on6315/ADEPT_DEP_Module/README.md

# ADEPT_DEP_Module
Adaptable Dielectrophoresis Embedded Platform Tool (ADEPT) 
PCB Hardware design files and corresponding software codes for manufacturing and operating ADEPT for single cell manipulation.
