on6315/ADEPT_DEP_Module/ADEPT_Sotware_Files/ADEPT_Mathematica_File/Readme

Mathematica simulation file with six voltage amplitude manipulators to control the voltage of the six individual electrodes and visualize the electric field pattern.
