on6315/ADEPT_DEP_Module/ADEPT_Sotware_Files/Arduino/Readme

Arduino code along with C++ libary and header file to control the ADEPT.
