on6315/ADEPT_DEP_Module/(threads)

Thread 1 (2023-04-11):

Question about comsol simulation

giannis98, 2023-04-11:
Hello
I am a graduate student in the field of dielectrophoresis, and I am very interested in your thesis. Can you provide the comsol simulation file,？
Best regards

DadachaorenAB2, 2023-11-13:
ui偶i
