on6315/ADEPT_DEP_Module/ADEPT_PCB_Hardware_Files/circuit_DEP-F_Cu.pdf

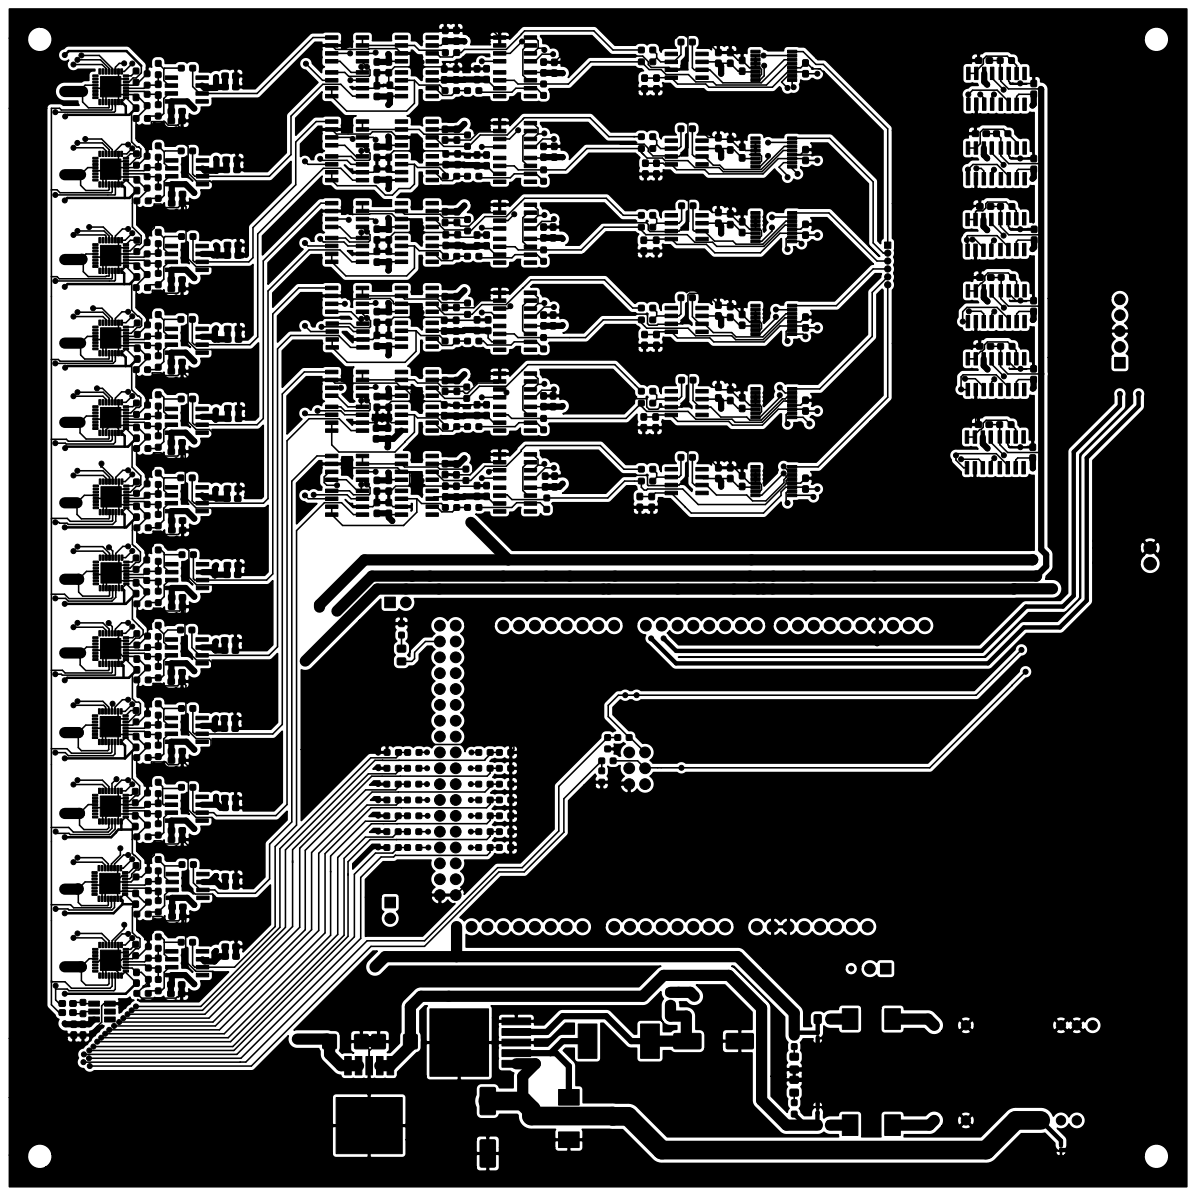
[picture p1: page 1]
