on6315/ADEPT_DEP_Module/ADEPT_PCB_Hardware_Files/circuit_DEP.kicad_pcb

## KiCad design ADEPT_PCB_Hardware_Files/circuit_DEP.kicad_pcb (2023-02-24)

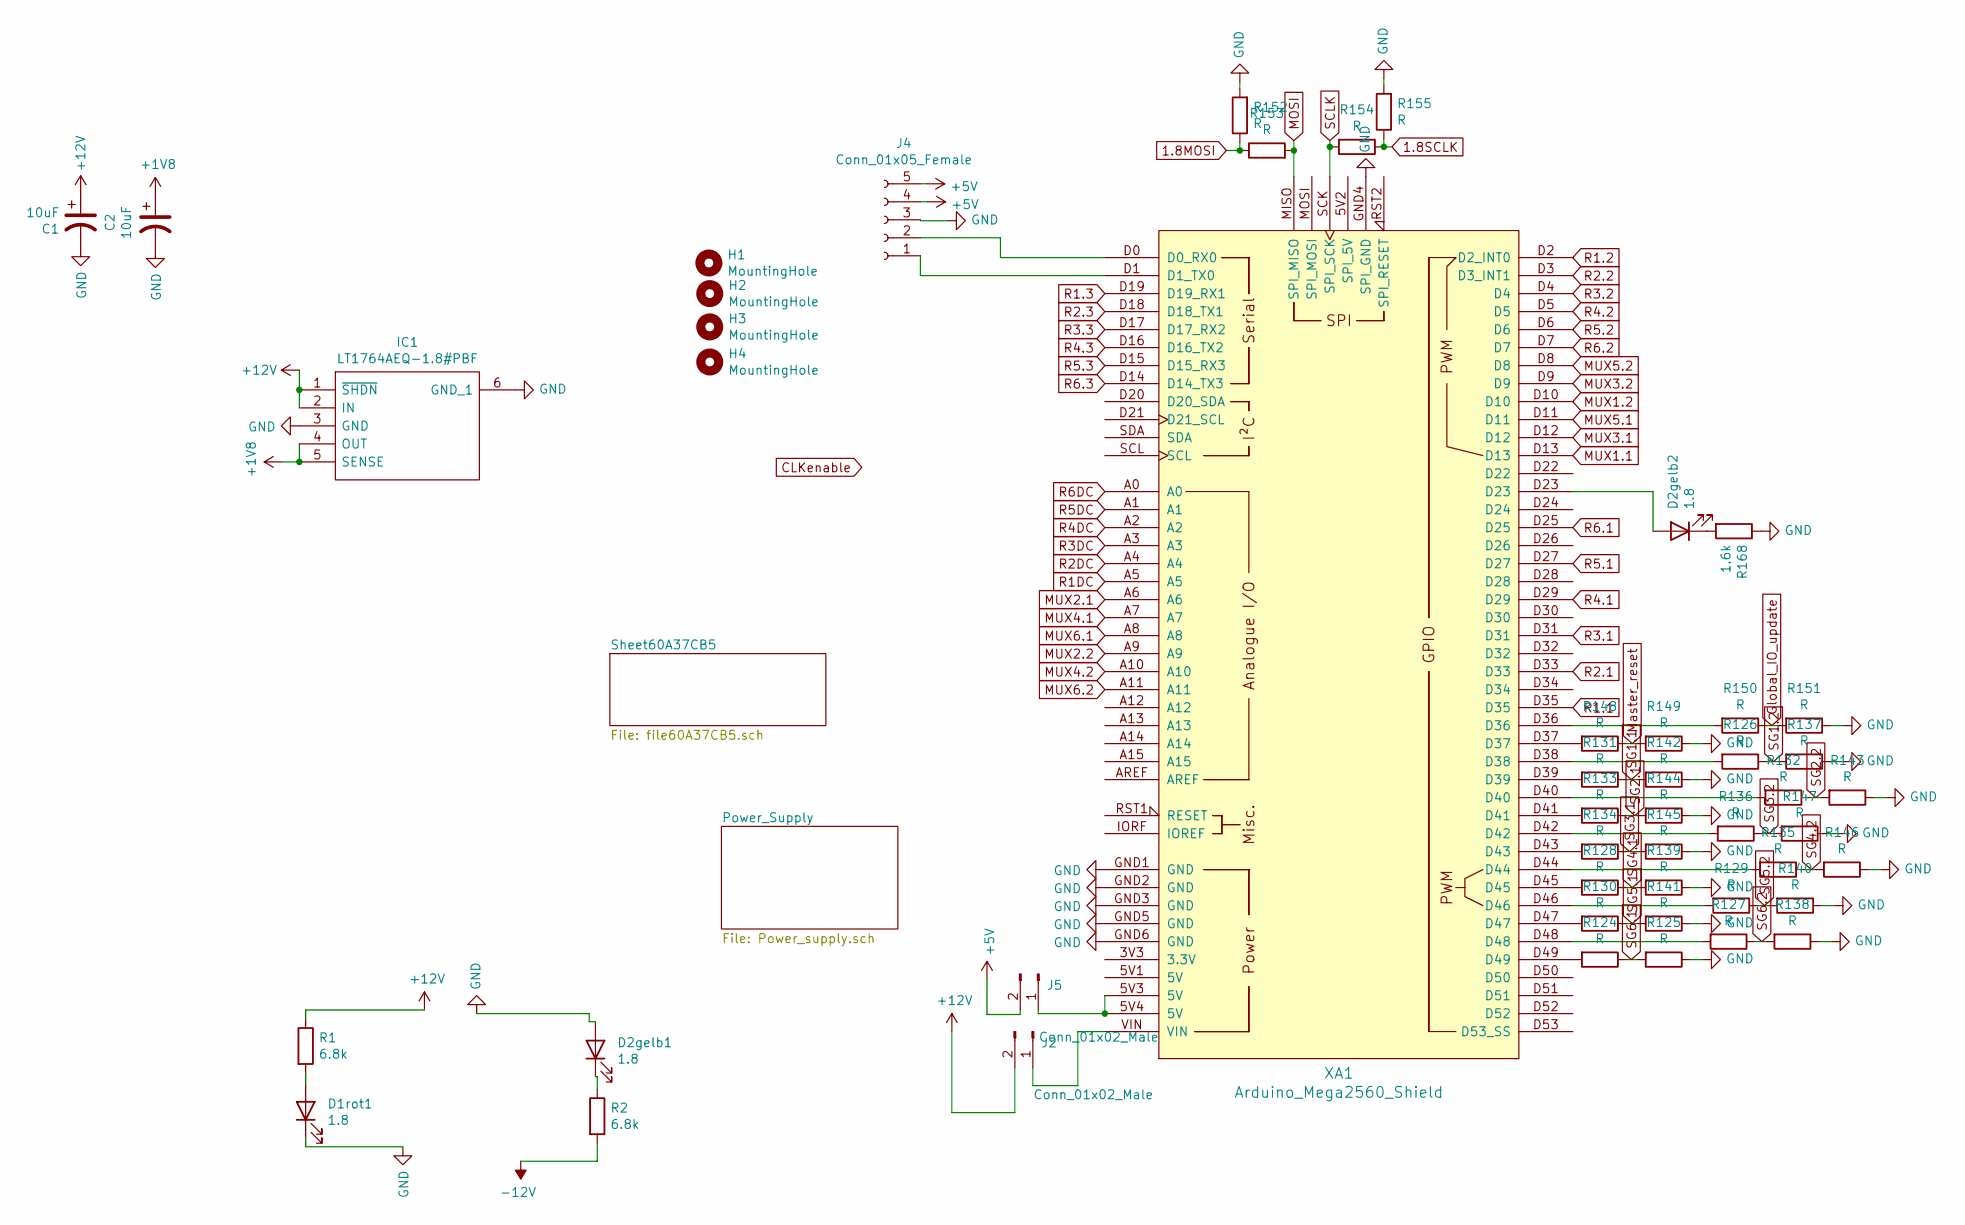
[picture p2: schematic circuit_DEP.sch]

Parts:
C1, C2: 10uF; CP_EIA-6032-28_Kemet-C_Pad2.25x2.35mm_HandSolder
D1rot1, D2gelb1, D2gelb2: 1.8; D_0805_2012Metric_Pad1.15x1.40mm_HandSolder
H1, H2, H3, H4: MountingHole; MountingHole_2.7mm
IC1: LT1764AEQ-1.8#PBF; TO170P1394X457-6N; Manufacturer_Part_Number LT1764AEQ-1.8#PBF; Mouser Part Number 584-LT1764AEQ-1.8PBF
J2, J5: Conn_01x02_Male; PinHeader_1x02_P2.54mm_Vertical
J4: Conn_01x05_Female; PinSocket_1x05_P2.54mm_Vertical
R1, R2: 6.8k; R_0603_1608Metric_Pad0.98x0.95mm_HandSolder
R124, R125, R126, R127, R128, R129, R130, R131, R132, R133, R134, R135, R136, R137, R138, R139, R140, R141, R142, R143, R144, R145, R146, R147, R148, R149, R150, R151, R152, R153, R154, R155: R; R_0603_1608Metric_Pad0.98x0.95mm_HandSolder
R168: 1.6k; R_0603_1608Metric_Pad0.98x0.95mm_HandSolder
XA1: Arduino_Mega2560_Shield

Connections:
1.8MOSI: R152.1, R153.1; also elsewhere on the board
1.8SCLK: R154.1, R155.1; also elsewhere on the board
+1V8: C2.1, IC1.4 (OUT), IC1.5 (SENSE); also elsewhere on the board
+5V: J4.4, J4.5, J5.2; also elsewhere on the board
+12V: C1.1, IC1.1 (~SHDN), IC1.2 (IN), J2.2, R1.1; also elsewhere on the board
-12V: R2.2; also elsewhere on the board
GND: C1.2, C2.2, D1rot1.1 (K), D2gelb1.2 (A), IC1.3 (GND), IC1.6 (GND_1), J4.3, R125.1, R137.1, R138.1, R139.1, R140.1, R141.1, R142.1, R143.1, R144.1, R145.1, R146.1, R147.1, R149.1, R151.1, R152.2, R155.2, R168.1, XA1.GND1 (GND), XA1.GND2 (GND), XA1.GND3 (GND), XA1.GND4 (SPI_GND), XA1.GND5 (GND), XA1.GND6 (GND); also elsewhere on the board
Global_IO_update: R150.1, R151.2; also elsewhere on the board
MOSI: R153.2, XA1.MISO (SPI_MISO); also elsewhere on the board
MUX1.1: XA1.D13; also elsewhere on the board
MUX1.2: XA1.D10; also elsewhere on the board
MUX2.1: XA1.A6; also elsewhere on the board
MUX2.2: XA1.A9; also elsewhere on the board
MUX3.1: XA1.D12; also elsewhere on the board
MUX3.2: XA1.D9; also elsewhere on the board
MUX4.1: XA1.A7; also elsewhere on the board
MUX4.2: XA1.A10; also elsewhere on the board
MUX5.1: XA1.D11; also elsewhere on the board
MUX5.2: XA1.D8; also elsewhere on the board
MUX6.1: XA1.A8; also elsewhere on the board
MUX6.2: XA1.A11; also elsewhere on the board
Master_reset: R148.1, R149.2; also elsewhere on the board
unnamed: D1rot1.2 (A), R1.2
unnamed: D2gelb1.1 (K), R2.1
unnamed: D2gelb2.1 (K), R168.2
unnamed: D2gelb2.2 (A), XA1.D23
unnamed: J2.1, XA1.VIN
unnamed: J4.1, XA1.D1 (D1_TX0)
unnamed: J4.2, XA1.D0 (D0_RX0)
unnamed: J5.1, XA1.5V3 (5V), XA1.5V4 (5V)
unnamed: R124.2, XA1.D49
unnamed: R126.2, XA1.D38
unnamed: R127.2, XA1.D48
unnamed: R128.2, XA1.D45
unnamed: R129.2, XA1.D46
unnamed: R130.2, XA1.D47
unnamed: R131.2, XA1.D39
unnamed: R132.2, XA1.D40
unnamed: R133.2, XA1.D41
unnamed: R134.2, XA1.D43
unnamed: R135.2, XA1.D44
unnamed: R136.2, XA1.D42
unnamed: R148.2, XA1.D37
unnamed: R150.2, XA1.D36
R1.1: XA1.D35; also elsewhere on the board
R1.2: XA1.D2 (D2_INT0); also elsewhere on the board
R1.3: XA1.D19 (D19_RX1); also elsewhere on the board
R1DC: XA1.A5; also elsewhere on the board
R2.1: XA1.D33; also elsewhere on the board
R2.2: XA1.D3 (D3_INT1); also elsewhere on the board
R2.3: XA1.D18 (D18_TX1); also elsewhere on the board
R2DC: XA1.A4; also elsewhere on the board
R3.1: XA1.D31; also elsewhere on the board
R3.2: XA1.D4; also elsewhere on the board
R3.3: XA1.D17 (D17_RX2); also elsewhere on the board
R3DC: XA1.A3; also elsewhere on the board
R4.1: XA1.D29; also elsewhere on the board
R4.2: XA1.D5; also elsewhere on the board
R4.3: XA1.D16 (D16_TX2); also elsewhere on the board
R4DC: XA1.A2; also elsewhere on the board
R5.1: XA1.D27; also elsewhere on the board
R5.2: XA1.D6; also elsewhere on the board
R5.3: XA1.D15 (D15_RX3); also elsewhere on the board
R5DC: XA1.A1; also elsewhere on the board
R6.1: XA1.D25; also elsewhere on the board
R6.2: XA1.D7; also elsewhere on the board
R6.3: XA1.D14 (D14_TX3); also elsewhere on the board
R6DC: XA1.A0; also elsewhere on the board
SCLK: R154.2, XA1.SCK (SPI_SCK); also elsewhere on the board
SG1.1: R131.1, R142.2; also elsewhere on the board
SG1.2: R126.1, R137.2; also elsewhere on the board
SG2.1: R133.1, R144.2; also elsewhere on the board
SG2.2: R132.1, R143.2; also elsewhere on the board
SG3.1: R134.1, R145.2; also elsewhere on the board
SG3.2: R136.1, R147.2; also elsewhere on the board
SG4.1: R128.1, R139.2; also elsewhere on the board
SG4.2: R135.1, R146.2; also elsewhere on the board
SG5.1: R130.1, R141.2; also elsewhere on the board
SG5.2: R129.1, R140.2; also elsewhere on the board
SG6.1: R124.1, R125.2; also elsewhere on the board
SG6.2: R127.1, R138.2; also elsewhere on the board

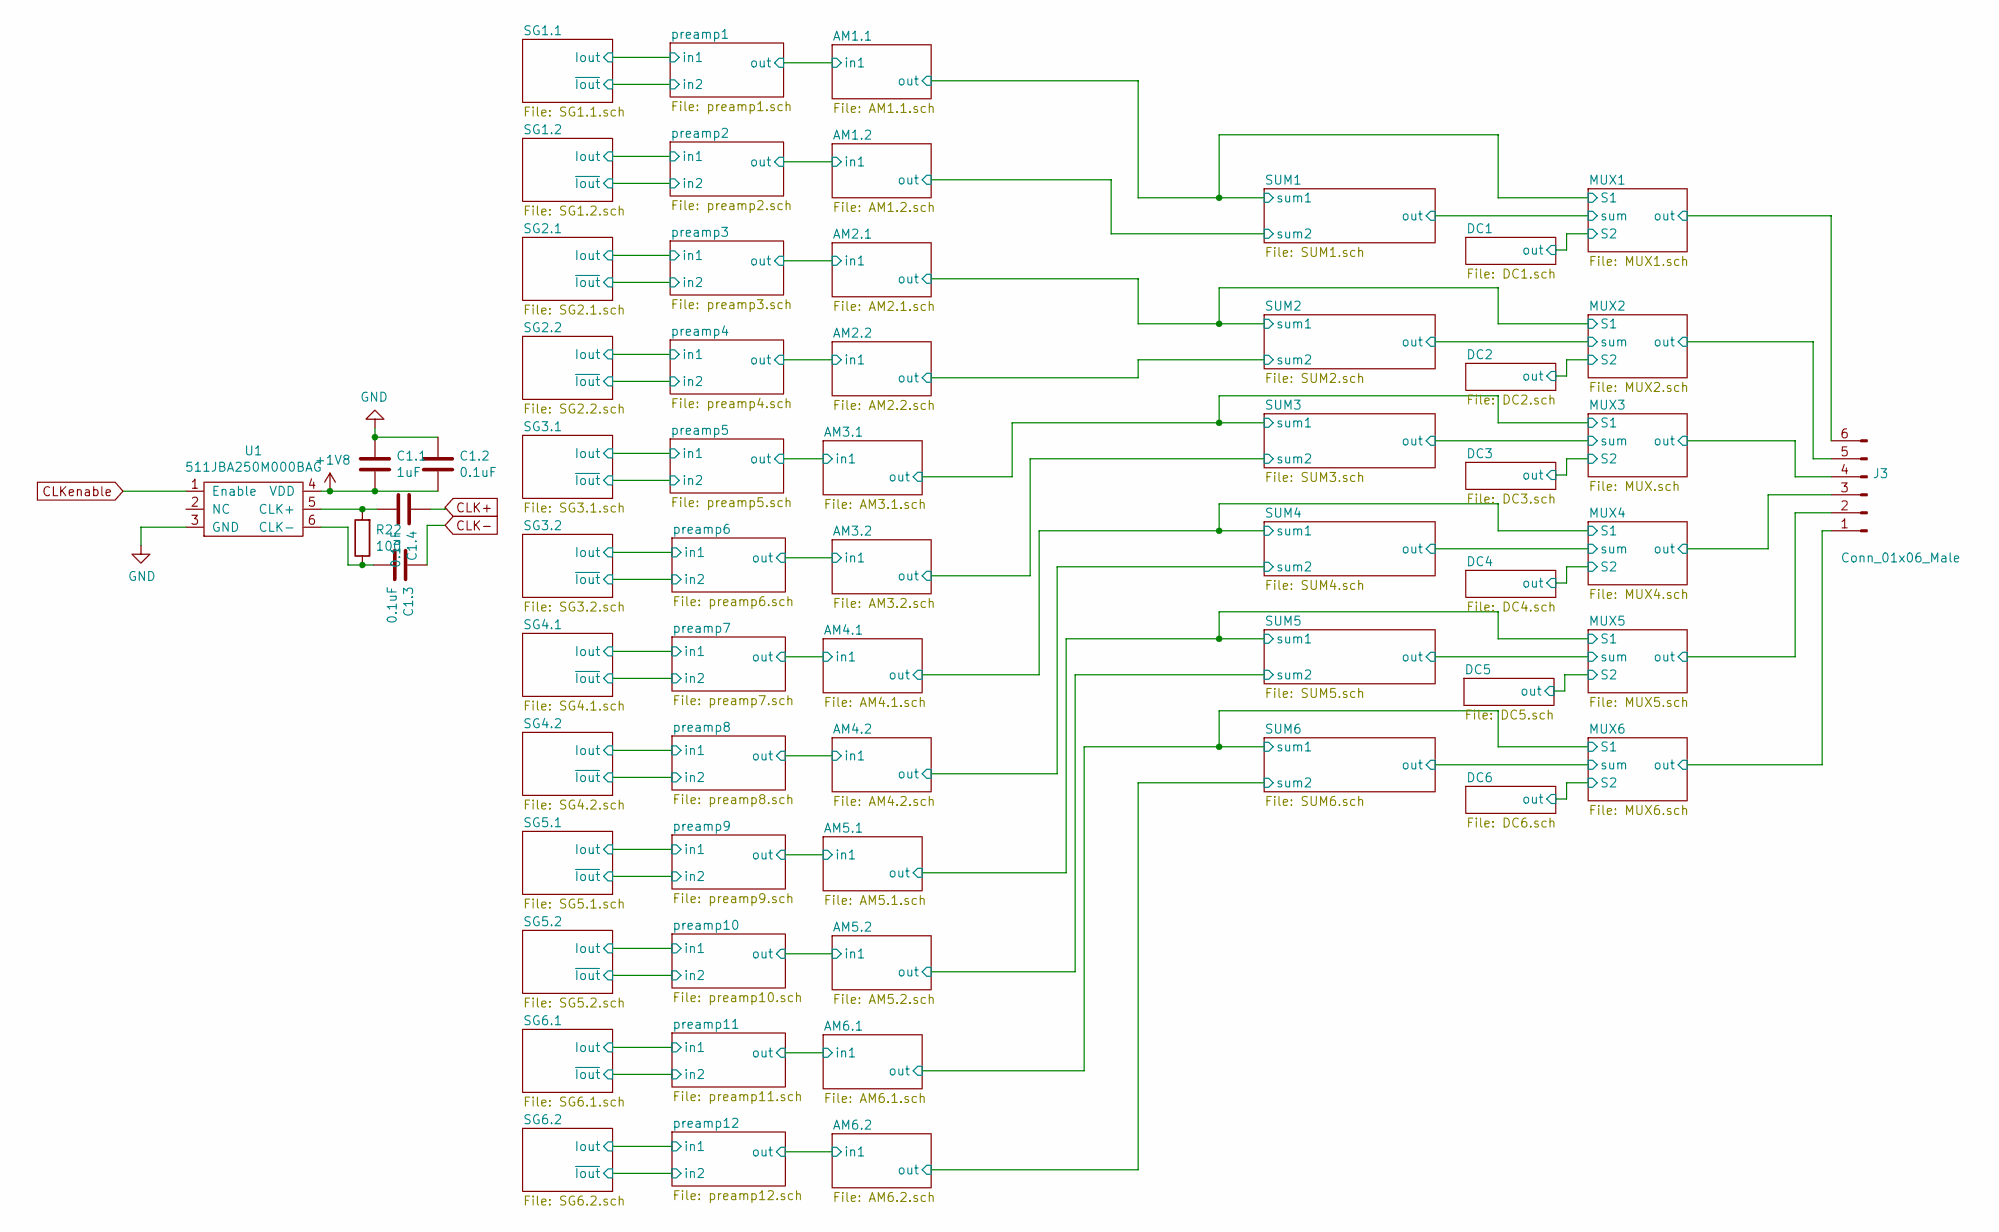
[picture p3: schematic file60A37CB5.sch]

Parts:
C1.1: 1uF; C_0603_1608Metric_Pad1.08x0.95mm_HandSolder
C1.2, C1.3, C1.4: 0.1uF; C_0603_1608Metric_Pad1.08x0.95mm_HandSolder
J3: Conn_01x06_Male; PinHeader_1x06_P1.27mm_Vertical
R22: 100; R_0603_1608Metric_Pad0.98x0.95mm_HandSolder
U1: 511JBA250M000BAG

Connections:
+1V8: C1.1.2, C1.2.2, U1.4 (VDD); also elsewhere on the board
/Sheet60A37CB5/MUX1/out: J3.6; also elsewhere on the board
/Sheet60A37CB5/MUX2/out: J3.5; also elsewhere on the board
/Sheet60A37CB5/MUX3/out: J3.4; also elsewhere on the board
/Sheet60A37CB5/MUX4/out: J3.3; also elsewhere on the board
/Sheet60A37CB5/MUX5/out: J3.2; also elsewhere on the board
/Sheet60A37CB5/MUX6/out: J3.1; also elsewhere on the board
CLK+: C1.4.1; also elsewhere on the board
CLK-: C1.3.1; also elsewhere on the board
CLKenable: U1.1 (Enable)
GND: C1.1.1, C1.2.1, U1.3 (GND); also elsewhere on the board
unnamed: C1.3.2, R22.1, U1.6 (CLK-)
unnamed: C1.4.2, R22.2, U1.5 (CLK+)

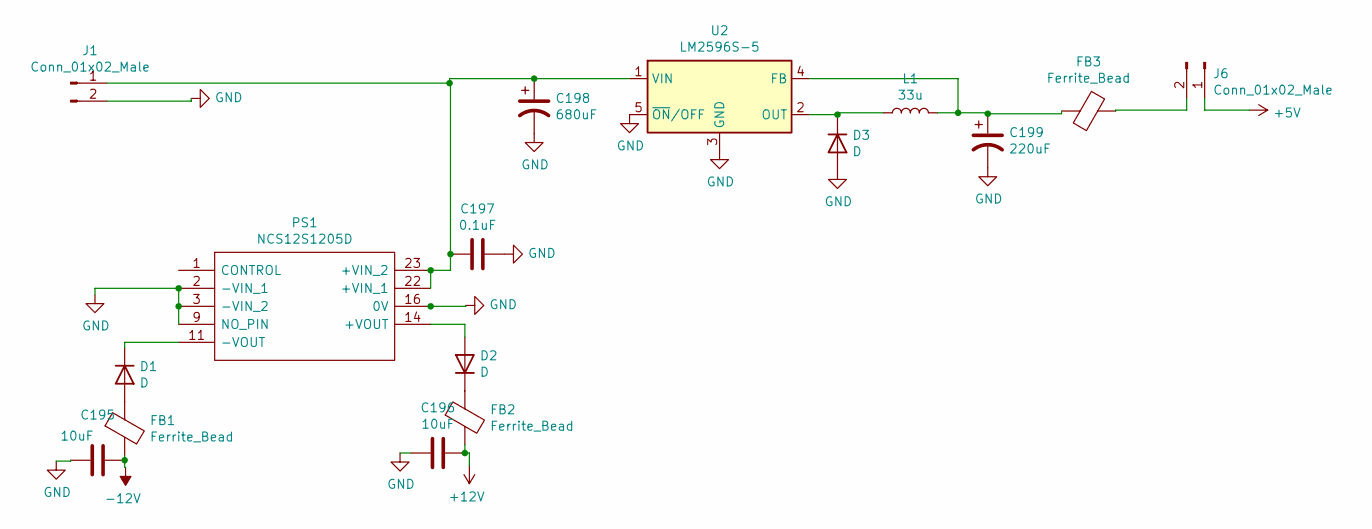
[picture p4: schematic Power_supply.sch]

Parts:
C195, C196: 10uF; C_0201_0603Metric_Pad0.64x0.40mm_HandSolder
C197: 0.1uF; C_0201_0603Metric_Pad0.64x0.40mm_HandSolder
C198: 680uF; CP_Elec_10x10.5
C199: 220uF; CP_Elec_10x10.5
D1, D2, D3: D; D_SMC
FB1, FB2, FB3: Ferrite_Bead; C_0805_2012Metric_Pad1.18x1.45mm_HandSolder
J1: Conn_01x02_Male; con_supply
J6: Conn_01x02_Male; PinSocket_1x02_P2.54mm_Vertical
L1: 33u; inductor_gen
PS1: NCS12S1205D; NCS12D1212C; Manufacturer_Part_Number NCS12S1205C; Mouser Part Number 580-NCS12S1205C
U2: LM2596S-5; TO-263-5_TabPin3

Connections:
+5V: J6.1; also elsewhere on the board
+12V: C196.1, FB2.2; also elsewhere on the board
-12V: C195.1, FB1.2; also elsewhere on the board
GND: C195.2, C196.2, C197.1, C198.2, C199.2, D3.2 (A), J1.2, PS1.2 (-VIN_1), PS1.3 (-VIN_2), PS1.9 (NO_PIN), PS1.16 (0V), U2.3 (GND), U2.5 (~ON~/OFF); also elsewhere on the board
unnamed: C197.2, C198.1, J1.1, PS1.22 (+VIN_1), PS1.23 (+VIN_2), U2.1 (VIN)
unnamed: C199.1, FB3.2, L1.2, U2.4 (FB)
unnamed: D1.1 (K), PS1.11 (-VOUT)
unnamed: D1.2 (A), FB1.1
unnamed: D2.1 (K), FB2.1
unnamed: D2.2 (A), PS1.14 (+VOUT)
unnamed: D3.1 (K), L1.1, U2.2 (OUT)
unnamed: FB3.1, J6.2

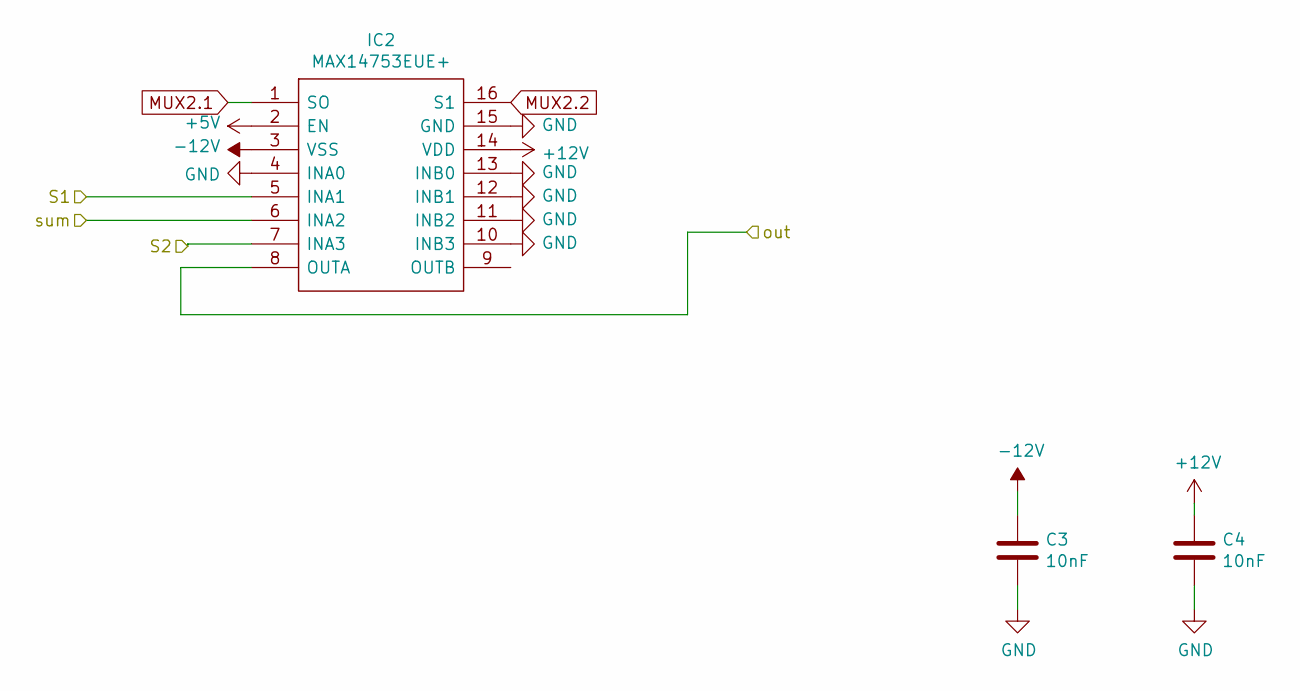
[picture p5: schematic MUX2.sch]

Parts:
C3, C4: 10nF; C_0603_1608Metric_Pad1.08x0.95mm_HandSolder
IC2: MAX14753EUE+; SOP65P640X110-16N; Manufacturer_Part_Number MAX14753EUE+; Mouser Part Number 700-MAX14753EUE

Connections:
+5V: IC2.2 (EN); also elsewhere on the board
+12V: C4.1, IC2.14 (VDD); also elsewhere on the board
-12V: C3.1, IC2.3 (VSS); also elsewhere on the board
/Sheet60A37CB5/MUX2/S1: IC2.5 (INA1); also elsewhere on the board
/Sheet60A37CB5/MUX2/S2: IC2.7 (INA3); also elsewhere on the board
/Sheet60A37CB5/MUX2/out: IC2.8 (OUTA); also elsewhere on the board
/Sheet60A37CB5/SUM2/out: IC2.6 (INA2); also elsewhere on the board
GND: C3.2, C4.2, IC2.4 (INA0), IC2.10 (INB3), IC2.11 (INB2), IC2.12 (INB1), IC2.13 (INB0), IC2.15 (GND); also elsewhere on the board
MUX2.1: IC2.1 (SO); also elsewhere on the board
MUX2.2: IC2.16 (S1); also elsewhere on the board

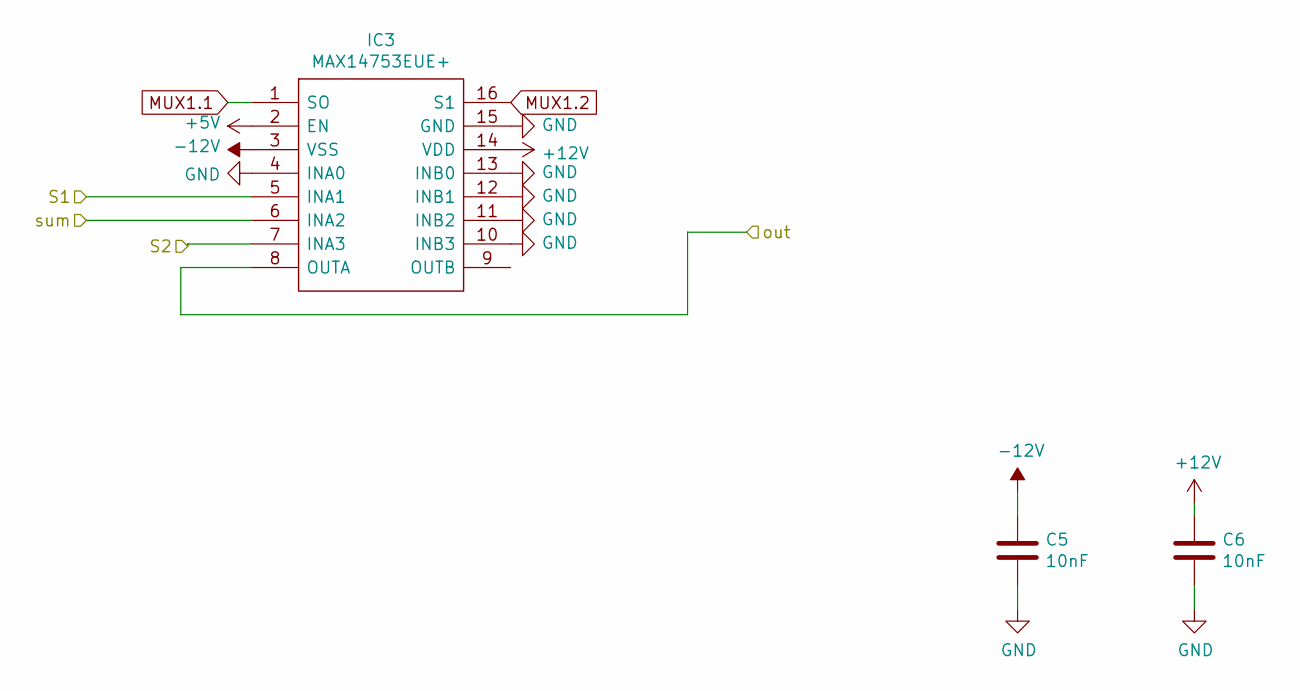
[picture p6: schematic MUX1.sch]

Parts:
C5, C6: 10nF; C_0603_1608Metric_Pad1.08x0.95mm_HandSolder
IC3: MAX14753EUE+; SOP65P640X110-16N; Manufacturer_Part_Number MAX14753EUE+; Mouser Part Number 700-MAX14753EUE

Connections:
+5V: IC3.2 (EN); also elsewhere on the board
+12V: C6.1, IC3.14 (VDD); also elsewhere on the board
-12V: C5.1, IC3.3 (VSS); also elsewhere on the board
/Sheet60A37CB5/MUX1/S1: IC3.5 (INA1); also elsewhere on the board
/Sheet60A37CB5/MUX1/S2: IC3.7 (INA3); also elsewhere on the board
/Sheet60A37CB5/MUX1/out: IC3.8 (OUTA); also elsewhere on the board
/Sheet60A37CB5/SUM1/out: IC3.6 (INA2); also elsewhere on the board
GND: C5.2, C6.2, IC3.4 (INA0), IC3.10 (INB3), IC3.11 (INB2), IC3.12 (INB1), IC3.13 (INB0), IC3.15 (GND); also elsewhere on the board
MUX1.1: IC3.1 (SO); also elsewhere on the board
MUX1.2: IC3.16 (S1); also elsewhere on the board

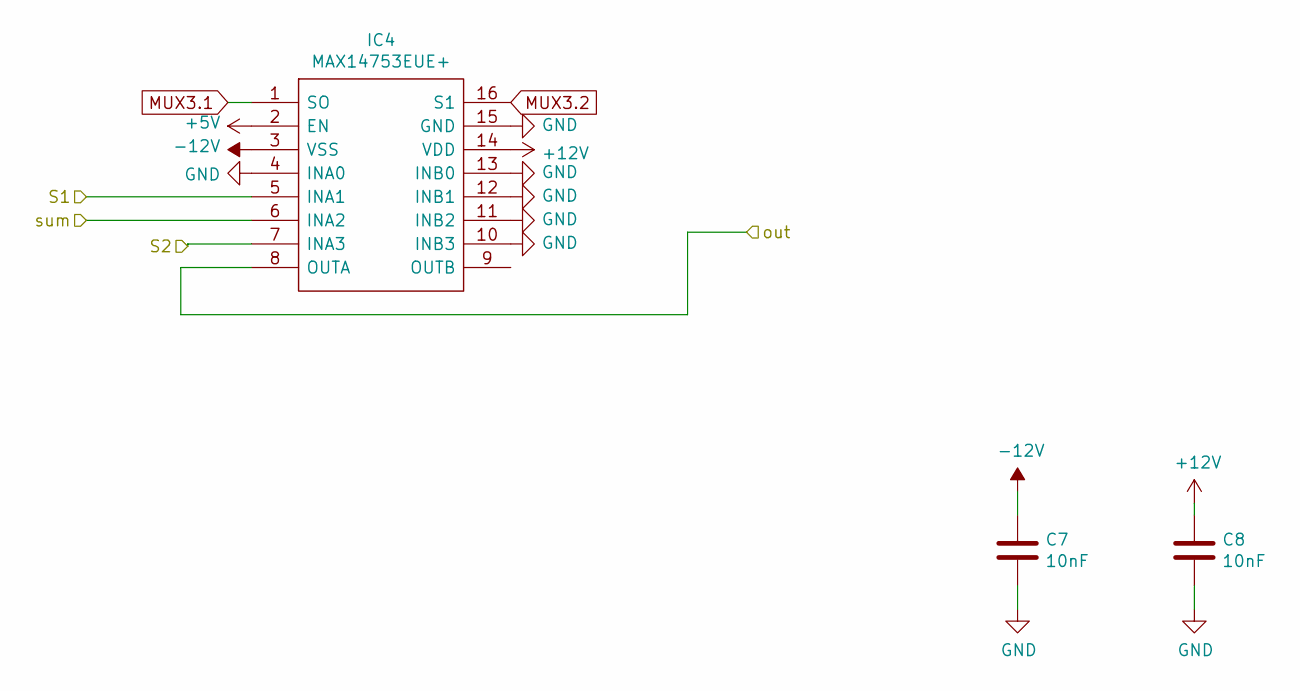
[picture p7: schematic MUX.sch]

Parts:
C7, C8: 10nF; C_0603_1608Metric_Pad1.08x0.95mm_HandSolder
IC4: MAX14753EUE+; SOP65P640X110-16N; Manufacturer_Part_Number MAX14753EUE+; Mouser Part Number 700-MAX14753EUE

Connections:
+5V: IC4.2 (EN); also elsewhere on the board
+12V: C8.1, IC4.14 (VDD); also elsewhere on the board
-12V: C7.1, IC4.3 (VSS); also elsewhere on the board
/Sheet60A37CB5/MUX3/S1: IC4.5 (INA1); also elsewhere on the board
/Sheet60A37CB5/MUX3/S2: IC4.7 (INA3); also elsewhere on the board
/Sheet60A37CB5/MUX3/out: IC4.8 (OUTA); also elsewhere on the board
/Sheet60A37CB5/SUM3/out: IC4.6 (INA2); also elsewhere on the board
GND: C7.2, C8.2, IC4.4 (INA0), IC4.10 (INB3), IC4.11 (INB2), IC4.12 (INB1), IC4.13 (INB0), IC4.15 (GND); also elsewhere on the board
MUX3.1: IC4.1 (SO); also elsewhere on the board
MUX3.2: IC4.16 (S1); also elsewhere on the board

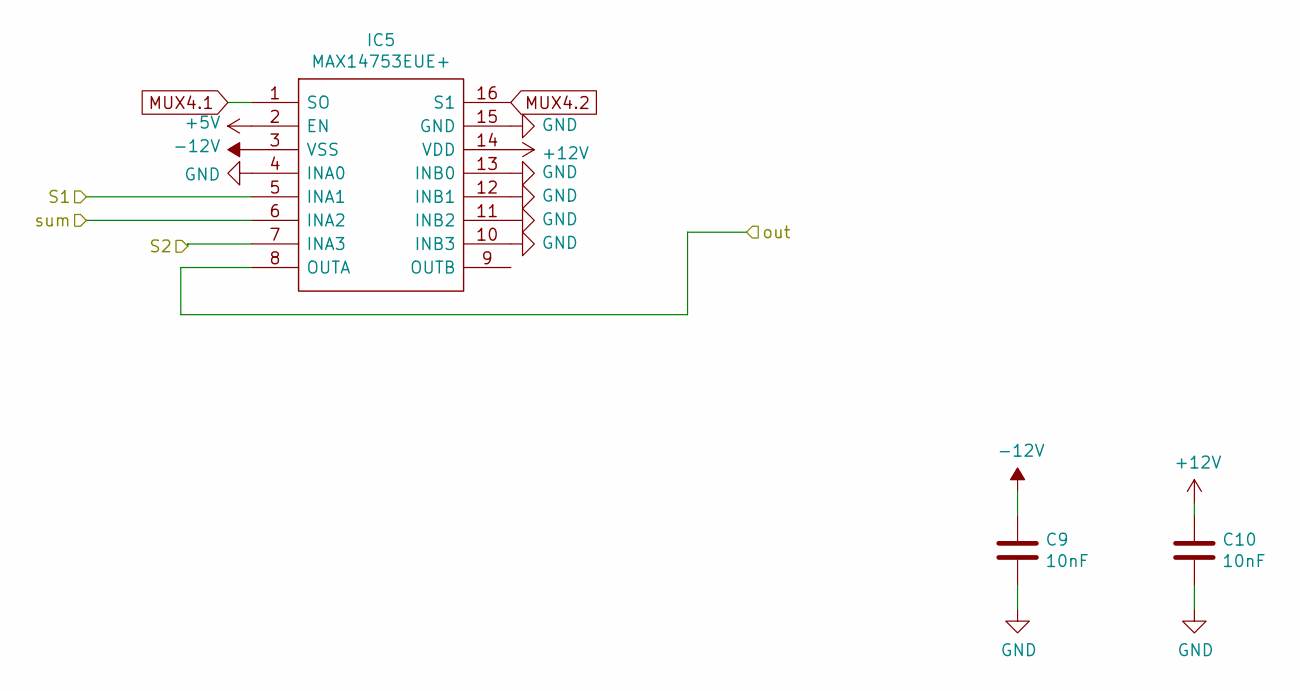
[picture p8: schematic MUX4.sch]

Parts:
C9, C10: 10nF; C_0603_1608Metric_Pad1.08x0.95mm_HandSolder
IC5: MAX14753EUE+; SOP65P640X110-16N; Manufacturer_Part_Number MAX14753EUE+; Mouser Part Number 700-MAX14753EUE

Connections:
+5V: IC5.2 (EN); also elsewhere on the board
+12V: C10.1, IC5.14 (VDD); also elsewhere on the board
-12V: C9.1, IC5.3 (VSS); also elsewhere on the board
/Sheet60A37CB5/MUX4/S1: IC5.5 (INA1); also elsewhere on the board
/Sheet60A37CB5/MUX4/S2: IC5.7 (INA3); also elsewhere on the board
/Sheet60A37CB5/MUX4/out: IC5.8 (OUTA); also elsewhere on the board
/Sheet60A37CB5/SUM4/out: IC5.6 (INA2); also elsewhere on the board
GND: C9.2, C10.2, IC5.4 (INA0), IC5.10 (INB3), IC5.11 (INB2), IC5.12 (INB1), IC5.13 (INB0), IC5.15 (GND); also elsewhere on the board
MUX4.1: IC5.1 (SO); also elsewhere on the board
MUX4.2: IC5.16 (S1); also elsewhere on the board

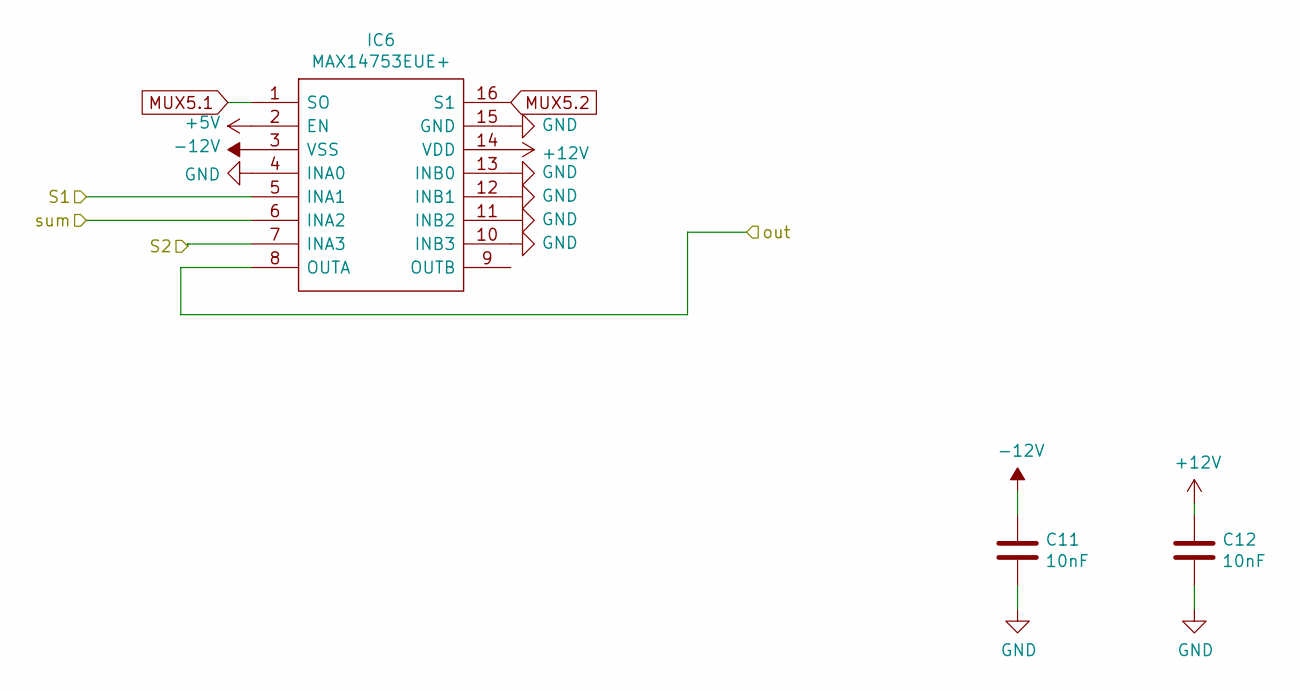
[picture p9: schematic MUX5.sch]

Parts:
C11, C12: 10nF; C_0603_1608Metric_Pad1.08x0.95mm_HandSolder
IC6: MAX14753EUE+; SOP65P640X110-16N; Manufacturer_Part_Number MAX14753EUE+; Mouser Part Number 700-MAX14753EUE

Connections:
+5V: IC6.2 (EN); also elsewhere on the board
+12V: C12.1, IC6.14 (VDD); also elsewhere on the board
-12V: C11.1, IC6.3 (VSS); also elsewhere on the board
/Sheet60A37CB5/MUX5/S1: IC6.5 (INA1); also elsewhere on the board
/Sheet60A37CB5/MUX5/S2: IC6.7 (INA3); also elsewhere on the board
/Sheet60A37CB5/MUX5/out: IC6.8 (OUTA); also elsewhere on the board
/Sheet60A37CB5/SUM5/out: IC6.6 (INA2); also elsewhere on the board
GND: C11.2, C12.2, IC6.4 (INA0), IC6.10 (INB3), IC6.11 (INB2), IC6.12 (INB1), IC6.13 (INB0), IC6.15 (GND); also elsewhere on the board
MUX5.1: IC6.1 (SO); also elsewhere on the board
MUX5.2: IC6.16 (S1); also elsewhere on the board

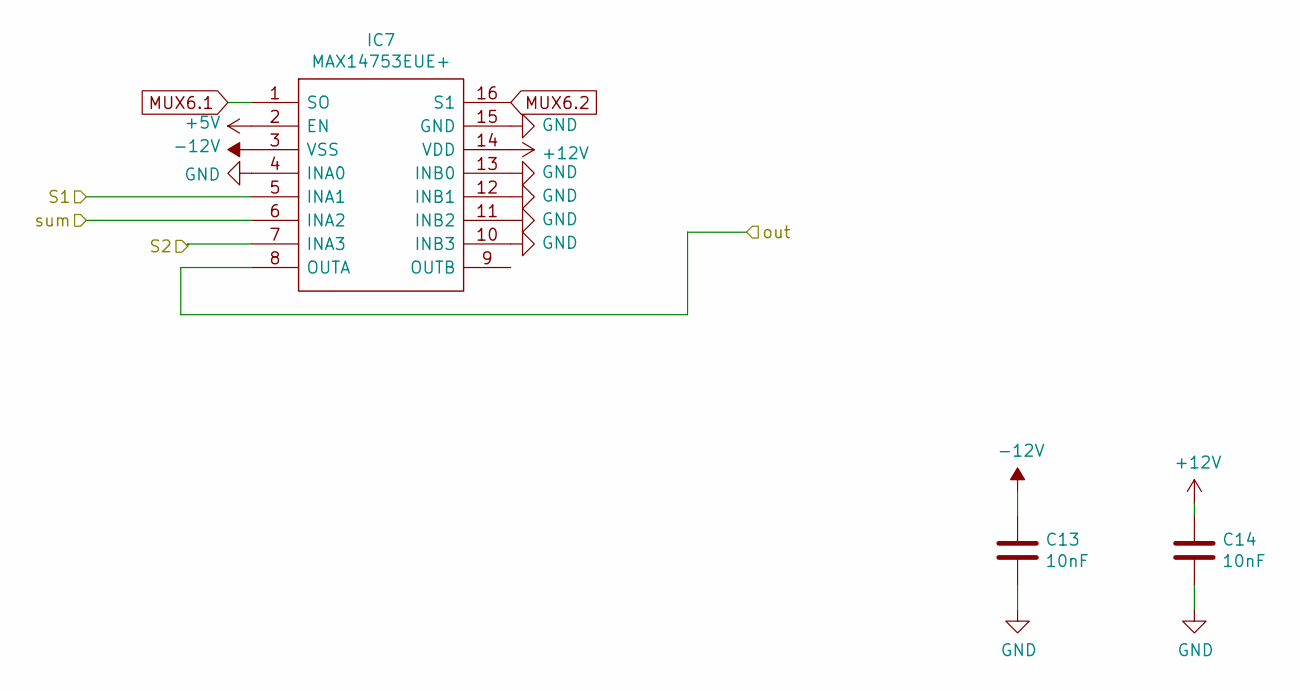
[picture p10: schematic MUX6.sch]

Parts:
C13, C14: 10nF; C_0603_1608Metric_Pad1.08x0.95mm_HandSolder
IC7: MAX14753EUE+; SOP65P640X110-16N; Manufacturer_Part_Number MAX14753EUE+; Mouser Part Number 700-MAX14753EUE

Connections:
+5V: IC7.2 (EN); also elsewhere on the board
+12V: C14.1, IC7.14 (VDD); also elsewhere on the board
-12V: C13.1, IC7.3 (VSS); also elsewhere on the board
/Sheet60A37CB5/MUX6/S1: IC7.5 (INA1); also elsewhere on the board
/Sheet60A37CB5/MUX6/S2: IC7.7 (INA3); also elsewhere on the board
/Sheet60A37CB5/MUX6/out: IC7.8 (OUTA); also elsewhere on the board
/Sheet60A37CB5/SUM6/out: IC7.6 (INA2); also elsewhere on the board
GND: C13.2, C14.2, IC7.4 (INA0), IC7.10 (INB3), IC7.11 (INB2), IC7.12 (INB1), IC7.13 (INB0), IC7.15 (GND); also elsewhere on the board
MUX6.1: IC7.1 (SO); also elsewhere on the board
MUX6.2: IC7.16 (S1); also elsewhere on the board

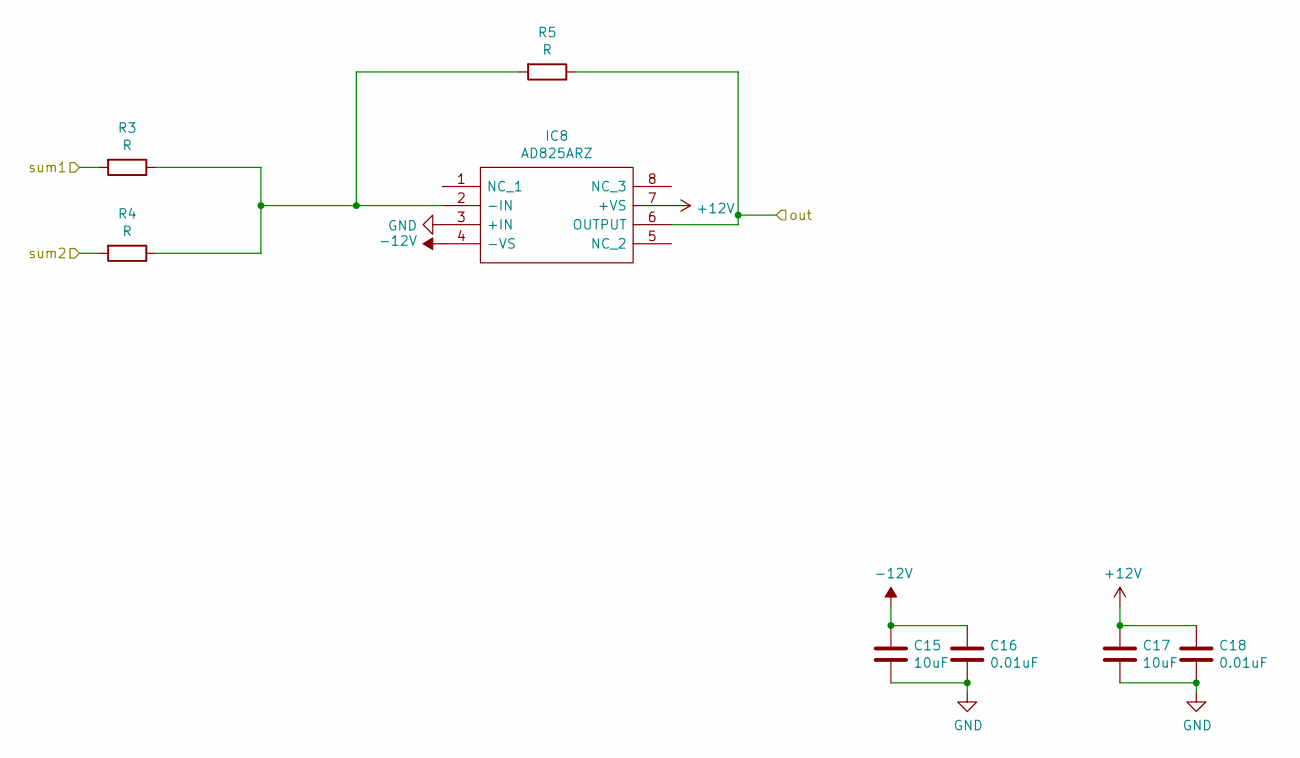
[picture p11: schematic SUM1.sch]

Parts:
C15, C17: 10uF; C_0603_1608Metric_Pad1.08x0.95mm_HandSolder
C16, C18: 0.01uF; C_0603_1608Metric_Pad1.08x0.95mm_HandSolder
IC8: AD825ARZ; SOIC127P600X175-8N; Manufacturer_Part_Number AD825ARZ; Mouser Part Number 584-AD825ARZ
R3, R4, R5: R; R_0603_1608Metric_Pad0.98x0.95mm_HandSolder

Connections:
+12V: C17.1, C18.1, IC8.7 (+VS); also elsewhere on the board
-12V: C15.1, C16.1, IC8.4 (-VS); also elsewhere on the board
/Sheet60A37CB5/AM1.2/out: R4.2; also elsewhere on the board
/Sheet60A37CB5/MUX1/S1: R3.2; also elsewhere on the board
/Sheet60A37CB5/SUM1/out: IC8.6 (OUTPUT), R5.1; also elsewhere on the board
GND: C15.2, C16.2, C17.2, C18.2, IC8.3 (+IN); also elsewhere on the board
unnamed: IC8.2 (-IN), R3.1, R4.1, R5.2

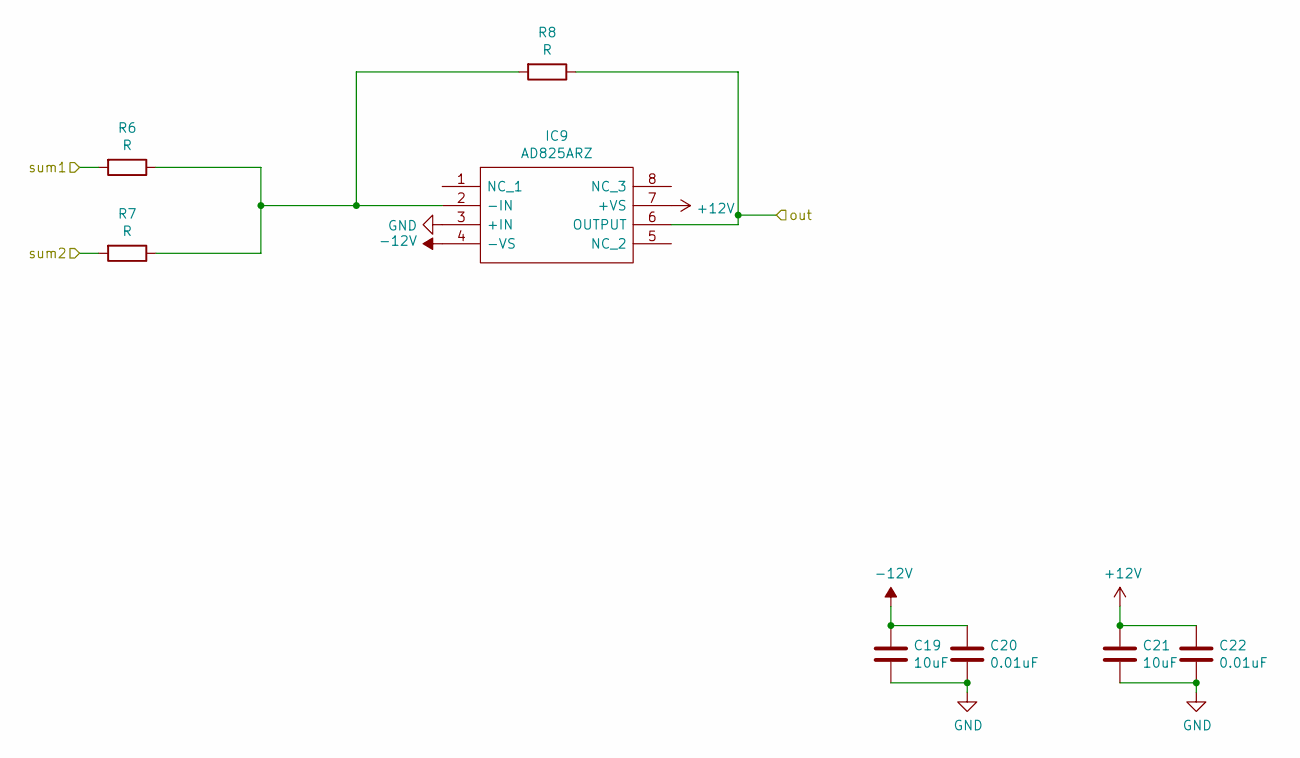
[picture p12: schematic SUM2.sch]

Parts:
C19, C21: 10uF; C_0603_1608Metric_Pad1.08x0.95mm_HandSolder
C20, C22: 0.01uF; C_0603_1608Metric_Pad1.08x0.95mm_HandSolder
IC9: AD825ARZ; SOIC127P600X175-8N; Manufacturer_Part_Number AD825ARZ; Mouser Part Number 584-AD825ARZ
R6, R7, R8: R; R_0603_1608Metric_Pad0.98x0.95mm_HandSolder

Connections:
+12V: C21.1, C22.1, IC9.7 (+VS); also elsewhere on the board
-12V: C19.1, C20.1, IC9.4 (-VS); also elsewhere on the board
/Sheet60A37CB5/AM2.2/out: R7.2; also elsewhere on the board
/Sheet60A37CB5/MUX2/S1: R6.2; also elsewhere on the board
/Sheet60A37CB5/SUM2/out: IC9.6 (OUTPUT), R8.1; also elsewhere on the board
GND: C19.2, C20.2, C21.2, C22.2, IC9.3 (+IN); also elsewhere on the board
unnamed: IC9.2 (-IN), R6.1, R7.1, R8.2

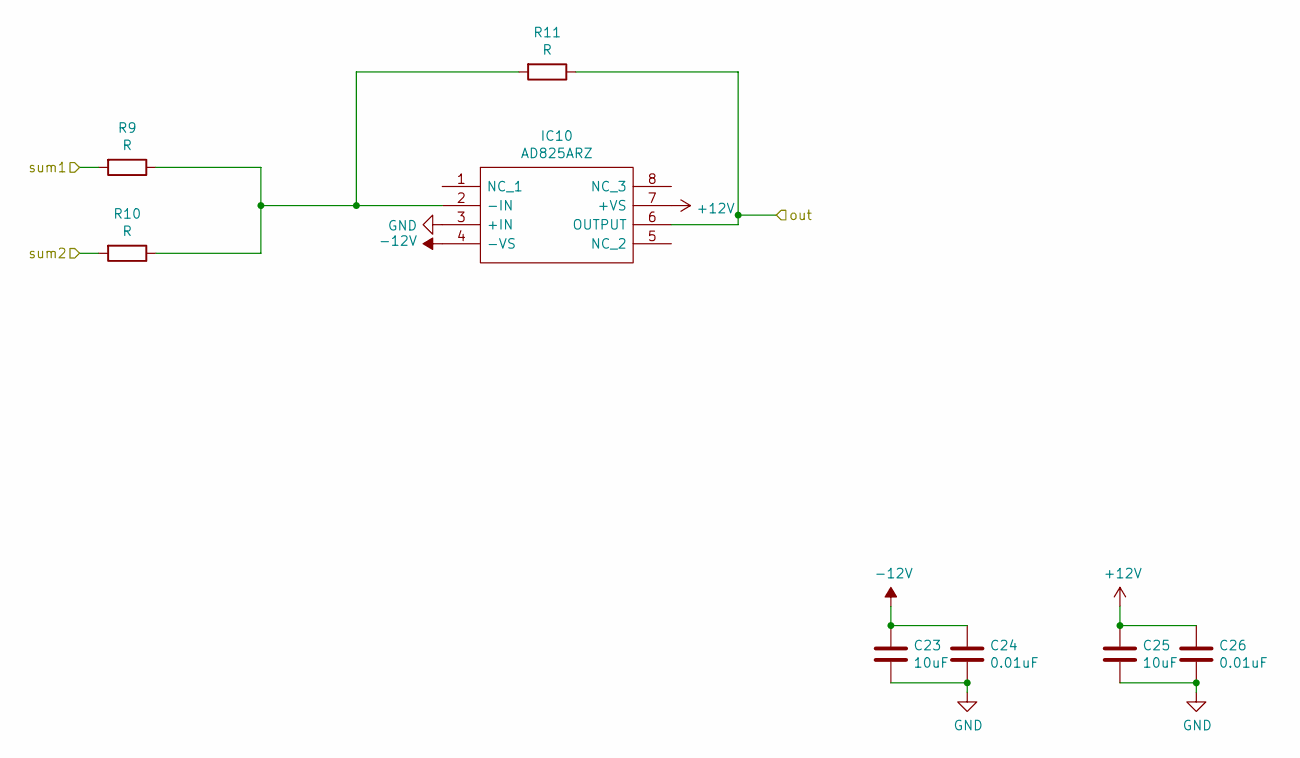
[picture p13: schematic SUM3.sch]

Parts:
C23, C25: 10uF; C_0603_1608Metric_Pad1.08x0.95mm_HandSolder
C24, C26: 0.01uF; C_0603_1608Metric_Pad1.08x0.95mm_HandSolder
IC10: AD825ARZ; SOIC127P600X175-8N; Manufacturer_Part_Number AD825ARZ; Mouser Part Number 584-AD825ARZ
R9, R10, R11: R; R_0603_1608Metric_Pad0.98x0.95mm_HandSolder

Connections:
+12V: C25.1, C26.1, IC10.7 (+VS); also elsewhere on the board
-12V: C23.1, C24.1, IC10.4 (-VS); also elsewhere on the board
/Sheet60A37CB5/AM3.2/out: R10.2; also elsewhere on the board
/Sheet60A37CB5/MUX3/S1: R9.2; also elsewhere on the board
/Sheet60A37CB5/SUM3/out: IC10.6 (OUTPUT), R11.1; also elsewhere on the board
GND: C23.2, C24.2, C25.2, C26.2, IC10.3 (+IN); also elsewhere on the board
unnamed: IC10.2 (-IN), R9.1, R10.1, R11.2
