on6315/ADEPT_DEP_Module/ADEPT_PCB_Hardware_Files/circuit_DEP.kicad_pcb

## KiCad design ADEPT_PCB_Hardware_Files/circuit_DEP.kicad_pcb (continued)

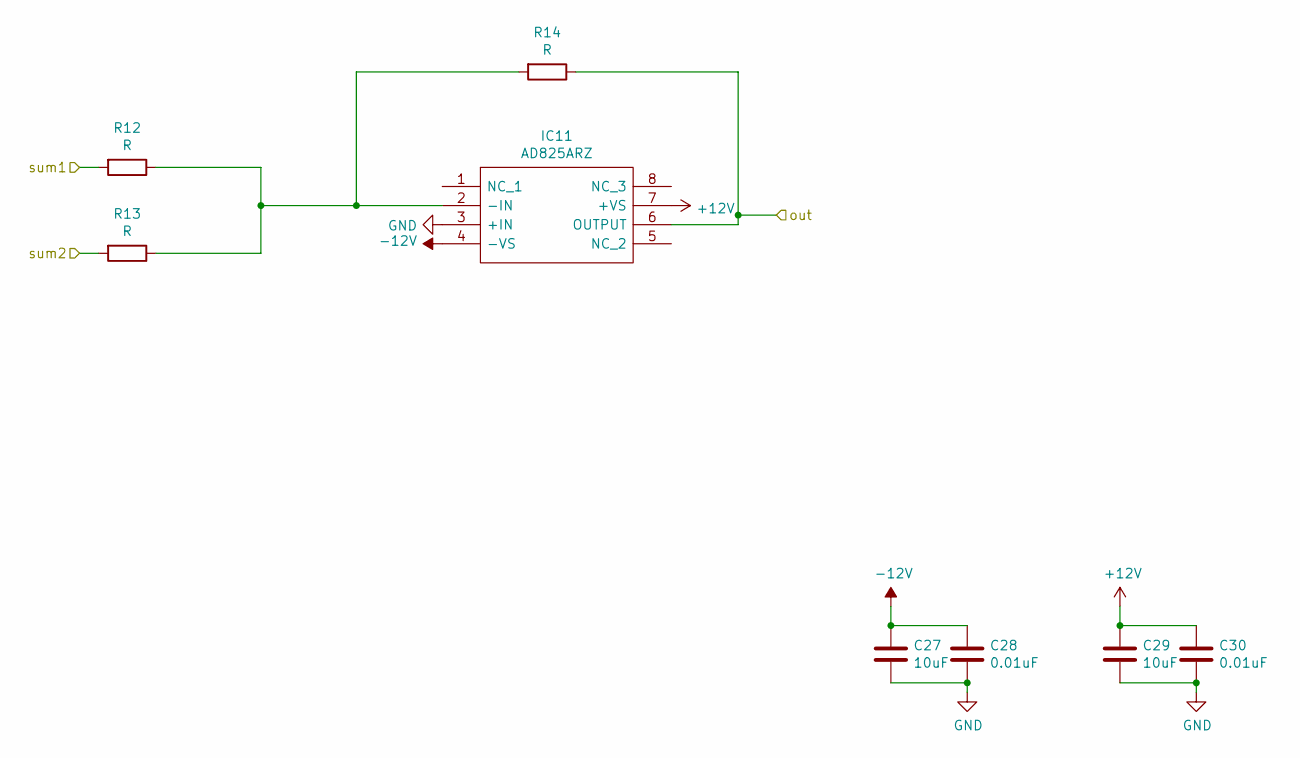
[picture p14: schematic SUM4.sch]

Parts:
C27, C29: 10uF; C_0603_1608Metric_Pad1.08x0.95mm_HandSolder
C28, C30: 0.01uF; C_0603_1608Metric_Pad1.08x0.95mm_HandSolder
IC11: AD825ARZ; SOIC127P600X175-8N; Manufacturer_Part_Number AD825ARZ; Mouser Part Number 584-AD825ARZ
R12, R13, R14: R; R_0603_1608Metric_Pad0.98x0.95mm_HandSolder

Connections:
+12V: C29.1, C30.1, IC11.7 (+VS); also elsewhere on the board
-12V: C27.1, C28.1, IC11.4 (-VS); also elsewhere on the board
/Sheet60A37CB5/AM4.2/out: R13.2; also elsewhere on the board
/Sheet60A37CB5/MUX4/S1: R12.2; also elsewhere on the board
/Sheet60A37CB5/SUM4/out: IC11.6 (OUTPUT), R14.1; also elsewhere on the board
GND: C27.2, C28.2, C29.2, C30.2, IC11.3 (+IN); also elsewhere on the board
unnamed: IC11.2 (-IN), R12.1, R13.1, R14.2

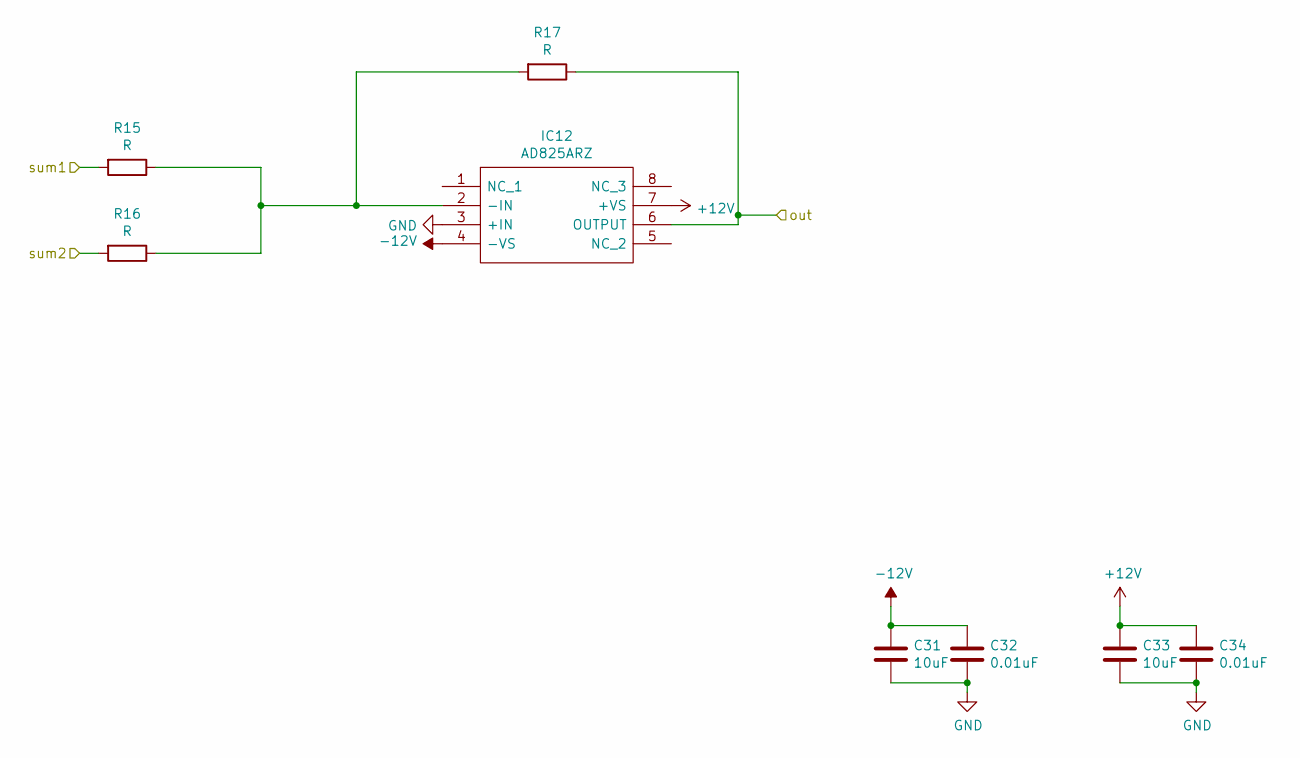
[picture p15: schematic SUM5.sch]

Parts:
C31, C33: 10uF; C_0603_1608Metric_Pad1.08x0.95mm_HandSolder
C32, C34: 0.01uF; C_0603_1608Metric_Pad1.08x0.95mm_HandSolder
IC12: AD825ARZ; SOIC127P600X175-8N; Manufacturer_Part_Number AD825ARZ; Mouser Part Number 584-AD825ARZ
R15, R16, R17: R; R_0603_1608Metric_Pad0.98x0.95mm_HandSolder

Connections:
+12V: C33.1, C34.1, IC12.7 (+VS); also elsewhere on the board
-12V: C31.1, C32.1, IC12.4 (-VS); also elsewhere on the board
/Sheet60A37CB5/AM5.2/out: R16.2; also elsewhere on the board
/Sheet60A37CB5/MUX5/S1: R15.2; also elsewhere on the board
/Sheet60A37CB5/SUM5/out: IC12.6 (OUTPUT), R17.1; also elsewhere on the board
GND: C31.2, C32.2, C33.2, C34.2, IC12.3 (+IN); also elsewhere on the board
unnamed: IC12.2 (-IN), R15.1, R16.1, R17.2

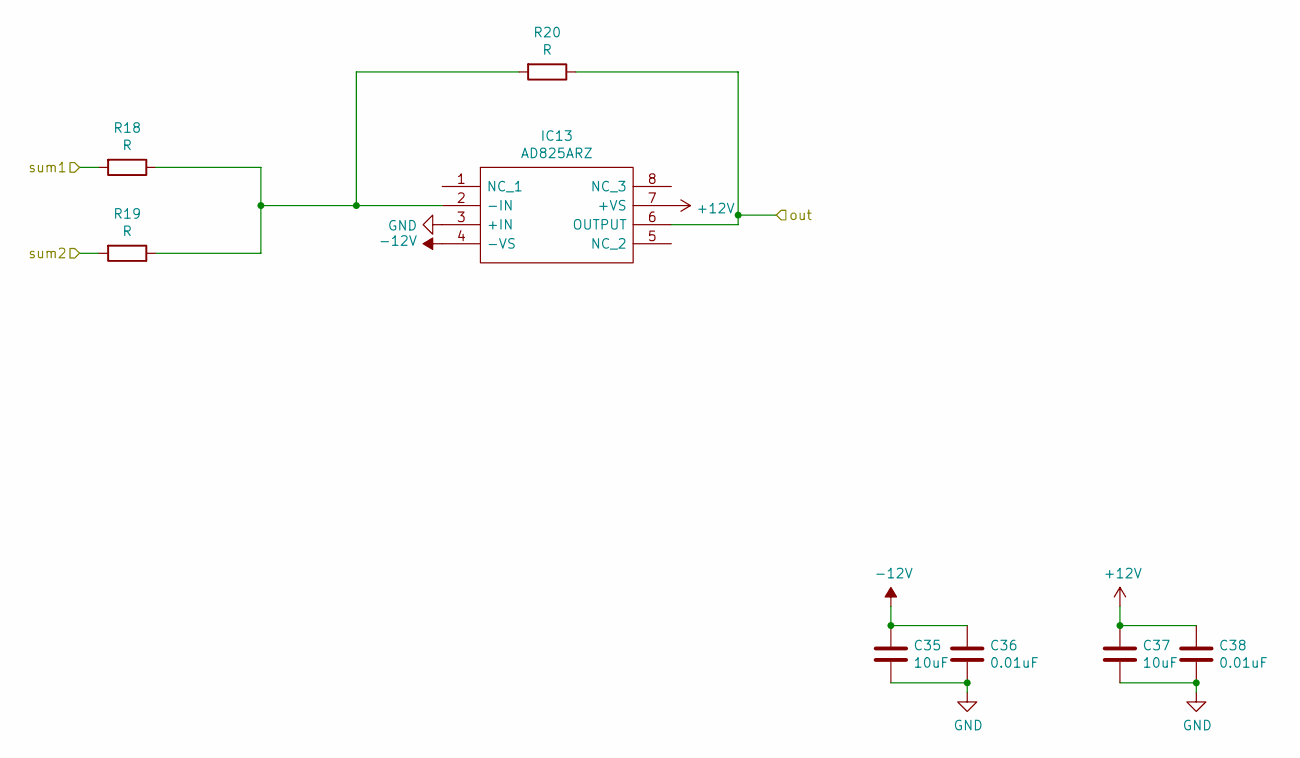
[picture p16: schematic SUM6.sch]

Parts:
C35, C37: 10uF; C_0603_1608Metric_Pad1.08x0.95mm_HandSolder
C36, C38: 0.01uF; C_0603_1608Metric_Pad1.08x0.95mm_HandSolder
IC13: AD825ARZ; SOIC127P600X175-8N; Manufacturer_Part_Number AD825ARZ; Mouser Part Number 584-AD825ARZ
R18, R19, R20: R; R_0603_1608Metric_Pad0.98x0.95mm_HandSolder

Connections:
+12V: C37.1, C38.1, IC13.7 (+VS); also elsewhere on the board
-12V: C35.1, C36.1, IC13.4 (-VS); also elsewhere on the board
/Sheet60A37CB5/AM6.2/out: R19.2; also elsewhere on the board
/Sheet60A37CB5/MUX6/S1: R18.2; also elsewhere on the board
/Sheet60A37CB5/SUM6/out: IC13.6 (OUTPUT), R20.1; also elsewhere on the board
GND: C35.2, C36.2, C37.2, C38.2, IC13.3 (+IN); also elsewhere on the board
unnamed: IC13.2 (-IN), R18.1, R19.1, R20.2

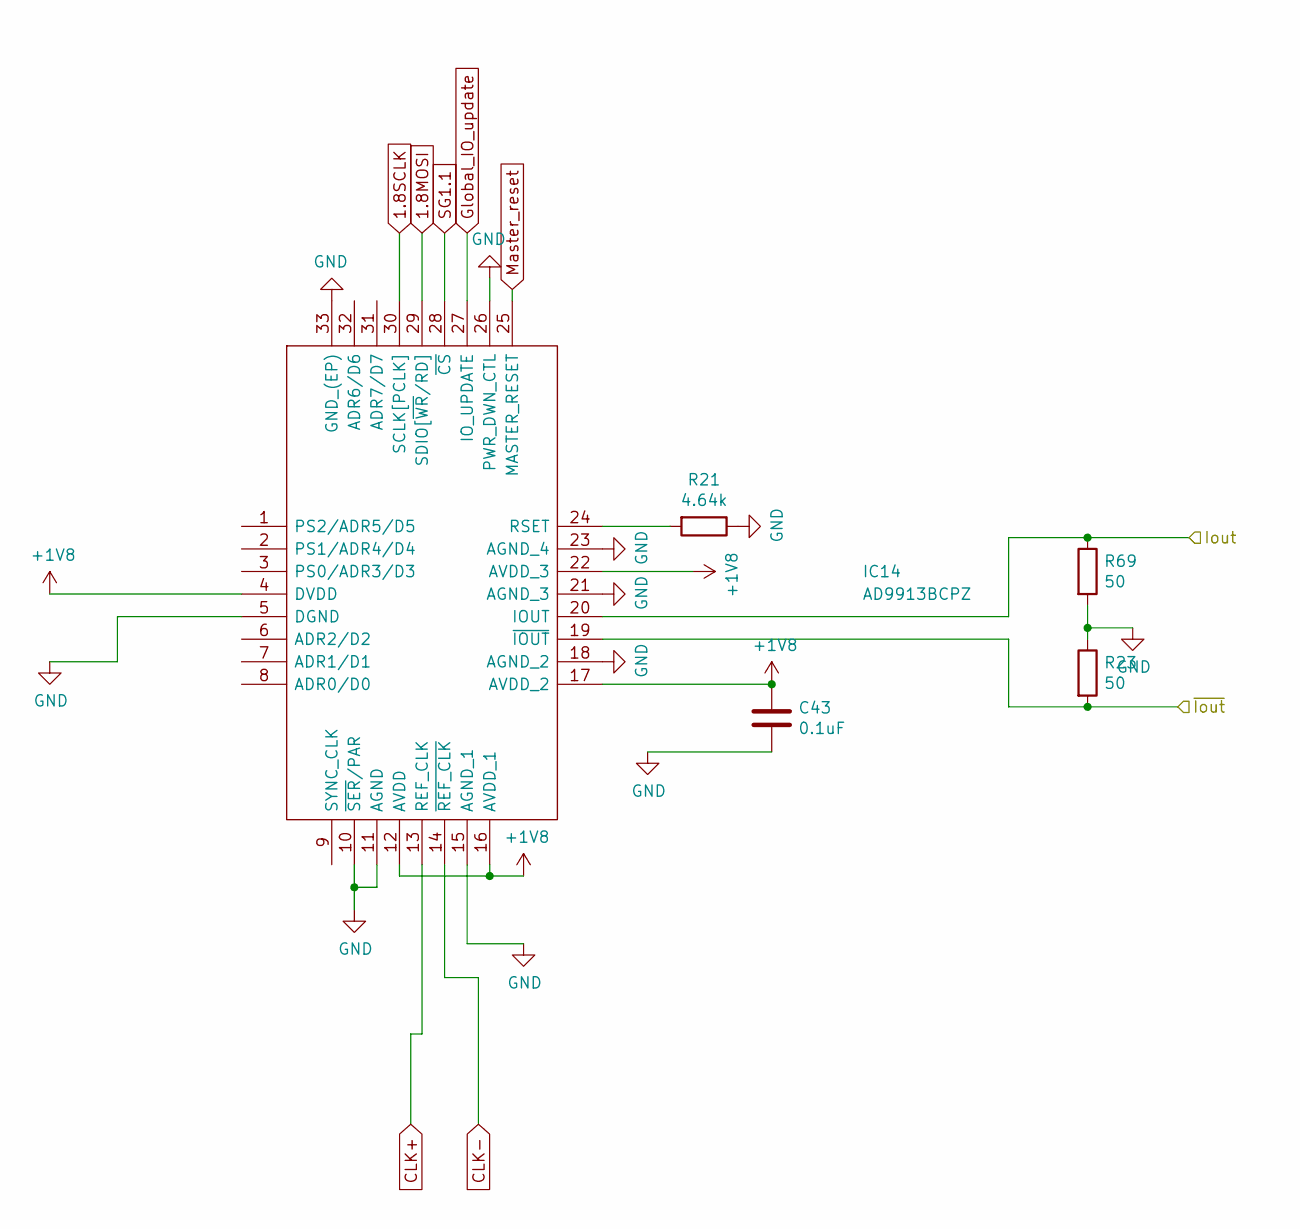
[picture p17: schematic SG1.1.sch]

Parts:
C43: 0.1uF; C_0603_1608Metric_Pad1.08x0.95mm_HandSolder
IC14: AD9913BCPZ; QFN50P500X500X100-33N; Manufacturer_Part_Number AD9913BCPZ; Mouser Part Number 584-AD9913BCPZ
R21: 4.64k; R_0603_1608Metric_Pad0.98x0.95mm_HandSolder
R23, R69: 50; R_0603_1608Metric_Pad0.98x0.95mm_HandSolder

Connections:
1.8MOSI: IC14.29 (SDIO[~WR~/RD]); also elsewhere on the board
1.8SCLK: IC14.30 (SCLK[PCLK]); also elsewhere on the board
+1V8: C43.1, IC14.4 (DVDD), IC14.12 (AVDD), IC14.16 (AVDD_1), IC14.17 (AVDD_2), IC14.22 (AVDD_3); also elsewhere on the board
/Sheet60A37CB5/SG1.1/Iout: IC14.20 (IOUT), R69.1; also elsewhere on the board
/Sheet60A37CB5/preamp1/in2: IC14.19 (~IOUT), R23.2; also elsewhere on the board
CLK+: IC14.13 (REF_CLK); also elsewhere on the board
CLK-: IC14.14 (~REF_CLK); also elsewhere on the board
GND: C43.2, IC14.5 (DGND), IC14.10 (~SER~/PAR), IC14.11 (AGND), IC14.15 (AGND_1), IC14.18 (AGND_2), IC14.21 (AGND_3), IC14.23 (AGND_4), IC14.26 (PWR_DWN_CTL), IC14.33 (GND_(EP)), R21.1, R23.1, R69.2; also elsewhere on the board
Global_IO_update: IC14.27 (IO_UPDATE); also elsewhere on the board
Master_reset: IC14.25 (MASTER_RESET); also elsewhere on the board
unnamed: IC14.24 (RSET), R21.2
SG1.1: IC14.28 (~CS); also elsewhere on the board

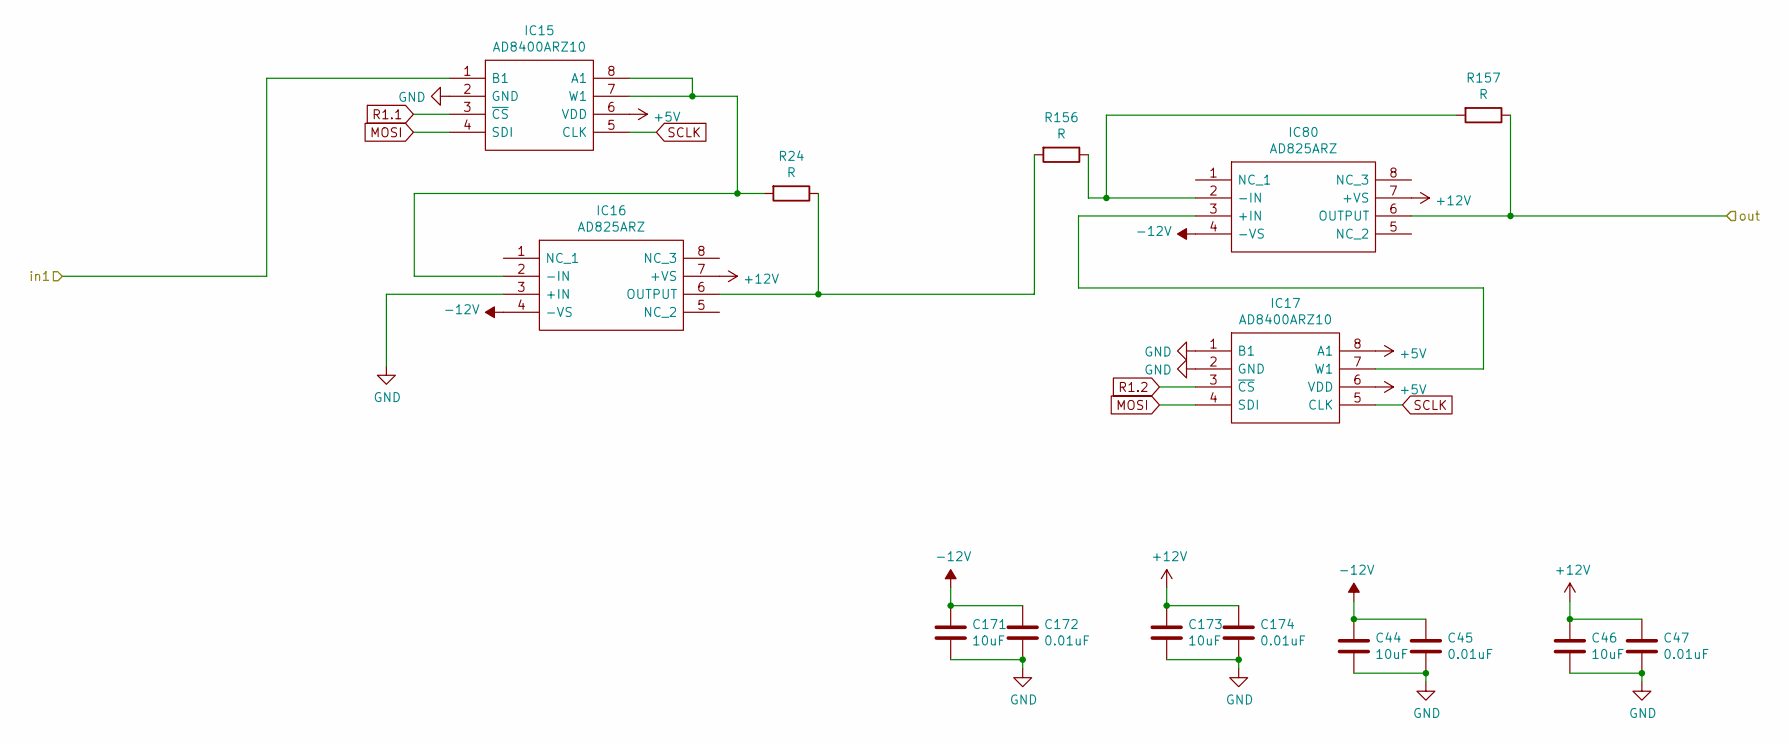
[picture p18: schematic AM1.1.sch]

Parts:
C44, C46, C171, C173: 10uF; C_0603_1608Metric_Pad1.08x0.95mm_HandSolder
C45, C47, C172, C174: 0.01uF; C_0603_1608Metric_Pad1.08x0.95mm_HandSolder
IC15, IC17: AD8400ARZ10; SOIC127P600X175-8N; Manufacturer_Part_Number AD8400ARZ10; Mouser Part Number 584-AD8400ARZ10
IC16, IC80: AD825ARZ; SOIC127P600X175-8N; Manufacturer_Part_Number AD825ARZ; Mouser Part Number 584-AD825ARZ
R24, R156, R157: R; R_0603_1608Metric_Pad0.98x0.95mm_HandSolder

Connections:
+5V: IC15.6 (VDD), IC17.6 (VDD), IC17.8 (A1); also elsewhere on the board
+12V: C46.1, C47.1, C173.1, C174.1, IC16.7 (+VS), IC80.7 (+VS); also elsewhere on the board
-12V: C44.1, C45.1, C171.1, C172.1, IC16.4 (-VS), IC80.4 (-VS); also elsewhere on the board
/Sheet60A37CB5/AM1.1/in1: IC15.1 (B1); also elsewhere on the board
/Sheet60A37CB5/MUX1/S1: IC80.6 (OUTPUT), R157.1; also elsewhere on the board
GND: C44.2, C45.2, C46.2, C47.2, C171.2, C172.2, C173.2, C174.2, IC15.2 (GND), IC16.3 (+IN), IC17.1 (B1), IC17.2 (GND); also elsewhere on the board
MOSI: IC15.4 (SDI), IC17.4 (SDI); also elsewhere on the board
unnamed: IC15.7 (W1), IC15.8 (A1), IC16.2 (-IN), R24.2
unnamed: IC16.6 (OUTPUT), R24.1, R156.2
unnamed: IC17.7 (W1), IC80.3 (+IN)
unnamed: IC80.2 (-IN), R156.1, R157.2
R1.1: IC15.3 (~CS); also elsewhere on the board
R1.2: IC17.3 (~CS); also elsewhere on the board
SCLK: IC15.5 (CLK), IC17.5 (CLK); also elsewhere on the board

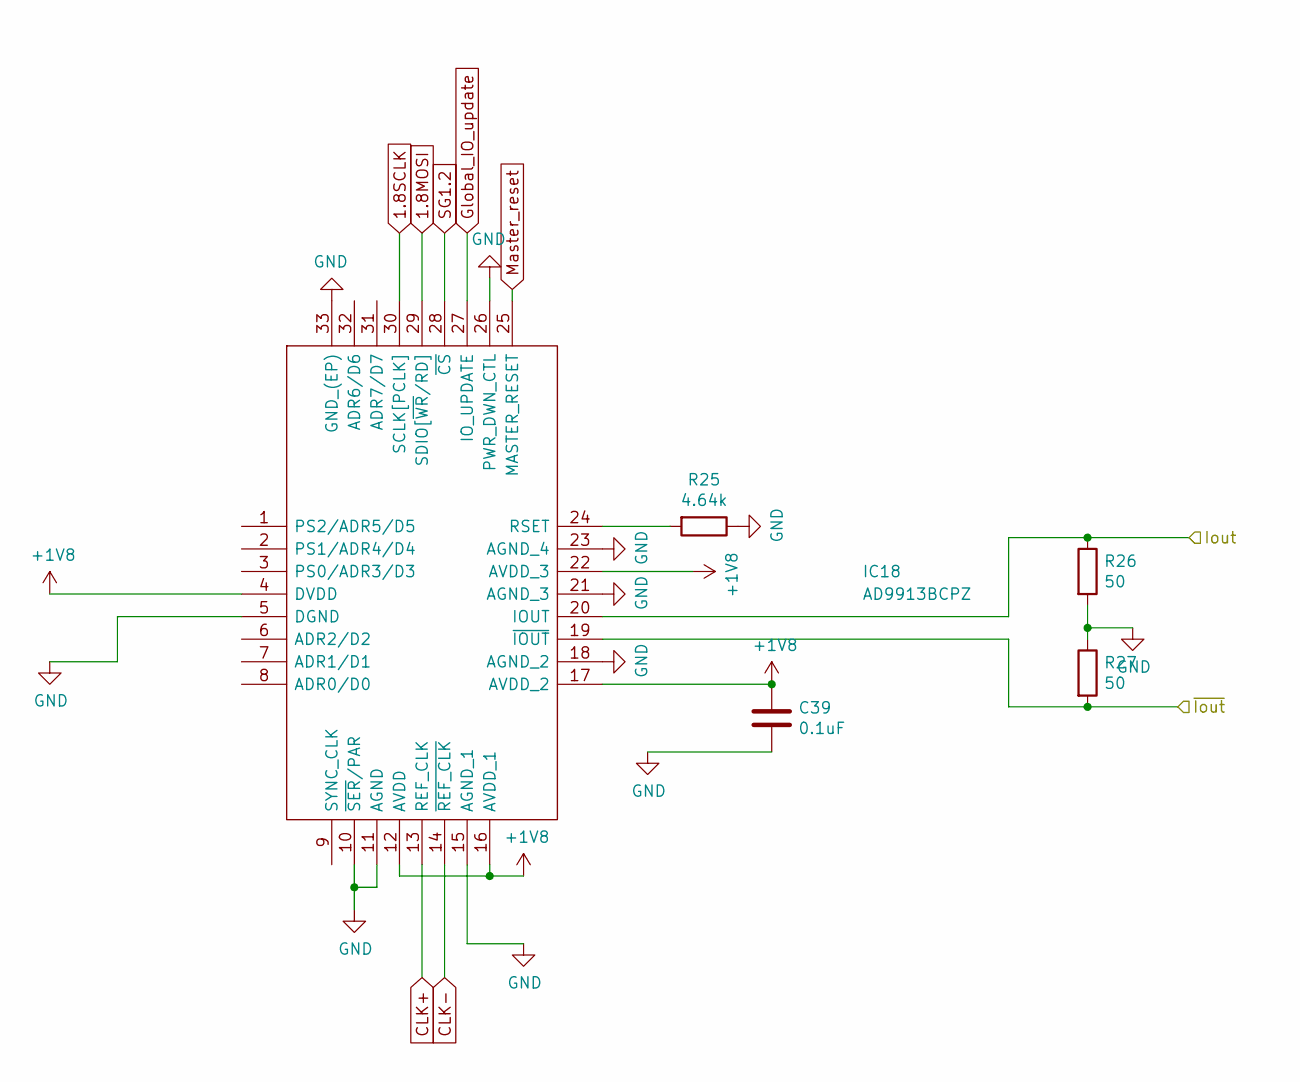
[picture p19: schematic SG1.2.sch]

Parts:
C39: 0.1uF; C_0603_1608Metric_Pad1.08x0.95mm_HandSolder
IC18: AD9913BCPZ; QFN50P500X500X100-33N; Manufacturer_Part_Number AD9913BCPZ; Mouser Part Number 584-AD9913BCPZ
R25: 4.64k; R_0603_1608Metric_Pad0.98x0.95mm_HandSolder
R26, R27: 50; R_0603_1608Metric_Pad0.98x0.95mm_HandSolder

Connections:
1.8MOSI: IC18.29 (SDIO[~WR~/RD]); also elsewhere on the board
1.8SCLK: IC18.30 (SCLK[PCLK]); also elsewhere on the board
+1V8: C39.1, IC18.4 (DVDD), IC18.12 (AVDD), IC18.16 (AVDD_1), IC18.17 (AVDD_2), IC18.22 (AVDD_3); also elsewhere on the board
/Sheet60A37CB5/SG1.2/Iout: IC18.20 (IOUT), R26.1; also elsewhere on the board
/Sheet60A37CB5/preamp2/in2: IC18.19 (~IOUT), R27.2; also elsewhere on the board
CLK+: IC18.13 (REF_CLK); also elsewhere on the board
CLK-: IC18.14 (~REF_CLK); also elsewhere on the board
GND: C39.2, IC18.5 (DGND), IC18.10 (~SER~/PAR), IC18.11 (AGND), IC18.15 (AGND_1), IC18.18 (AGND_2), IC18.21 (AGND_3), IC18.23 (AGND_4), IC18.26 (PWR_DWN_CTL), IC18.33 (GND_(EP)), R25.1, R26.2, R27.1; also elsewhere on the board
Global_IO_update: IC18.27 (IO_UPDATE); also elsewhere on the board
Master_reset: IC18.25 (MASTER_RESET); also elsewhere on the board
unnamed: IC18.24 (RSET), R25.2
SG1.2: IC18.28 (~CS); also elsewhere on the board

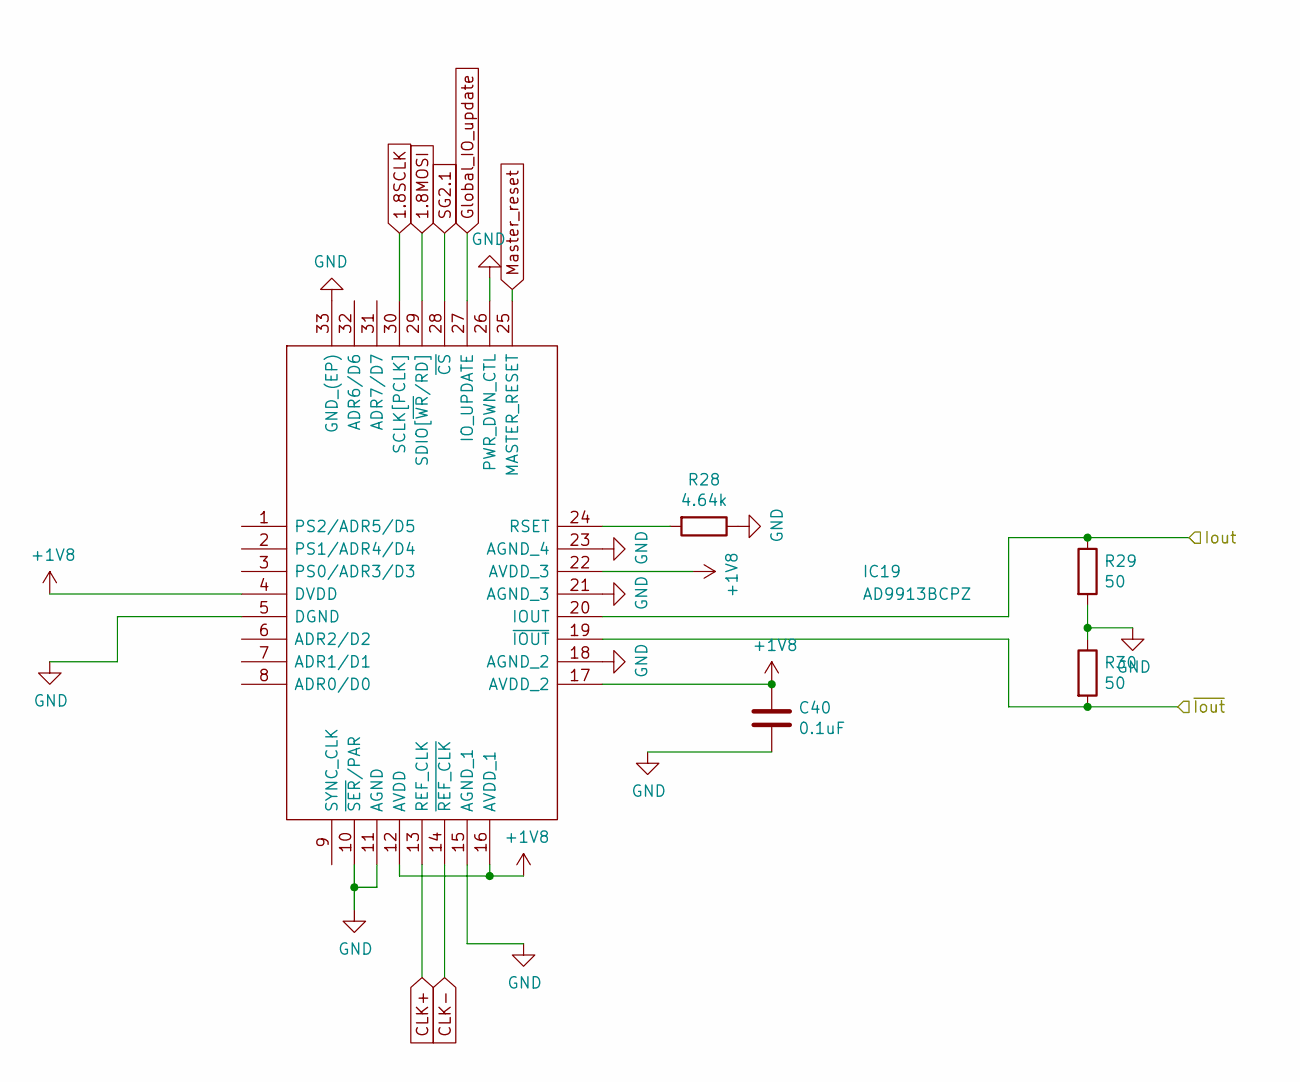
[picture p20: schematic SG2.1.sch]

Parts:
C40: 0.1uF; C_0603_1608Metric_Pad1.08x0.95mm_HandSolder
IC19: AD9913BCPZ; QFN50P500X500X100-33N; Manufacturer_Part_Number AD9913BCPZ; Mouser Part Number 584-AD9913BCPZ
R28: 4.64k; R_0603_1608Metric_Pad0.98x0.95mm_HandSolder
R29, R30: 50; R_0603_1608Metric_Pad0.98x0.95mm_HandSolder

Connections:
1.8MOSI: IC19.29 (SDIO[~WR~/RD]); also elsewhere on the board
1.8SCLK: IC19.30 (SCLK[PCLK]); also elsewhere on the board
+1V8: C40.1, IC19.4 (DVDD), IC19.12 (AVDD), IC19.16 (AVDD_1), IC19.17 (AVDD_2), IC19.22 (AVDD_3); also elsewhere on the board
/Sheet60A37CB5/SG2.1/Iout: IC19.20 (IOUT), R29.1; also elsewhere on the board
/Sheet60A37CB5/preamp3/in2: IC19.19 (~IOUT), R30.2; also elsewhere on the board
CLK+: IC19.13 (REF_CLK); also elsewhere on the board
CLK-: IC19.14 (~REF_CLK); also elsewhere on the board
GND: C40.2, IC19.5 (DGND), IC19.10 (~SER~/PAR), IC19.11 (AGND), IC19.15 (AGND_1), IC19.18 (AGND_2), IC19.21 (AGND_3), IC19.23 (AGND_4), IC19.26 (PWR_DWN_CTL), IC19.33 (GND_(EP)), R28.1, R29.2, R30.1; also elsewhere on the board
Global_IO_update: IC19.27 (IO_UPDATE); also elsewhere on the board
Master_reset: IC19.25 (MASTER_RESET); also elsewhere on the board
unnamed: IC19.24 (RSET), R28.2
SG2.1: IC19.28 (~CS); also elsewhere on the board

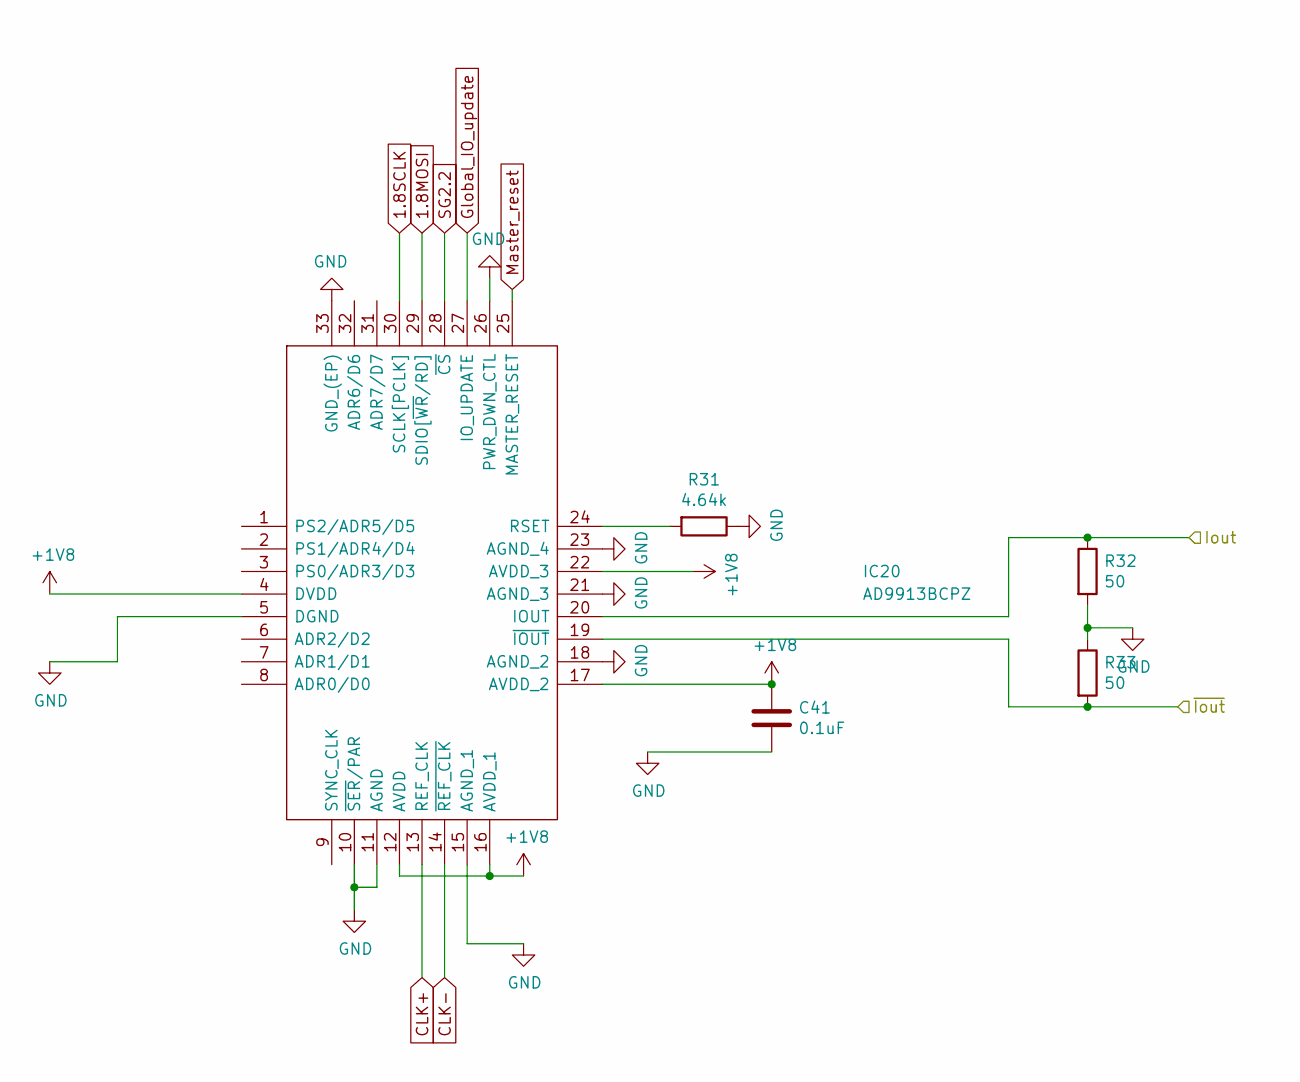
[picture p21: schematic SG2.2.sch]

Parts:
C41: 0.1uF; C_0603_1608Metric_Pad1.08x0.95mm_HandSolder
IC20: AD9913BCPZ; QFN50P500X500X100-33N; Manufacturer_Part_Number AD9913BCPZ; Mouser Part Number 584-AD9913BCPZ
R31: 4.64k; R_0603_1608Metric_Pad0.98x0.95mm_HandSolder
R32, R33: 50; R_0603_1608Metric_Pad0.98x0.95mm_HandSolder

Connections:
1.8MOSI: IC20.29 (SDIO[~WR~/RD]); also elsewhere on the board
1.8SCLK: IC20.30 (SCLK[PCLK]); also elsewhere on the board
+1V8: C41.1, IC20.4 (DVDD), IC20.12 (AVDD), IC20.16 (AVDD_1), IC20.17 (AVDD_2), IC20.22 (AVDD_3); also elsewhere on the board
/Sheet60A37CB5/SG2.2/Iout: IC20.20 (IOUT), R32.1; also elsewhere on the board
/Sheet60A37CB5/preamp4/in2: IC20.19 (~IOUT), R33.2; also elsewhere on the board
CLK+: IC20.13 (REF_CLK); also elsewhere on the board
CLK-: IC20.14 (~REF_CLK); also elsewhere on the board
GND: C41.2, IC20.5 (DGND), IC20.10 (~SER~/PAR), IC20.11 (AGND), IC20.15 (AGND_1), IC20.18 (AGND_2), IC20.21 (AGND_3), IC20.23 (AGND_4), IC20.26 (PWR_DWN_CTL), IC20.33 (GND_(EP)), R31.1, R32.2, R33.1; also elsewhere on the board
Global_IO_update: IC20.27 (IO_UPDATE); also elsewhere on the board
Master_reset: IC20.25 (MASTER_RESET); also elsewhere on the board
unnamed: IC20.24 (RSET), R31.2
SG2.2: IC20.28 (~CS); also elsewhere on the board

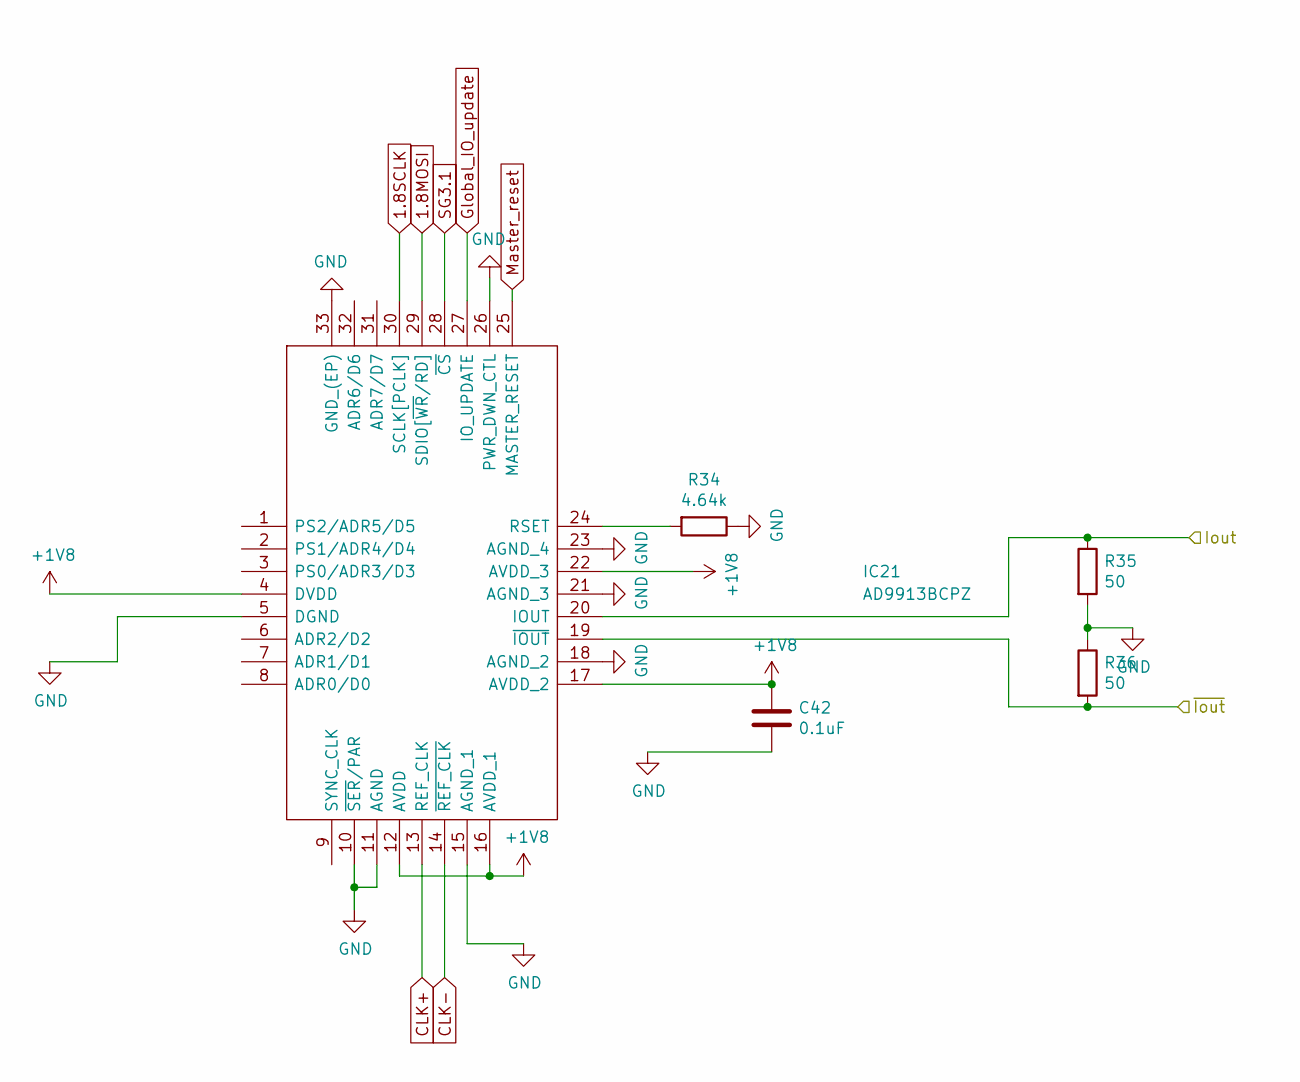
[picture p22: schematic SG3.1.sch]

Parts:
C42: 0.1uF; C_0603_1608Metric_Pad1.08x0.95mm_HandSolder
IC21: AD9913BCPZ; QFN50P500X500X100-33N; Manufacturer_Part_Number AD9913BCPZ; Mouser Part Number 584-AD9913BCPZ
R34: 4.64k; R_0603_1608Metric_Pad0.98x0.95mm_HandSolder
R35, R36: 50; R_0603_1608Metric_Pad0.98x0.95mm_HandSolder

Connections:
1.8MOSI: IC21.29 (SDIO[~WR~/RD]); also elsewhere on the board
1.8SCLK: IC21.30 (SCLK[PCLK]); also elsewhere on the board
+1V8: C42.1, IC21.4 (DVDD), IC21.12 (AVDD), IC21.16 (AVDD_1), IC21.17 (AVDD_2), IC21.22 (AVDD_3); also elsewhere on the board
/Sheet60A37CB5/SG3.1/Iout: IC21.20 (IOUT), R35.1; also elsewhere on the board
/Sheet60A37CB5/preamp5/in2: IC21.19 (~IOUT), R36.2; also elsewhere on the board
CLK+: IC21.13 (REF_CLK); also elsewhere on the board
CLK-: IC21.14 (~REF_CLK); also elsewhere on the board
GND: C42.2, IC21.5 (DGND), IC21.10 (~SER~/PAR), IC21.11 (AGND), IC21.15 (AGND_1), IC21.18 (AGND_2), IC21.21 (AGND_3), IC21.23 (AGND_4), IC21.26 (PWR_DWN_CTL), IC21.33 (GND_(EP)), R34.1, R35.2, R36.1; also elsewhere on the board
Global_IO_update: IC21.27 (IO_UPDATE); also elsewhere on the board
Master_reset: IC21.25 (MASTER_RESET); also elsewhere on the board
unnamed: IC21.24 (RSET), R34.2
SG3.1: IC21.28 (~CS); also elsewhere on the board

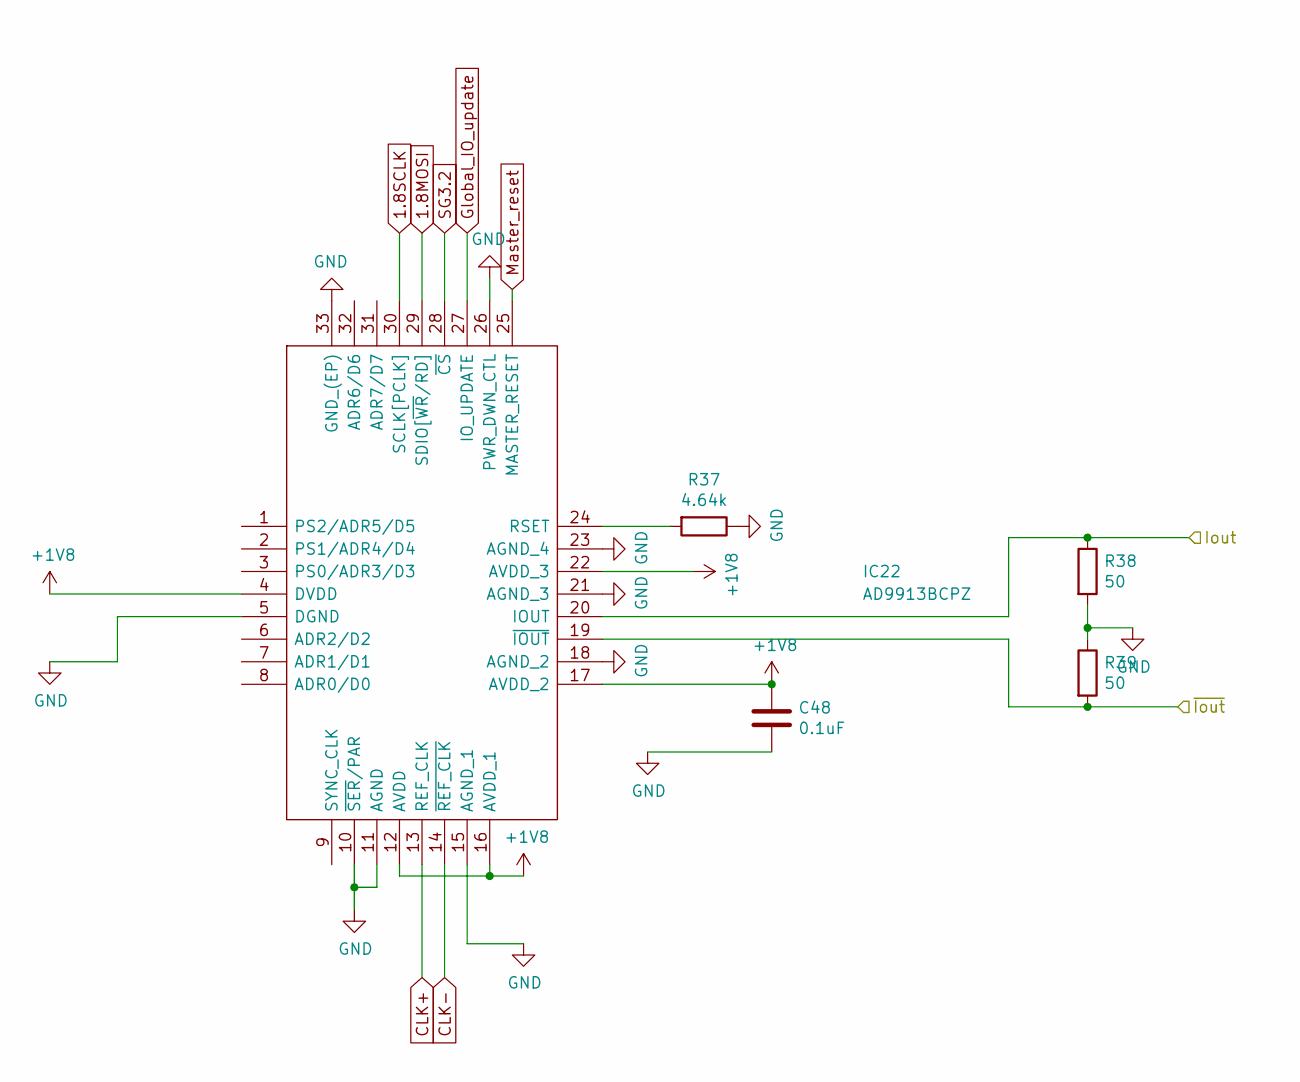
[picture p23: schematic SG3.2.sch]

Parts:
C48: 0.1uF; C_0603_1608Metric_Pad1.08x0.95mm_HandSolder
IC22: AD9913BCPZ; QFN50P500X500X100-33N; Manufacturer_Part_Number AD9913BCPZ; Mouser Part Number 584-AD9913BCPZ
R37: 4.64k; R_0603_1608Metric_Pad0.98x0.95mm_HandSolder
R38, R39: 50; R_0603_1608Metric_Pad0.98x0.95mm_HandSolder

Connections:
1.8MOSI: IC22.29 (SDIO[~WR~/RD]); also elsewhere on the board
1.8SCLK: IC22.30 (SCLK[PCLK]); also elsewhere on the board
+1V8: C48.1, IC22.4 (DVDD), IC22.12 (AVDD), IC22.16 (AVDD_1), IC22.17 (AVDD_2), IC22.22 (AVDD_3); also elsewhere on the board
/Sheet60A37CB5/SG3.2/Iout: IC22.20 (IOUT), R38.1; also elsewhere on the board
/Sheet60A37CB5/preamp6/in2: IC22.19 (~IOUT), R39.2; also elsewhere on the board
CLK+: IC22.13 (REF_CLK); also elsewhere on the board
CLK-: IC22.14 (~REF_CLK); also elsewhere on the board
GND: C48.2, IC22.5 (DGND), IC22.10 (~SER~/PAR), IC22.11 (AGND), IC22.15 (AGND_1), IC22.18 (AGND_2), IC22.21 (AGND_3), IC22.23 (AGND_4), IC22.26 (PWR_DWN_CTL), IC22.33 (GND_(EP)), R37.1, R38.2, R39.1; also elsewhere on the board
Global_IO_update: IC22.27 (IO_UPDATE); also elsewhere on the board
Master_reset: IC22.25 (MASTER_RESET); also elsewhere on the board
unnamed: IC22.24 (RSET), R37.2
SG3.2: IC22.28 (~CS); also elsewhere on the board

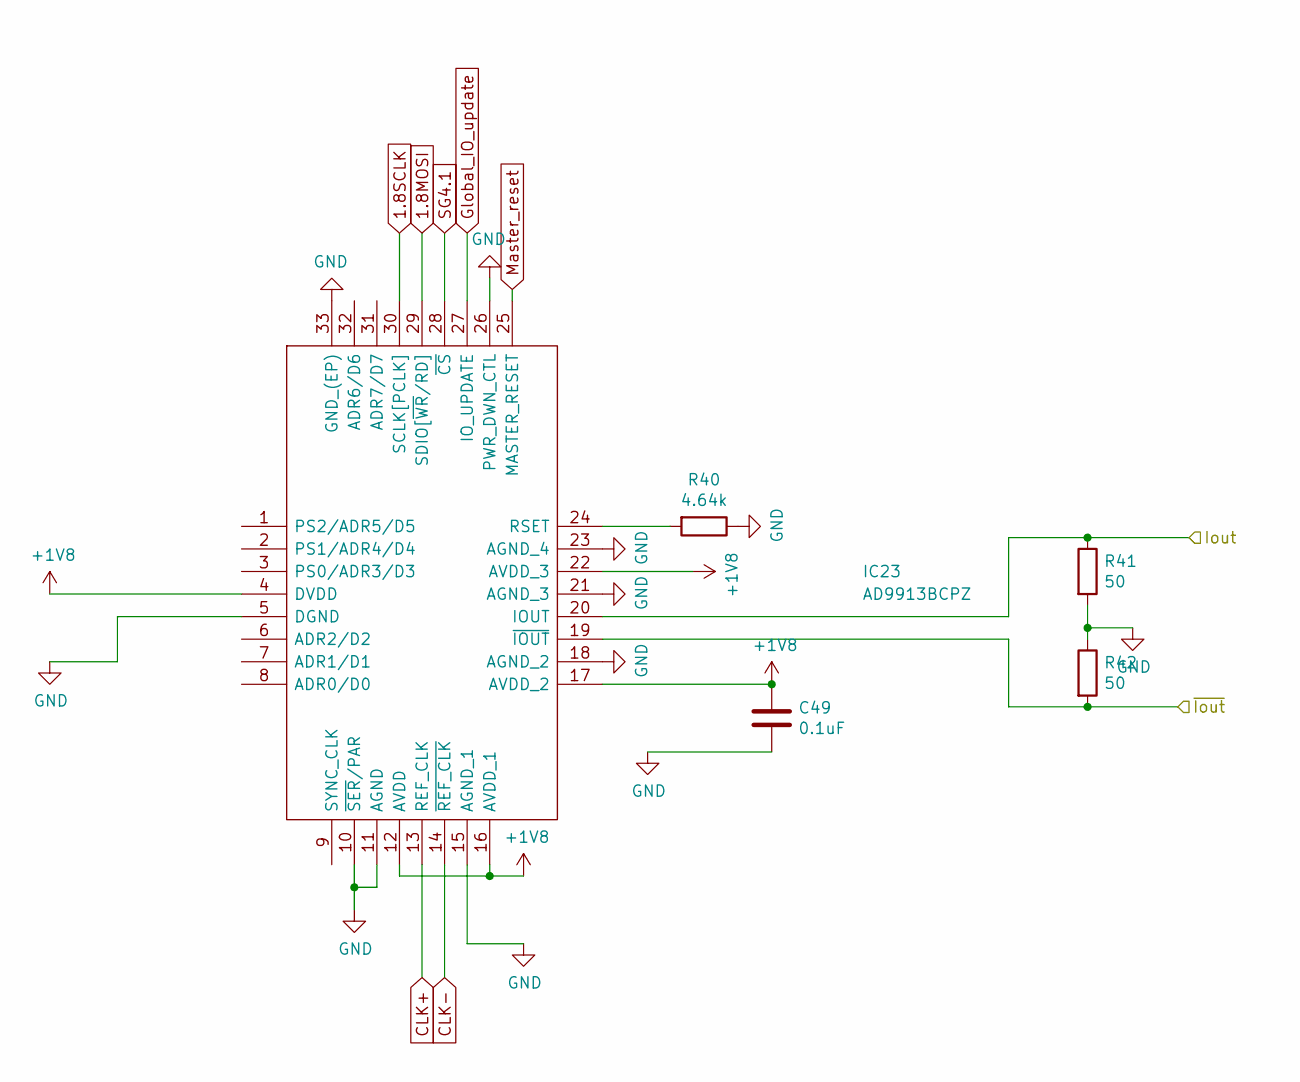
[picture p24: schematic SG4.1.sch]

Parts:
C49: 0.1uF; C_0603_1608Metric_Pad1.08x0.95mm_HandSolder
IC23: AD9913BCPZ; QFN50P500X500X100-33N; Manufacturer_Part_Number AD9913BCPZ; Mouser Part Number 584-AD9913BCPZ
R40: 4.64k; R_0603_1608Metric_Pad0.98x0.95mm_HandSolder
R41, R42: 50; R_0603_1608Metric_Pad0.98x0.95mm_HandSolder

Connections:
1.8MOSI: IC23.29 (SDIO[~WR~/RD]); also elsewhere on the board
1.8SCLK: IC23.30 (SCLK[PCLK]); also elsewhere on the board
+1V8: C49.1, IC23.4 (DVDD), IC23.12 (AVDD), IC23.16 (AVDD_1), IC23.17 (AVDD_2), IC23.22 (AVDD_3); also elsewhere on the board
/Sheet60A37CB5/SG4.1/Iout: IC23.20 (IOUT), R41.1; also elsewhere on the board
/Sheet60A37CB5/preamp7/in2: IC23.19 (~IOUT), R42.2; also elsewhere on the board
CLK+: IC23.13 (REF_CLK); also elsewhere on the board
CLK-: IC23.14 (~REF_CLK); also elsewhere on the board
GND: C49.2, IC23.5 (DGND), IC23.10 (~SER~/PAR), IC23.11 (AGND), IC23.15 (AGND_1), IC23.18 (AGND_2), IC23.21 (AGND_3), IC23.23 (AGND_4), IC23.26 (PWR_DWN_CTL), IC23.33 (GND_(EP)), R40.1, R41.2, R42.1; also elsewhere on the board
Global_IO_update: IC23.27 (IO_UPDATE); also elsewhere on the board
Master_reset: IC23.25 (MASTER_RESET); also elsewhere on the board
unnamed: IC23.24 (RSET), R40.2
SG4.1: IC23.28 (~CS); also elsewhere on the board
