on6315/ADEPT_DEP_Module/ADEPT_PCB_Hardware_Files/circuit_DEP.kicad_pcb

## KiCad design ADEPT_PCB_Hardware_Files/circuit_DEP.kicad_pcb (continued)

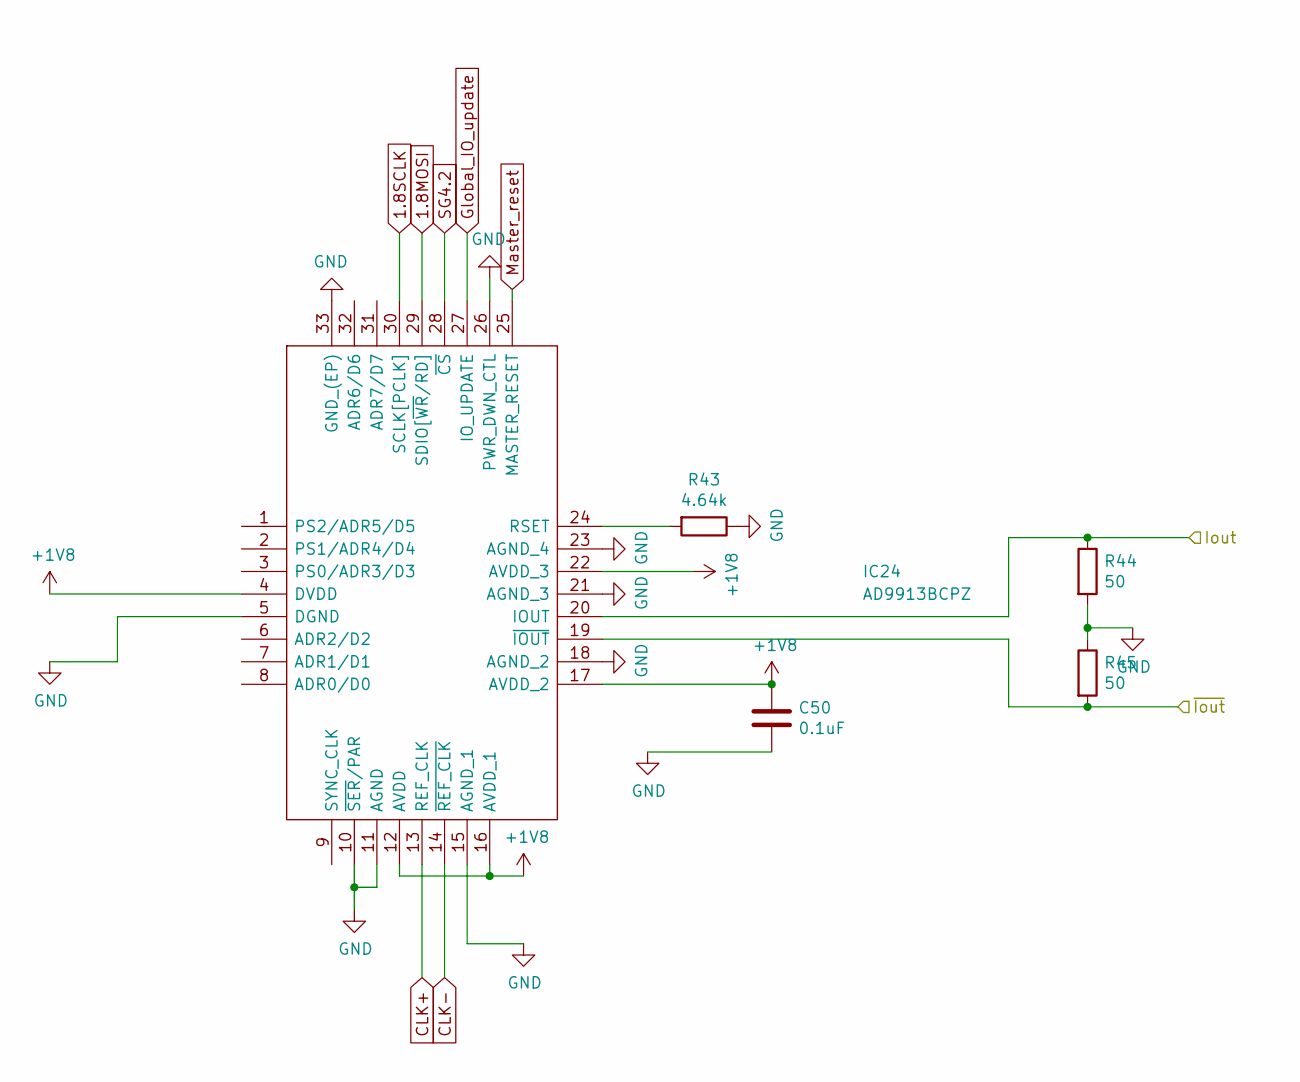
[picture p25: schematic SG4.2.sch]

Parts:
C50: 0.1uF; C_0603_1608Metric_Pad1.08x0.95mm_HandSolder
IC24: AD9913BCPZ; QFN50P500X500X100-33N; Manufacturer_Part_Number AD9913BCPZ; Mouser Part Number 584-AD9913BCPZ
R43: 4.64k; R_0603_1608Metric_Pad0.98x0.95mm_HandSolder
R44, R45: 50; R_0603_1608Metric_Pad0.98x0.95mm_HandSolder

Connections:
1.8MOSI: IC24.29 (SDIO[~WR~/RD]); also elsewhere on the board
1.8SCLK: IC24.30 (SCLK[PCLK]); also elsewhere on the board
+1V8: C50.1, IC24.4 (DVDD), IC24.12 (AVDD), IC24.16 (AVDD_1), IC24.17 (AVDD_2), IC24.22 (AVDD_3); also elsewhere on the board
/Sheet60A37CB5/SG4.2/Iout: IC24.20 (IOUT), R44.1; also elsewhere on the board
/Sheet60A37CB5/preamp8/in2: IC24.19 (~IOUT), R45.2; also elsewhere on the board
CLK+: IC24.13 (REF_CLK); also elsewhere on the board
CLK-: IC24.14 (~REF_CLK); also elsewhere on the board
GND: C50.2, IC24.5 (DGND), IC24.10 (~SER~/PAR), IC24.11 (AGND), IC24.15 (AGND_1), IC24.18 (AGND_2), IC24.21 (AGND_3), IC24.23 (AGND_4), IC24.26 (PWR_DWN_CTL), IC24.33 (GND_(EP)), R43.1, R44.2, R45.1; also elsewhere on the board
Global_IO_update: IC24.27 (IO_UPDATE); also elsewhere on the board
Master_reset: IC24.25 (MASTER_RESET); also elsewhere on the board
unnamed: IC24.24 (RSET), R43.2
SG4.2: IC24.28 (~CS); also elsewhere on the board

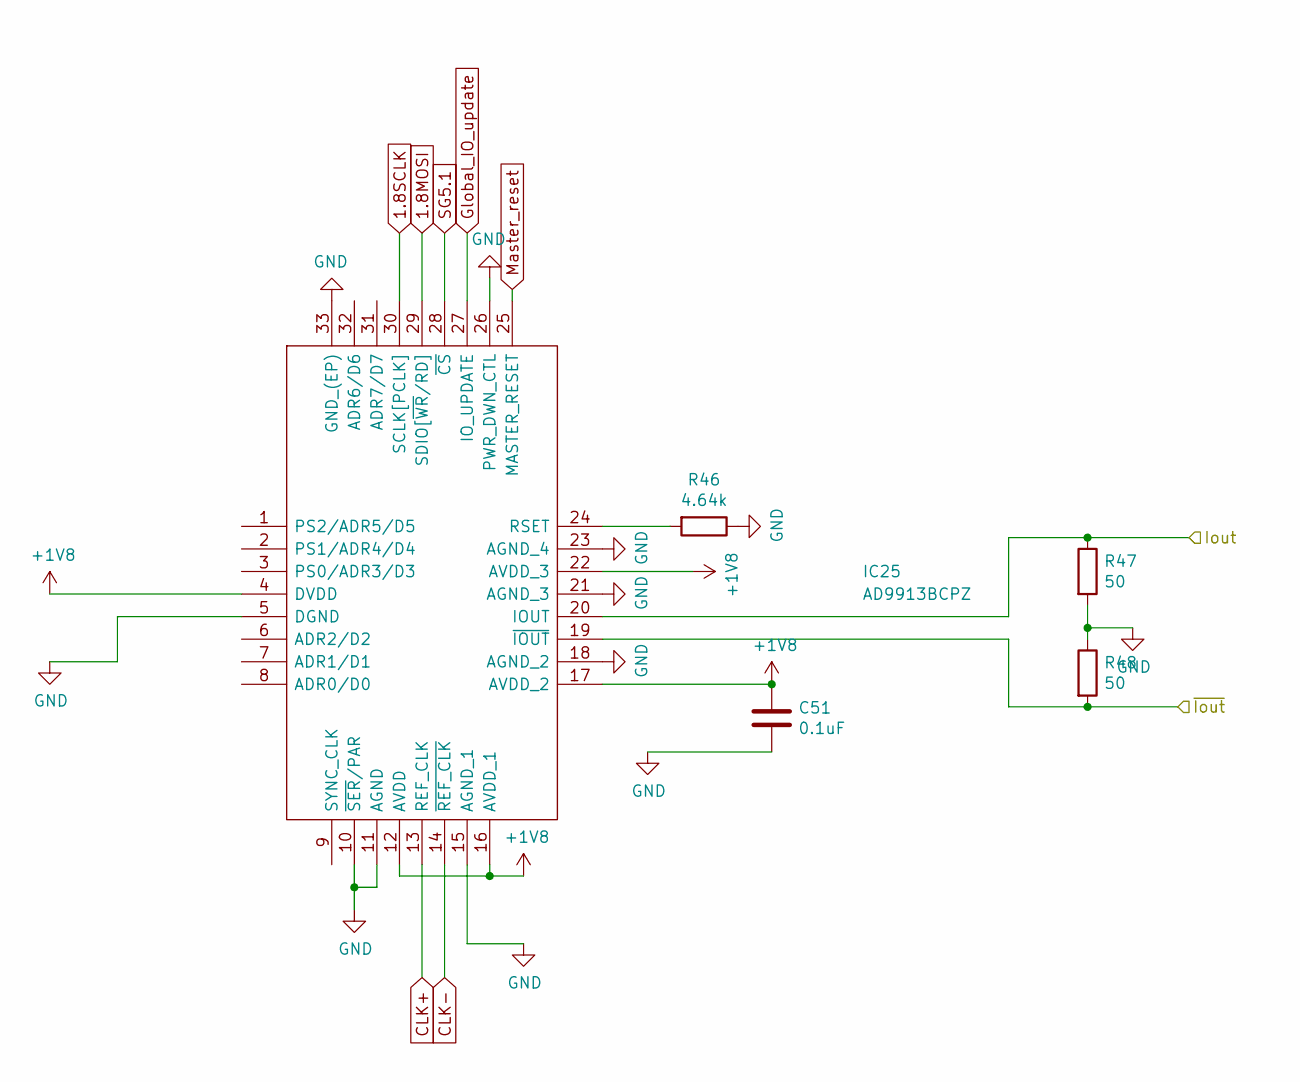
[picture p26: schematic SG5.1.sch]

Parts:
C51: 0.1uF; C_0603_1608Metric_Pad1.08x0.95mm_HandSolder
IC25: AD9913BCPZ; QFN50P500X500X100-33N; Manufacturer_Part_Number AD9913BCPZ; Mouser Part Number 584-AD9913BCPZ
R46: 4.64k; R_0603_1608Metric_Pad0.98x0.95mm_HandSolder
R47, R48: 50; R_0603_1608Metric_Pad0.98x0.95mm_HandSolder

Connections:
1.8MOSI: IC25.29 (SDIO[~WR~/RD]); also elsewhere on the board
1.8SCLK: IC25.30 (SCLK[PCLK]); also elsewhere on the board
+1V8: C51.1, IC25.4 (DVDD), IC25.12 (AVDD), IC25.16 (AVDD_1), IC25.17 (AVDD_2), IC25.22 (AVDD_3); also elsewhere on the board
/Sheet60A37CB5/SG5.1/Iout: IC25.20 (IOUT), R47.1; also elsewhere on the board
/Sheet60A37CB5/preamp9/in2: IC25.19 (~IOUT), R48.2; also elsewhere on the board
CLK+: IC25.13 (REF_CLK); also elsewhere on the board
CLK-: IC25.14 (~REF_CLK); also elsewhere on the board
GND: C51.2, IC25.5 (DGND), IC25.10 (~SER~/PAR), IC25.11 (AGND), IC25.15 (AGND_1), IC25.18 (AGND_2), IC25.21 (AGND_3), IC25.23 (AGND_4), IC25.26 (PWR_DWN_CTL), IC25.33 (GND_(EP)), R46.1, R47.2, R48.1; also elsewhere on the board
Global_IO_update: IC25.27 (IO_UPDATE); also elsewhere on the board
Master_reset: IC25.25 (MASTER_RESET); also elsewhere on the board
unnamed: IC25.24 (RSET), R46.2
SG5.1: IC25.28 (~CS); also elsewhere on the board

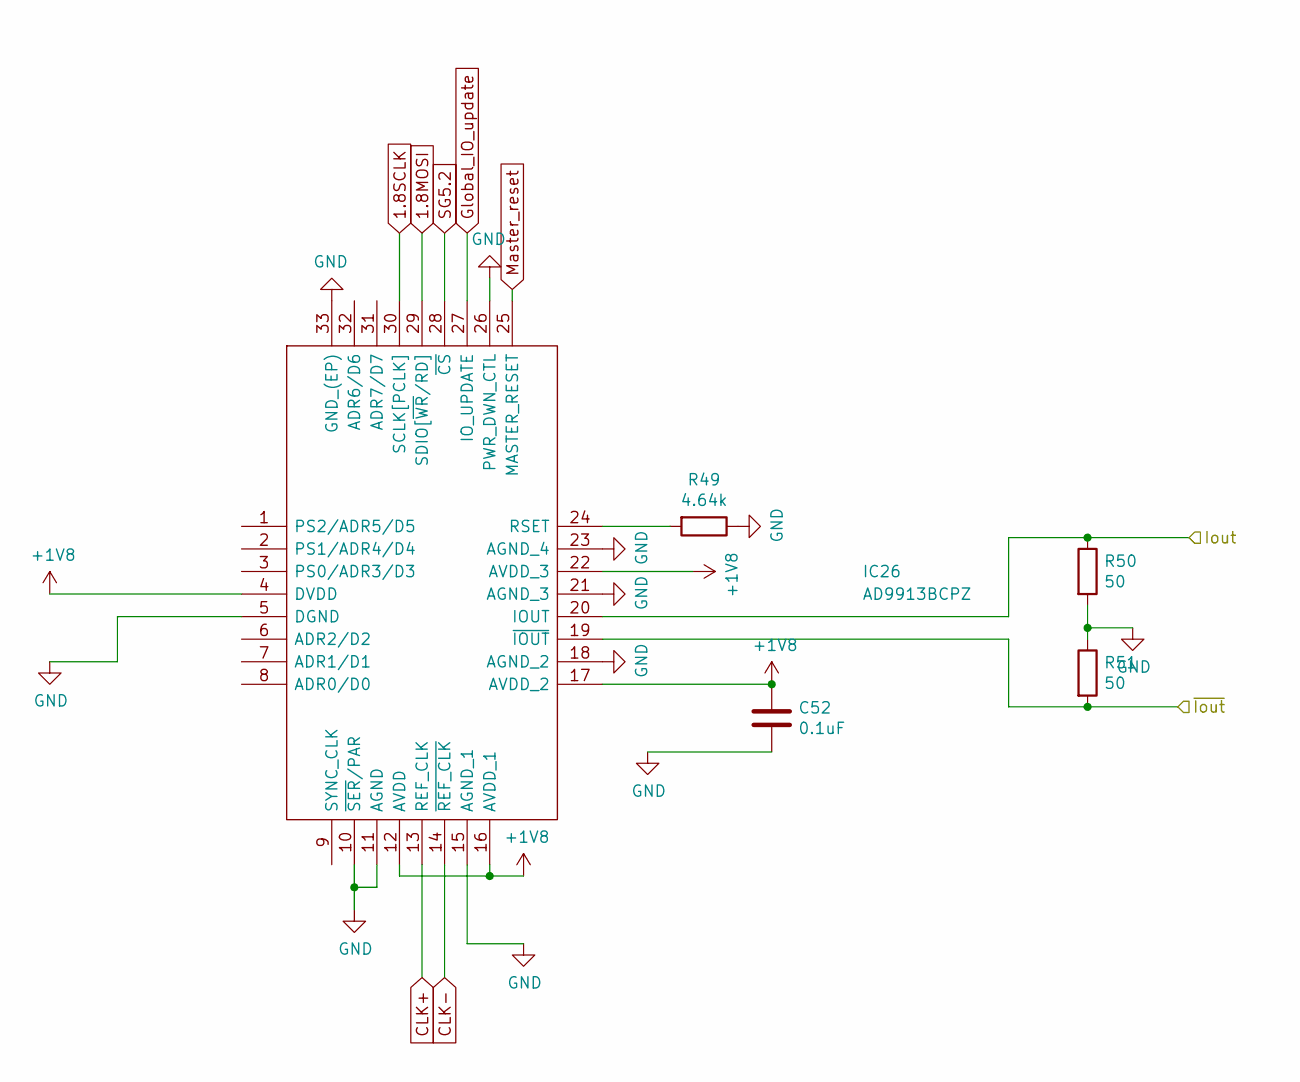
[picture p27: schematic SG5.2.sch]

Parts:
C52: 0.1uF; C_0603_1608Metric_Pad1.08x0.95mm_HandSolder
IC26: AD9913BCPZ; QFN50P500X500X100-33N; Manufacturer_Part_Number AD9913BCPZ; Mouser Part Number 584-AD9913BCPZ
R49: 4.64k; R_0603_1608Metric_Pad0.98x0.95mm_HandSolder
R50, R51: 50; R_0603_1608Metric_Pad0.98x0.95mm_HandSolder

Connections:
1.8MOSI: IC26.29 (SDIO[~WR~/RD]); also elsewhere on the board
1.8SCLK: IC26.30 (SCLK[PCLK]); also elsewhere on the board
+1V8: C52.1, IC26.4 (DVDD), IC26.12 (AVDD), IC26.16 (AVDD_1), IC26.17 (AVDD_2), IC26.22 (AVDD_3); also elsewhere on the board
/Sheet60A37CB5/SG5.2/Iout: IC26.20 (IOUT), R50.1; also elsewhere on the board
/Sheet60A37CB5/preamp10/in2: IC26.19 (~IOUT), R51.2; also elsewhere on the board
CLK+: IC26.13 (REF_CLK); also elsewhere on the board
CLK-: IC26.14 (~REF_CLK); also elsewhere on the board
GND: C52.2, IC26.5 (DGND), IC26.10 (~SER~/PAR), IC26.11 (AGND), IC26.15 (AGND_1), IC26.18 (AGND_2), IC26.21 (AGND_3), IC26.23 (AGND_4), IC26.26 (PWR_DWN_CTL), IC26.33 (GND_(EP)), R49.1, R50.2, R51.1; also elsewhere on the board
Global_IO_update: IC26.27 (IO_UPDATE); also elsewhere on the board
Master_reset: IC26.25 (MASTER_RESET); also elsewhere on the board
unnamed: IC26.24 (RSET), R49.2
SG5.2: IC26.28 (~CS); also elsewhere on the board

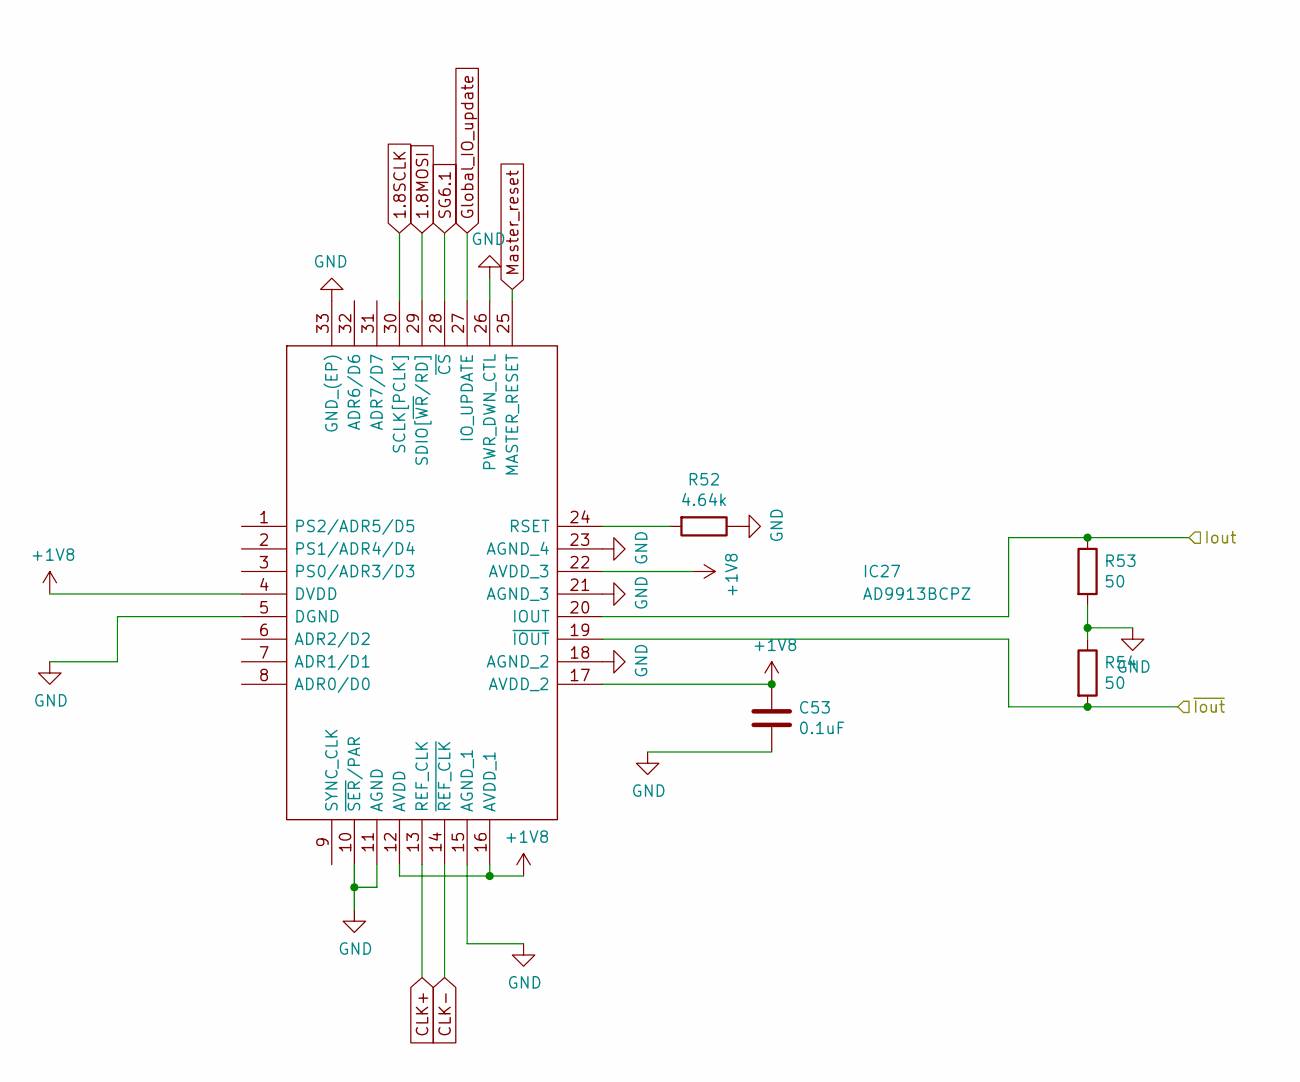
[picture p28: schematic SG6.1.sch]

Parts:
C53: 0.1uF; C_0603_1608Metric_Pad1.08x0.95mm_HandSolder
IC27: AD9913BCPZ; QFN50P500X500X100-33N; Manufacturer_Part_Number AD9913BCPZ; Mouser Part Number 584-AD9913BCPZ
R52: 4.64k; R_0603_1608Metric_Pad0.98x0.95mm_HandSolder
R53, R54: 50; R_0603_1608Metric_Pad0.98x0.95mm_HandSolder

Connections:
1.8MOSI: IC27.29 (SDIO[~WR~/RD]); also elsewhere on the board
1.8SCLK: IC27.30 (SCLK[PCLK]); also elsewhere on the board
+1V8: C53.1, IC27.4 (DVDD), IC27.12 (AVDD), IC27.16 (AVDD_1), IC27.17 (AVDD_2), IC27.22 (AVDD_3); also elsewhere on the board
/Sheet60A37CB5/SG6.1/Iout: IC27.20 (IOUT), R53.1; also elsewhere on the board
/Sheet60A37CB5/preamp11/in2: IC27.19 (~IOUT), R54.2; also elsewhere on the board
CLK+: IC27.13 (REF_CLK); also elsewhere on the board
CLK-: IC27.14 (~REF_CLK); also elsewhere on the board
GND: C53.2, IC27.5 (DGND), IC27.10 (~SER~/PAR), IC27.11 (AGND), IC27.15 (AGND_1), IC27.18 (AGND_2), IC27.21 (AGND_3), IC27.23 (AGND_4), IC27.26 (PWR_DWN_CTL), IC27.33 (GND_(EP)), R52.1, R53.2, R54.1; also elsewhere on the board
Global_IO_update: IC27.27 (IO_UPDATE); also elsewhere on the board
Master_reset: IC27.25 (MASTER_RESET); also elsewhere on the board
unnamed: IC27.24 (RSET), R52.2
SG6.1: IC27.28 (~CS); also elsewhere on the board

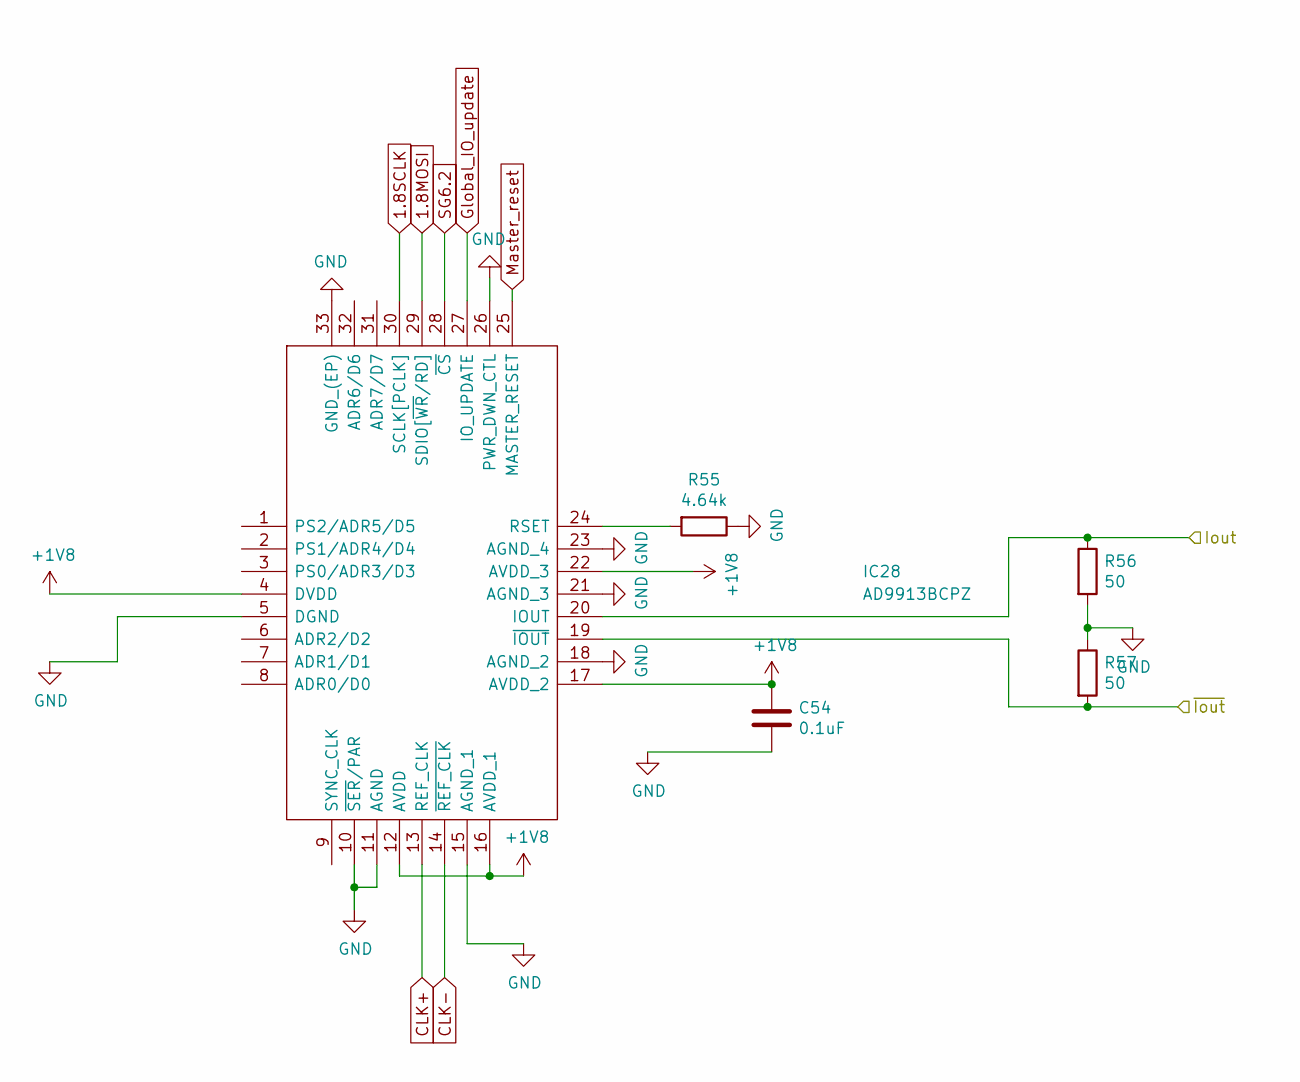
[picture p29: schematic SG6.2.sch]

Parts:
C54: 0.1uF; C_0603_1608Metric_Pad1.08x0.95mm_HandSolder
IC28: AD9913BCPZ; QFN50P500X500X100-33N; Manufacturer_Part_Number AD9913BCPZ; Mouser Part Number 584-AD9913BCPZ
R55: 4.64k; R_0603_1608Metric_Pad0.98x0.95mm_HandSolder
R56, R57: 50; R_0603_1608Metric_Pad0.98x0.95mm_HandSolder

Connections:
1.8MOSI: IC28.29 (SDIO[~WR~/RD]); also elsewhere on the board
1.8SCLK: IC28.30 (SCLK[PCLK]); also elsewhere on the board
+1V8: C54.1, IC28.4 (DVDD), IC28.12 (AVDD), IC28.16 (AVDD_1), IC28.17 (AVDD_2), IC28.22 (AVDD_3); also elsewhere on the board
/Sheet60A37CB5/SG6.2/Iout: IC28.20 (IOUT), R56.1; also elsewhere on the board
/Sheet60A37CB5/preamp12/in2: IC28.19 (~IOUT), R57.2; also elsewhere on the board
CLK+: IC28.13 (REF_CLK); also elsewhere on the board
CLK-: IC28.14 (~REF_CLK); also elsewhere on the board
GND: C54.2, IC28.5 (DGND), IC28.10 (~SER~/PAR), IC28.11 (AGND), IC28.15 (AGND_1), IC28.18 (AGND_2), IC28.21 (AGND_3), IC28.23 (AGND_4), IC28.26 (PWR_DWN_CTL), IC28.33 (GND_(EP)), R55.1, R56.2, R57.1; also elsewhere on the board
Global_IO_update: IC28.27 (IO_UPDATE); also elsewhere on the board
Master_reset: IC28.25 (MASTER_RESET); also elsewhere on the board
unnamed: IC28.24 (RSET), R55.2
SG6.2: IC28.28 (~CS); also elsewhere on the board

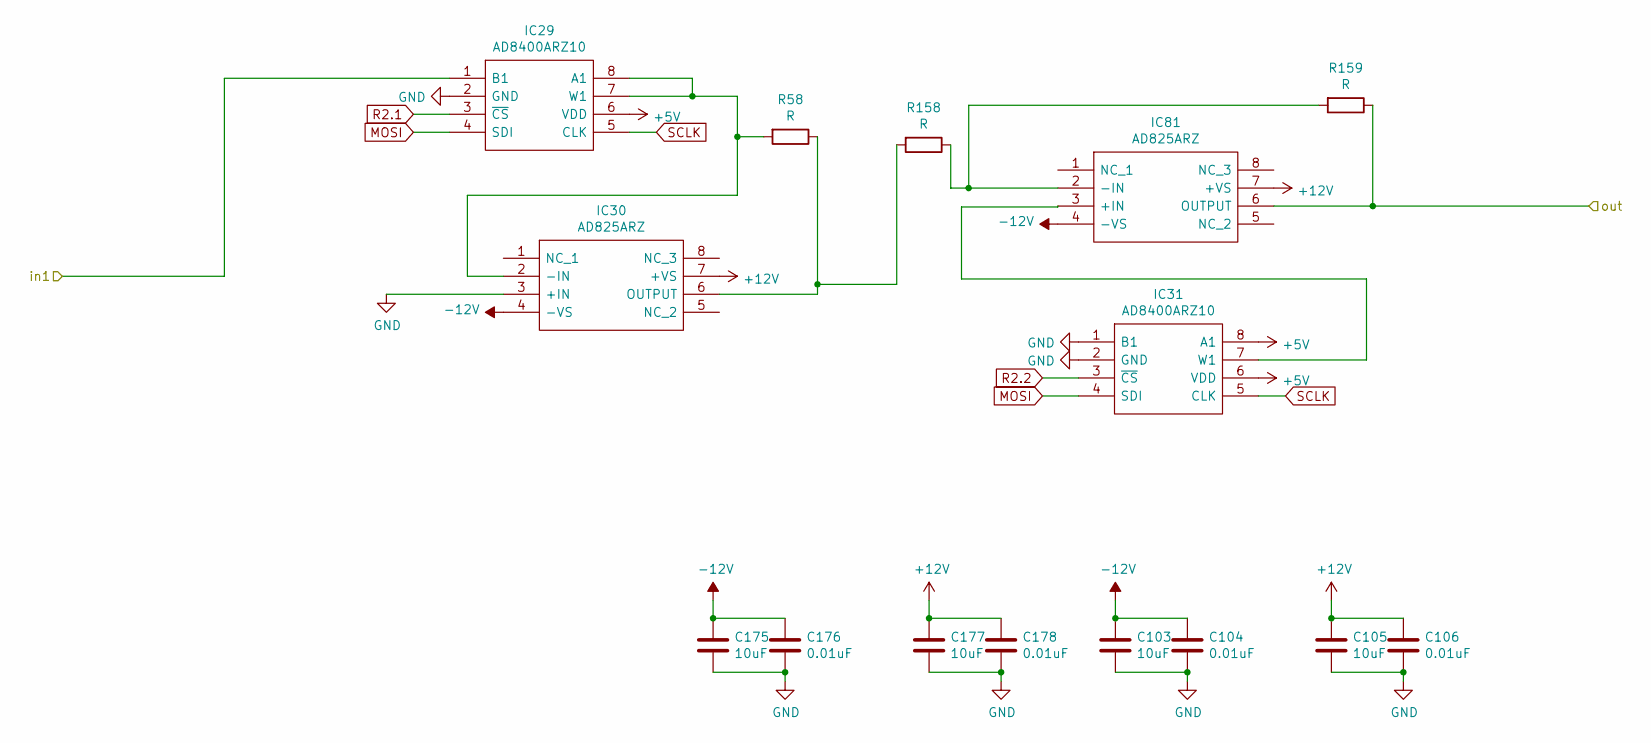
[picture p30: schematic AM2.1.sch]

Parts:
C103, C105, C175, C177: 10uF; C_0603_1608Metric_Pad1.08x0.95mm_HandSolder
C104, C106, C176, C178: 0.01uF; C_0603_1608Metric_Pad1.08x0.95mm_HandSolder
IC29, IC31: AD8400ARZ10; SOIC127P600X175-8N; Manufacturer_Part_Number AD8400ARZ10; Mouser Part Number 584-AD8400ARZ10
IC30, IC81: AD825ARZ; SOIC127P600X175-8N; Manufacturer_Part_Number AD825ARZ; Mouser Part Number 584-AD825ARZ
R58, R158, R159: R; R_0603_1608Metric_Pad0.98x0.95mm_HandSolder

Connections:
+5V: IC29.6 (VDD), IC31.6 (VDD), IC31.8 (A1); also elsewhere on the board
+12V: C105.1, C106.1, C177.1, C178.1, IC30.7 (+VS), IC81.7 (+VS); also elsewhere on the board
-12V: C103.1, C104.1, C175.1, C176.1, IC30.4 (-VS), IC81.4 (-VS); also elsewhere on the board
/Sheet60A37CB5/AM2.1/in1: IC29.1 (B1); also elsewhere on the board
/Sheet60A37CB5/MUX2/S1: IC81.6 (OUTPUT), R159.1; also elsewhere on the board
GND: C103.2, C104.2, C105.2, C106.2, C175.2, C176.2, C177.2, C178.2, IC29.2 (GND), IC30.3 (+IN), IC31.1 (B1), IC31.2 (GND); also elsewhere on the board
MOSI: IC29.4 (SDI), IC31.4 (SDI); also elsewhere on the board
unnamed: IC29.7 (W1), IC29.8 (A1), IC30.2 (-IN), R58.2
unnamed: IC30.6 (OUTPUT), R58.1, R158.2
unnamed: IC31.7 (W1), IC81.3 (+IN)
unnamed: IC81.2 (-IN), R158.1, R159.2
R2.1: IC29.3 (~CS); also elsewhere on the board
R2.2: IC31.3 (~CS); also elsewhere on the board
SCLK: IC29.5 (CLK), IC31.5 (CLK); also elsewhere on the board

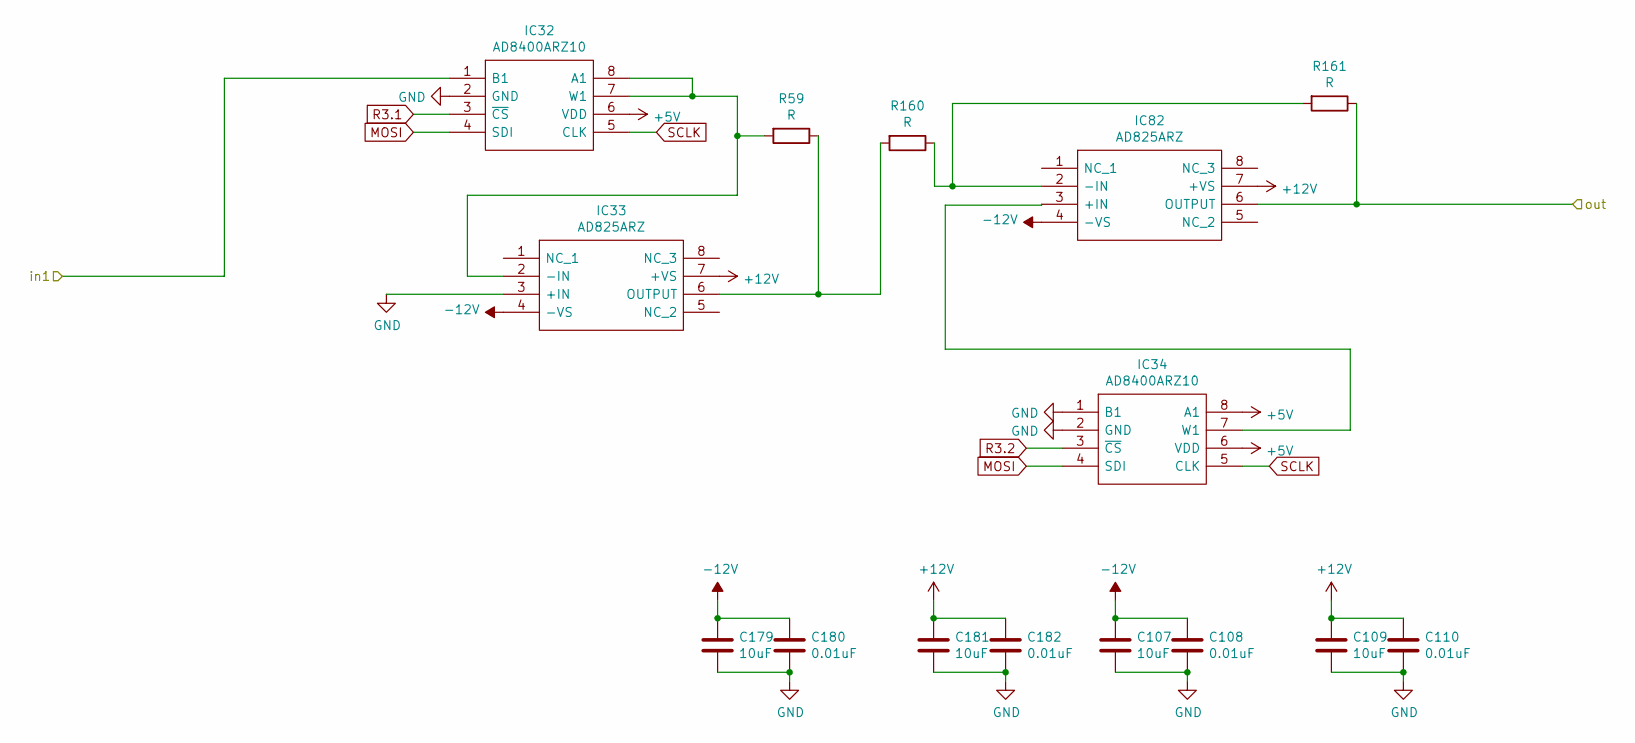
[picture p31: schematic AM3.1.sch]

Parts:
C107, C109, C179, C181: 10uF; C_0603_1608Metric_Pad1.08x0.95mm_HandSolder
C108, C110, C180, C182: 0.01uF; C_0603_1608Metric_Pad1.08x0.95mm_HandSolder
IC32, IC34: AD8400ARZ10; SOIC127P600X175-8N; Manufacturer_Part_Number AD8400ARZ10; Mouser Part Number 584-AD8400ARZ10
IC33, IC82: AD825ARZ; SOIC127P600X175-8N; Manufacturer_Part_Number AD825ARZ; Mouser Part Number 584-AD825ARZ
R59, R160, R161: R; R_0603_1608Metric_Pad0.98x0.95mm_HandSolder

Connections:
+5V: IC32.6 (VDD), IC34.6 (VDD), IC34.8 (A1); also elsewhere on the board
+12V: C109.1, C110.1, C181.1, C182.1, IC33.7 (+VS), IC82.7 (+VS); also elsewhere on the board
-12V: C107.1, C108.1, C179.1, C180.1, IC33.4 (-VS), IC82.4 (-VS); also elsewhere on the board
/Sheet60A37CB5/AM3.1/in1: IC32.1 (B1); also elsewhere on the board
/Sheet60A37CB5/MUX3/S1: IC82.6 (OUTPUT), R161.1; also elsewhere on the board
GND: C107.2, C108.2, C109.2, C110.2, C179.2, C180.2, C181.2, C182.2, IC32.2 (GND), IC33.3 (+IN), IC34.1 (B1), IC34.2 (GND); also elsewhere on the board
MOSI: IC32.4 (SDI), IC34.4 (SDI); also elsewhere on the board
unnamed: IC32.7 (W1), IC32.8 (A1), IC33.2 (-IN), R59.2
unnamed: IC33.6 (OUTPUT), R59.1, R160.2
unnamed: IC34.7 (W1), IC82.3 (+IN)
unnamed: IC82.2 (-IN), R160.1, R161.2
R3.1: IC32.3 (~CS); also elsewhere on the board
R3.2: IC34.3 (~CS); also elsewhere on the board
SCLK: IC32.5 (CLK), IC34.5 (CLK); also elsewhere on the board

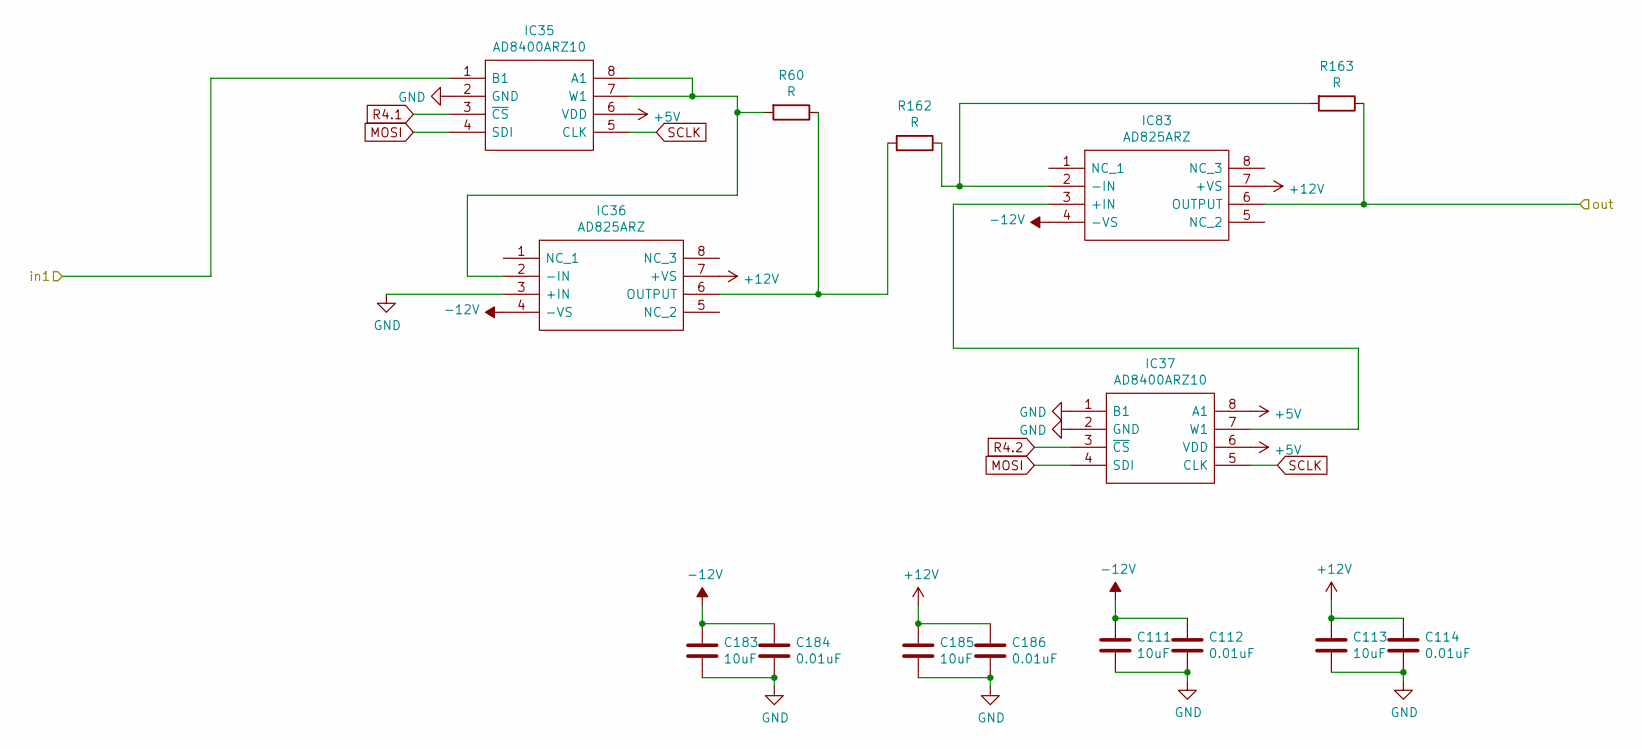
[picture p32: schematic AM4.1.sch]

Parts:
C111, C113, C183, C185: 10uF; C_0603_1608Metric_Pad1.08x0.95mm_HandSolder
C112, C114, C184, C186: 0.01uF; C_0603_1608Metric_Pad1.08x0.95mm_HandSolder
IC35, IC37: AD8400ARZ10; SOIC127P600X175-8N; Manufacturer_Part_Number AD8400ARZ10; Mouser Part Number 584-AD8400ARZ10
IC36, IC83: AD825ARZ; SOIC127P600X175-8N; Manufacturer_Part_Number AD825ARZ; Mouser Part Number 584-AD825ARZ
R60, R162, R163: R; R_0603_1608Metric_Pad0.98x0.95mm_HandSolder

Connections:
+5V: IC35.6 (VDD), IC37.6 (VDD), IC37.8 (A1); also elsewhere on the board
+12V: C113.1, C114.1, C185.1, C186.1, IC36.7 (+VS), IC83.7 (+VS); also elsewhere on the board
-12V: C111.1, C112.1, C183.1, C184.1, IC36.4 (-VS), IC83.4 (-VS); also elsewhere on the board
/Sheet60A37CB5/AM4.1/in1: IC35.1 (B1); also elsewhere on the board
/Sheet60A37CB5/MUX4/S1: IC83.6 (OUTPUT), R163.1; also elsewhere on the board
GND: C111.2, C112.2, C113.2, C114.2, C183.2, C184.2, C185.2, C186.2, IC35.2 (GND), IC36.3 (+IN), IC37.1 (B1), IC37.2 (GND); also elsewhere on the board
MOSI: IC35.4 (SDI), IC37.4 (SDI); also elsewhere on the board
unnamed: IC35.7 (W1), IC35.8 (A1), IC36.2 (-IN), R60.2
unnamed: IC36.6 (OUTPUT), R60.1, R162.2
unnamed: IC37.7 (W1), IC83.3 (+IN)
unnamed: IC83.2 (-IN), R162.1, R163.2
R4.1: IC35.3 (~CS); also elsewhere on the board
R4.2: IC37.3 (~CS); also elsewhere on the board
SCLK: IC35.5 (CLK), IC37.5 (CLK); also elsewhere on the board

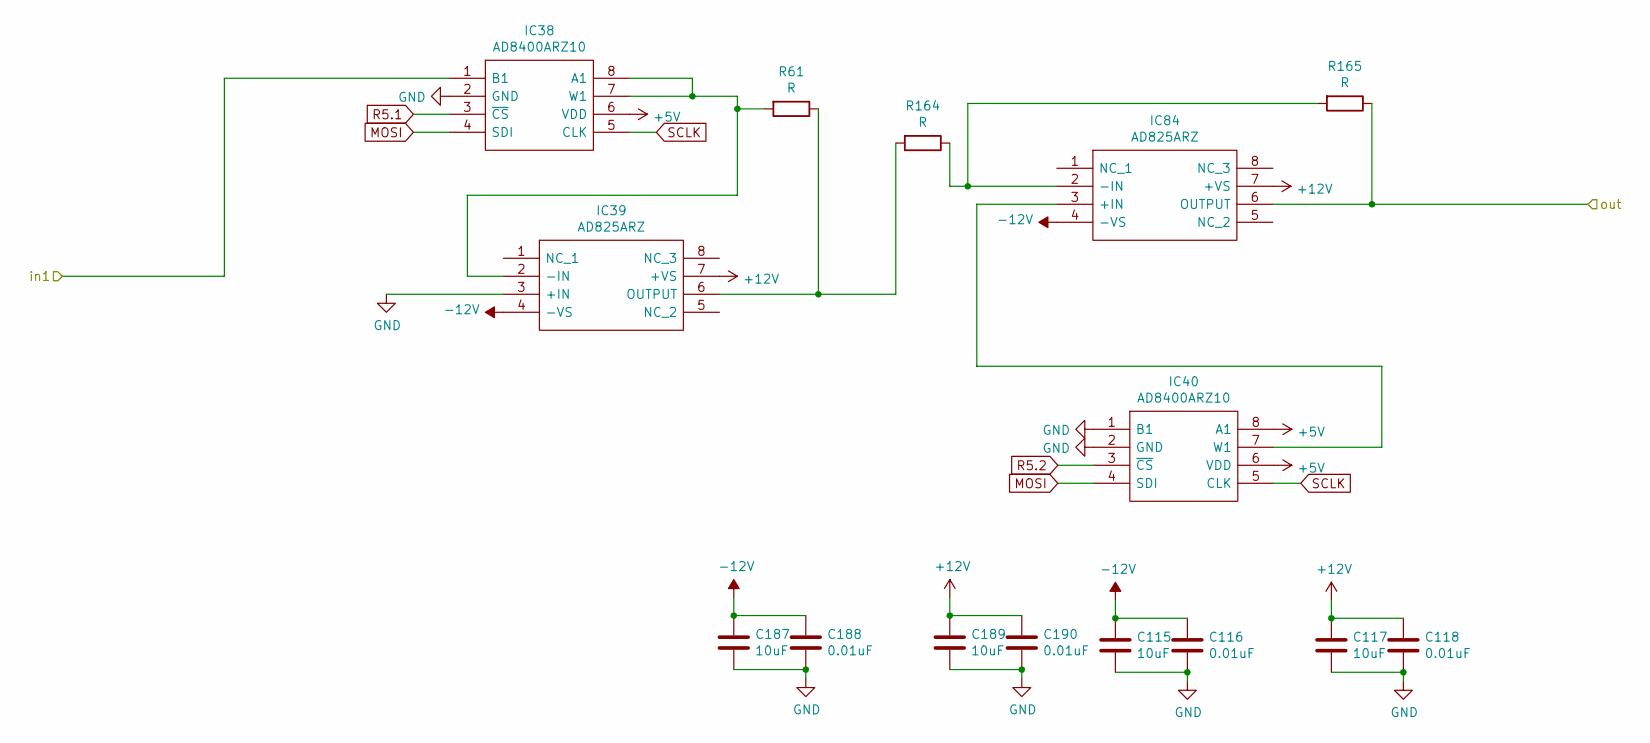
[picture p33: schematic AM5.1.sch]

Parts:
C115, C117, C187, C189: 10uF; C_0603_1608Metric_Pad1.08x0.95mm_HandSolder
C116, C118, C188, C190: 0.01uF; C_0603_1608Metric_Pad1.08x0.95mm_HandSolder
IC38, IC40: AD8400ARZ10; SOIC127P600X175-8N; Manufacturer_Part_Number AD8400ARZ10; Mouser Part Number 584-AD8400ARZ10
IC39, IC84: AD825ARZ; SOIC127P600X175-8N; Manufacturer_Part_Number AD825ARZ; Mouser Part Number 584-AD825ARZ
R61, R164, R165: R; R_0603_1608Metric_Pad0.98x0.95mm_HandSolder

Connections:
+5V: IC38.6 (VDD), IC40.6 (VDD), IC40.8 (A1); also elsewhere on the board
+12V: C117.1, C118.1, C189.1, C190.1, IC39.7 (+VS), IC84.7 (+VS); also elsewhere on the board
-12V: C115.1, C116.1, C187.1, C188.1, IC39.4 (-VS), IC84.4 (-VS); also elsewhere on the board
/Sheet60A37CB5/AM5.1/in1: IC38.1 (B1); also elsewhere on the board
/Sheet60A37CB5/MUX5/S1: IC84.6 (OUTPUT), R165.1; also elsewhere on the board
GND: C115.2, C116.2, C117.2, C118.2, C187.2, C188.2, C189.2, C190.2, IC38.2 (GND), IC39.3 (+IN), IC40.1 (B1), IC40.2 (GND); also elsewhere on the board
MOSI: IC38.4 (SDI), IC40.4 (SDI); also elsewhere on the board
unnamed: IC38.7 (W1), IC38.8 (A1), IC39.2 (-IN), R61.2
unnamed: IC39.6 (OUTPUT), R61.1, R164.2
unnamed: IC40.7 (W1), IC84.3 (+IN)
unnamed: IC84.2 (-IN), R164.1, R165.2
R5.1: IC38.3 (~CS); also elsewhere on the board
R5.2: IC40.3 (~CS); also elsewhere on the board
SCLK: IC38.5 (CLK), IC40.5 (CLK); also elsewhere on the board

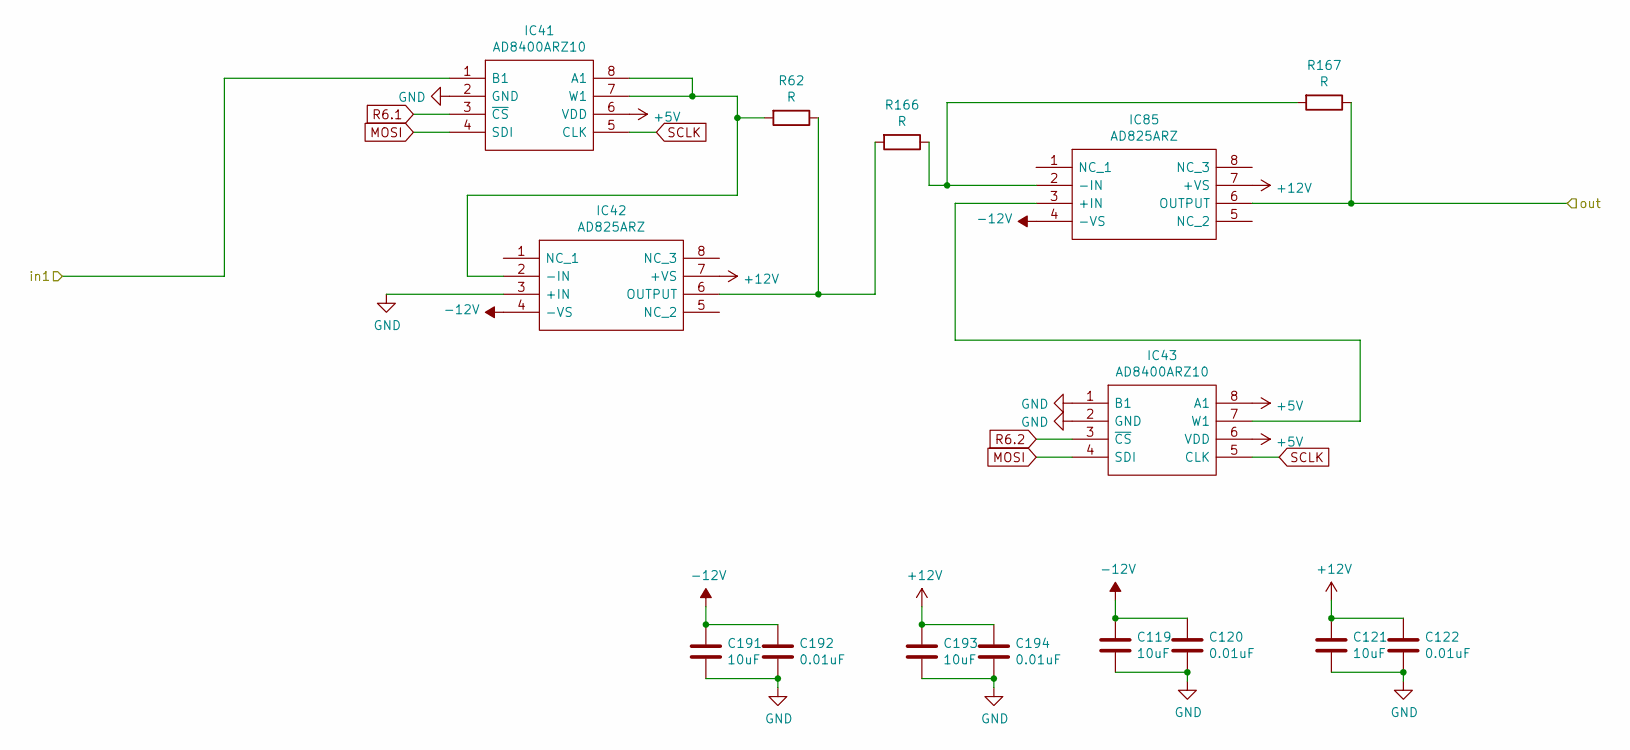
[picture p34: schematic AM6.1.sch]

Parts:
C119, C121, C191, C193: 10uF; C_0603_1608Metric_Pad1.08x0.95mm_HandSolder
C120, C122, C192, C194: 0.01uF; C_0603_1608Metric_Pad1.08x0.95mm_HandSolder
IC41, IC43: AD8400ARZ10; SOIC127P600X175-8N; Manufacturer_Part_Number AD8400ARZ10; Mouser Part Number 584-AD8400ARZ10
IC42, IC85: AD825ARZ; SOIC127P600X175-8N; Manufacturer_Part_Number AD825ARZ; Mouser Part Number 584-AD825ARZ
R62, R166, R167: R; R_0603_1608Metric_Pad0.98x0.95mm_HandSolder

Connections:
+5V: IC41.6 (VDD), IC43.6 (VDD), IC43.8 (A1); also elsewhere on the board
+12V: C121.1, C122.1, C193.1, C194.1, IC42.7 (+VS), IC85.7 (+VS); also elsewhere on the board
-12V: C119.1, C120.1, C191.1, C192.1, IC42.4 (-VS), IC85.4 (-VS); also elsewhere on the board
/Sheet60A37CB5/AM6.1/in1: IC41.1 (B1); also elsewhere on the board
/Sheet60A37CB5/MUX6/S1: IC85.6 (OUTPUT), R167.1; also elsewhere on the board
GND: C119.2, C120.2, C121.2, C122.2, C191.2, C192.2, C193.2, C194.2, IC41.2 (GND), IC42.3 (+IN), IC43.1 (B1), IC43.2 (GND); also elsewhere on the board
MOSI: IC41.4 (SDI), IC43.4 (SDI); also elsewhere on the board
unnamed: IC41.7 (W1), IC41.8 (A1), IC42.2 (-IN), R62.2
unnamed: IC42.6 (OUTPUT), R62.1, R166.2
unnamed: IC43.7 (W1), IC85.3 (+IN)
unnamed: IC85.2 (-IN), R166.1, R167.2
R6.1: IC41.3 (~CS); also elsewhere on the board
R6.2: IC43.3 (~CS); also elsewhere on the board
SCLK: IC41.5 (CLK), IC43.5 (CLK); also elsewhere on the board
