on6315/ADEPT_DEP_Module/ADEPT_PCB_Hardware_Files/circuit_DEP.kicad_pcb

## KiCad design ADEPT_PCB_Hardware_Files/circuit_DEP.kicad_pcb (continued)

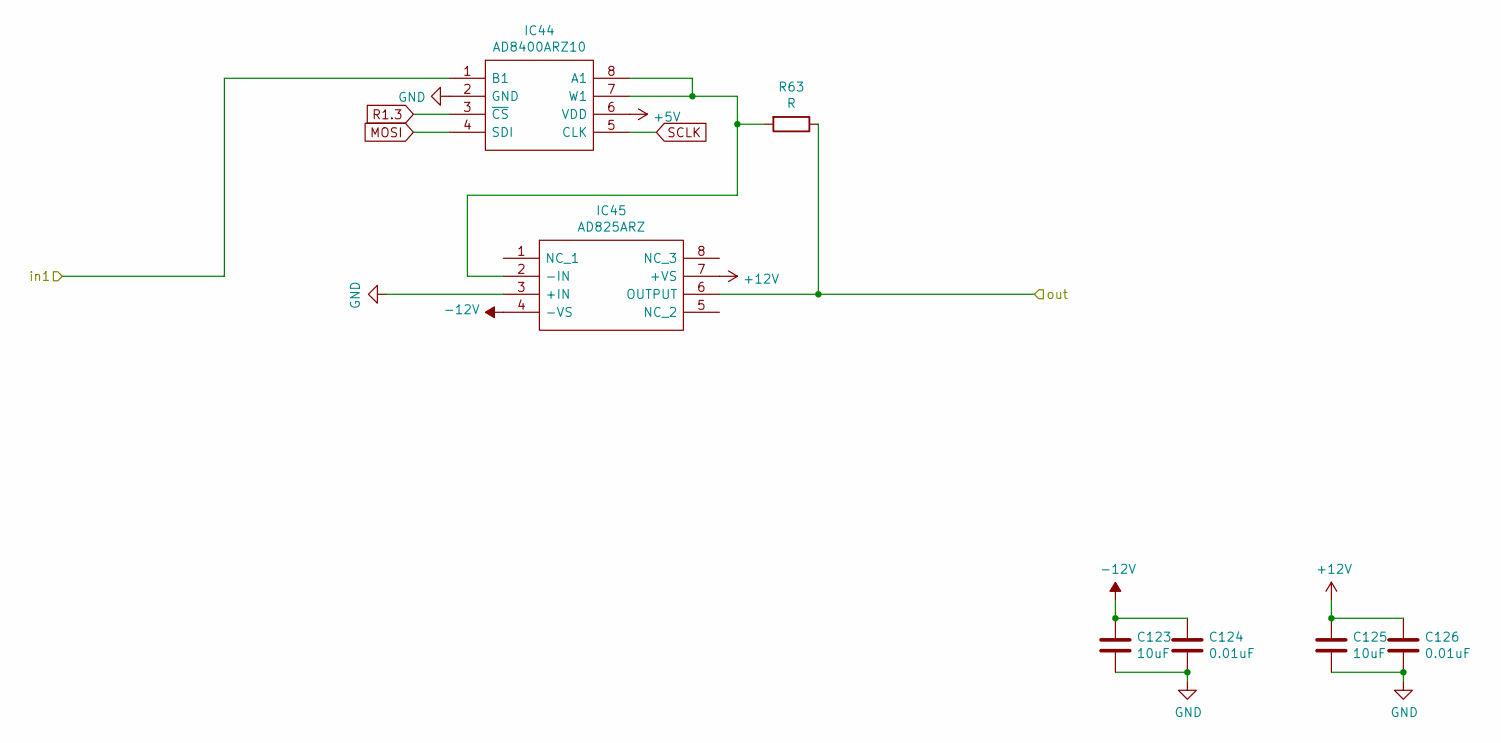
[picture p35: schematic AM1.2.sch]

Parts:
C123, C125: 10uF; C_0603_1608Metric_Pad1.08x0.95mm_HandSolder
C124, C126: 0.01uF; C_0603_1608Metric_Pad1.08x0.95mm_HandSolder
IC44: AD8400ARZ10; SOIC127P600X175-8N; Manufacturer_Part_Number AD8400ARZ10; Mouser Part Number 584-AD8400ARZ10
IC45: AD825ARZ; SOIC127P600X175-8N; Manufacturer_Part_Number AD825ARZ; Mouser Part Number 584-AD825ARZ
R63: R; R_0603_1608Metric_Pad0.98x0.95mm_HandSolder

Connections:
+5V: IC44.6 (VDD); also elsewhere on the board
+12V: C125.1, C126.1, IC45.7 (+VS); also elsewhere on the board
-12V: C123.1, C124.1, IC45.4 (-VS); also elsewhere on the board
/Sheet60A37CB5/AM1.2/in1: IC44.1 (B1); also elsewhere on the board
/Sheet60A37CB5/AM1.2/out: IC45.6 (OUTPUT), R63.1; also elsewhere on the board
GND: C123.2, C124.2, C125.2, C126.2, IC44.2 (GND), IC45.3 (+IN); also elsewhere on the board
MOSI: IC44.4 (SDI); also elsewhere on the board
unnamed: IC44.7 (W1), IC44.8 (A1), IC45.2 (-IN), R63.2
R1.3: IC44.3 (~CS); also elsewhere on the board
SCLK: IC44.5 (CLK); also elsewhere on the board

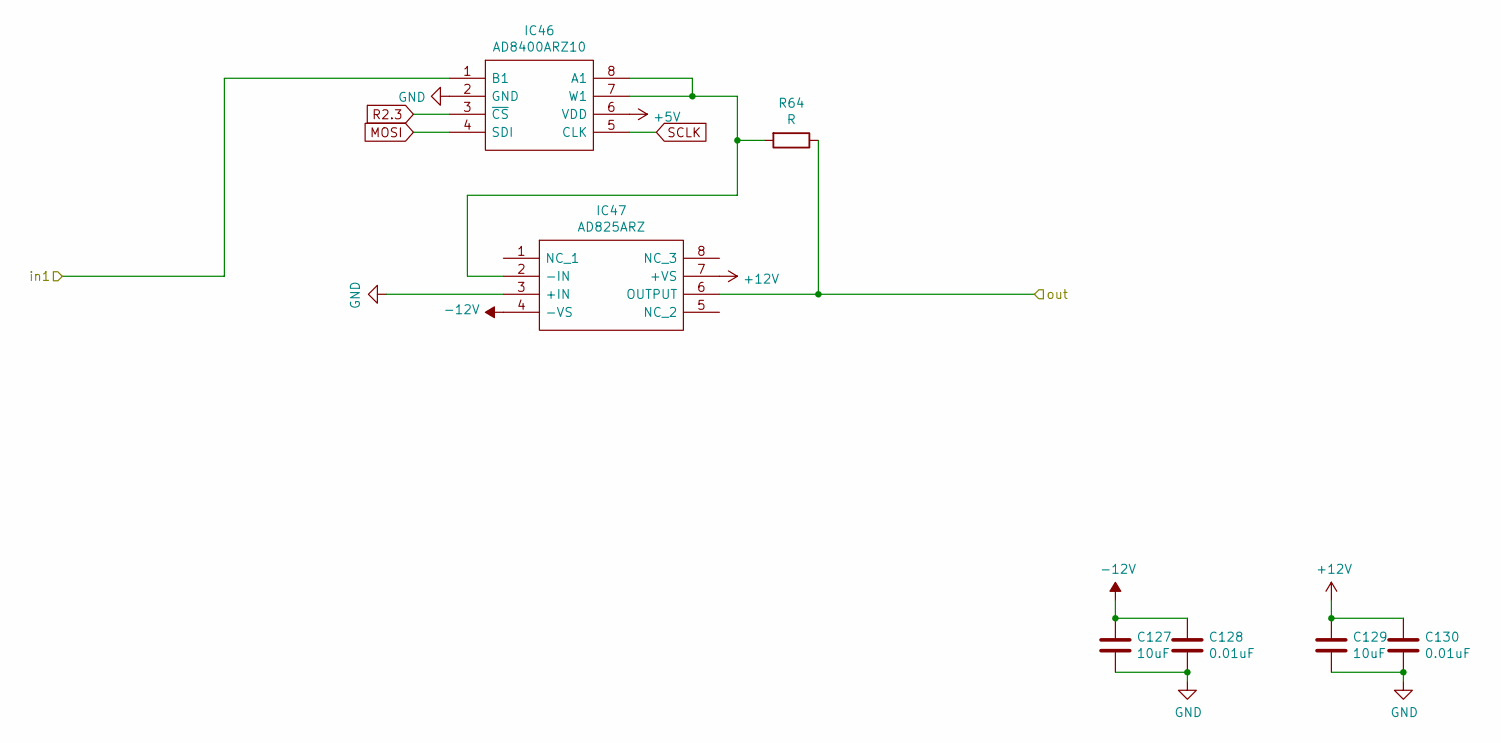
[picture p36: schematic AM2.2.sch]

Parts:
C127, C129: 10uF; C_0603_1608Metric_Pad1.08x0.95mm_HandSolder
C128, C130: 0.01uF; C_0603_1608Metric_Pad1.08x0.95mm_HandSolder
IC46: AD8400ARZ10; SOIC127P600X175-8N; Manufacturer_Part_Number AD8400ARZ10; Mouser Part Number 584-AD8400ARZ10
IC47: AD825ARZ; SOIC127P600X175-8N; Manufacturer_Part_Number AD825ARZ; Mouser Part Number 584-AD825ARZ
R64: R; R_0603_1608Metric_Pad0.98x0.95mm_HandSolder

Connections:
+5V: IC46.6 (VDD); also elsewhere on the board
+12V: C129.1, C130.1, IC47.7 (+VS); also elsewhere on the board
-12V: C127.1, C128.1, IC47.4 (-VS); also elsewhere on the board
/Sheet60A37CB5/AM2.2/in1: IC46.1 (B1); also elsewhere on the board
/Sheet60A37CB5/AM2.2/out: IC47.6 (OUTPUT), R64.1; also elsewhere on the board
GND: C127.2, C128.2, C129.2, C130.2, IC46.2 (GND), IC47.3 (+IN); also elsewhere on the board
MOSI: IC46.4 (SDI); also elsewhere on the board
unnamed: IC46.7 (W1), IC46.8 (A1), IC47.2 (-IN), R64.2
R2.3: IC46.3 (~CS); also elsewhere on the board
SCLK: IC46.5 (CLK); also elsewhere on the board

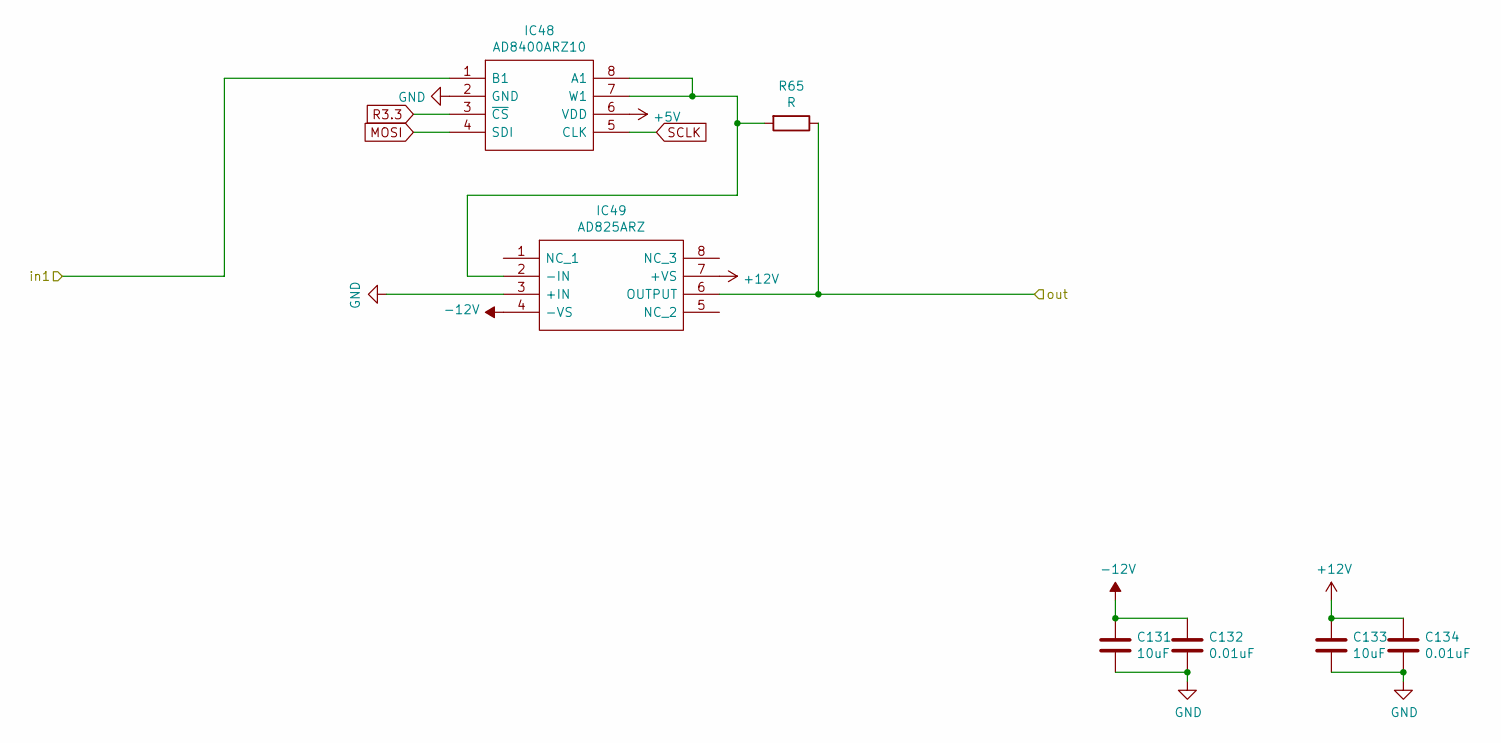
[picture p37: schematic AM3.2.sch]

Parts:
C131, C133: 10uF; C_0603_1608Metric_Pad1.08x0.95mm_HandSolder
C132, C134: 0.01uF; C_0603_1608Metric_Pad1.08x0.95mm_HandSolder
IC48: AD8400ARZ10; SOIC127P600X175-8N; Manufacturer_Part_Number AD8400ARZ10; Mouser Part Number 584-AD8400ARZ10
IC49: AD825ARZ; SOIC127P600X175-8N; Manufacturer_Part_Number AD825ARZ; Mouser Part Number 584-AD825ARZ
R65: R; R_0603_1608Metric_Pad0.98x0.95mm_HandSolder

Connections:
+5V: IC48.6 (VDD); also elsewhere on the board
+12V: C133.1, C134.1, IC49.7 (+VS); also elsewhere on the board
-12V: C131.1, C132.1, IC49.4 (-VS); also elsewhere on the board
/Sheet60A37CB5/AM3.2/in1: IC48.1 (B1); also elsewhere on the board
/Sheet60A37CB5/AM3.2/out: IC49.6 (OUTPUT), R65.1; also elsewhere on the board
GND: C131.2, C132.2, C133.2, C134.2, IC48.2 (GND), IC49.3 (+IN); also elsewhere on the board
MOSI: IC48.4 (SDI); also elsewhere on the board
unnamed: IC48.7 (W1), IC48.8 (A1), IC49.2 (-IN), R65.2
R3.3: IC48.3 (~CS); also elsewhere on the board
SCLK: IC48.5 (CLK); also elsewhere on the board

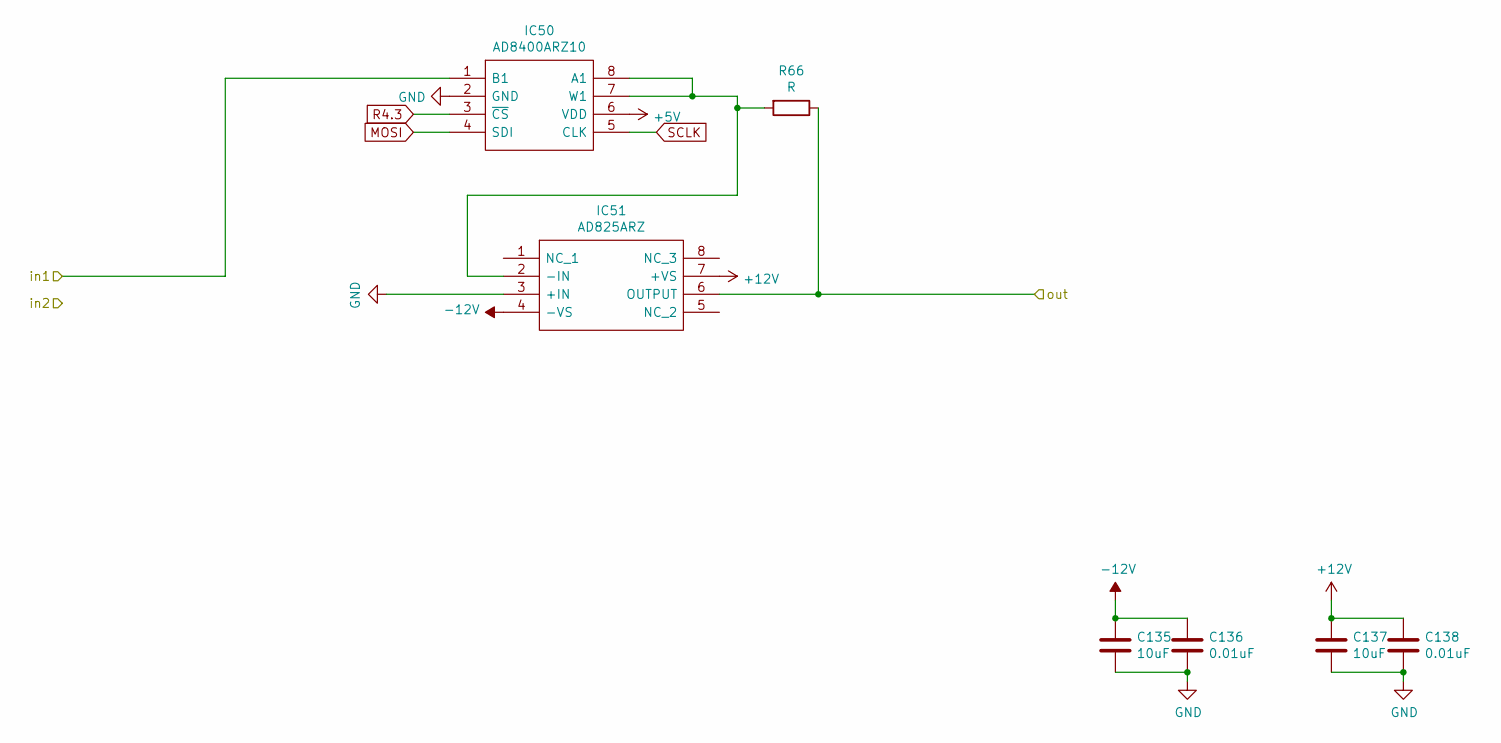
[picture p38: schematic AM4.2.sch]

Parts:
C135, C137: 10uF; C_0603_1608Metric_Pad1.08x0.95mm_HandSolder
C136, C138: 0.01uF; C_0603_1608Metric_Pad1.08x0.95mm_HandSolder
IC50: AD8400ARZ10; SOIC127P600X175-8N; Manufacturer_Part_Number AD8400ARZ10; Mouser Part Number 584-AD8400ARZ10
IC51: AD825ARZ; SOIC127P600X175-8N; Manufacturer_Part_Number AD825ARZ; Mouser Part Number 584-AD825ARZ
R66: R; R_0603_1608Metric_Pad0.98x0.95mm_HandSolder

Connections:
+5V: IC50.6 (VDD); also elsewhere on the board
+12V: C137.1, C138.1, IC51.7 (+VS); also elsewhere on the board
-12V: C135.1, C136.1, IC51.4 (-VS); also elsewhere on the board
/Sheet60A37CB5/AM4.2/in1: IC50.1 (B1); also elsewhere on the board
/Sheet60A37CB5/AM4.2/out: IC51.6 (OUTPUT), R66.1; also elsewhere on the board
GND: C135.2, C136.2, C137.2, C138.2, IC50.2 (GND), IC51.3 (+IN); also elsewhere on the board
MOSI: IC50.4 (SDI); also elsewhere on the board
unnamed: IC50.7 (W1), IC50.8 (A1), IC51.2 (-IN), R66.2
R4.3: IC50.3 (~CS); also elsewhere on the board
SCLK: IC50.5 (CLK); also elsewhere on the board

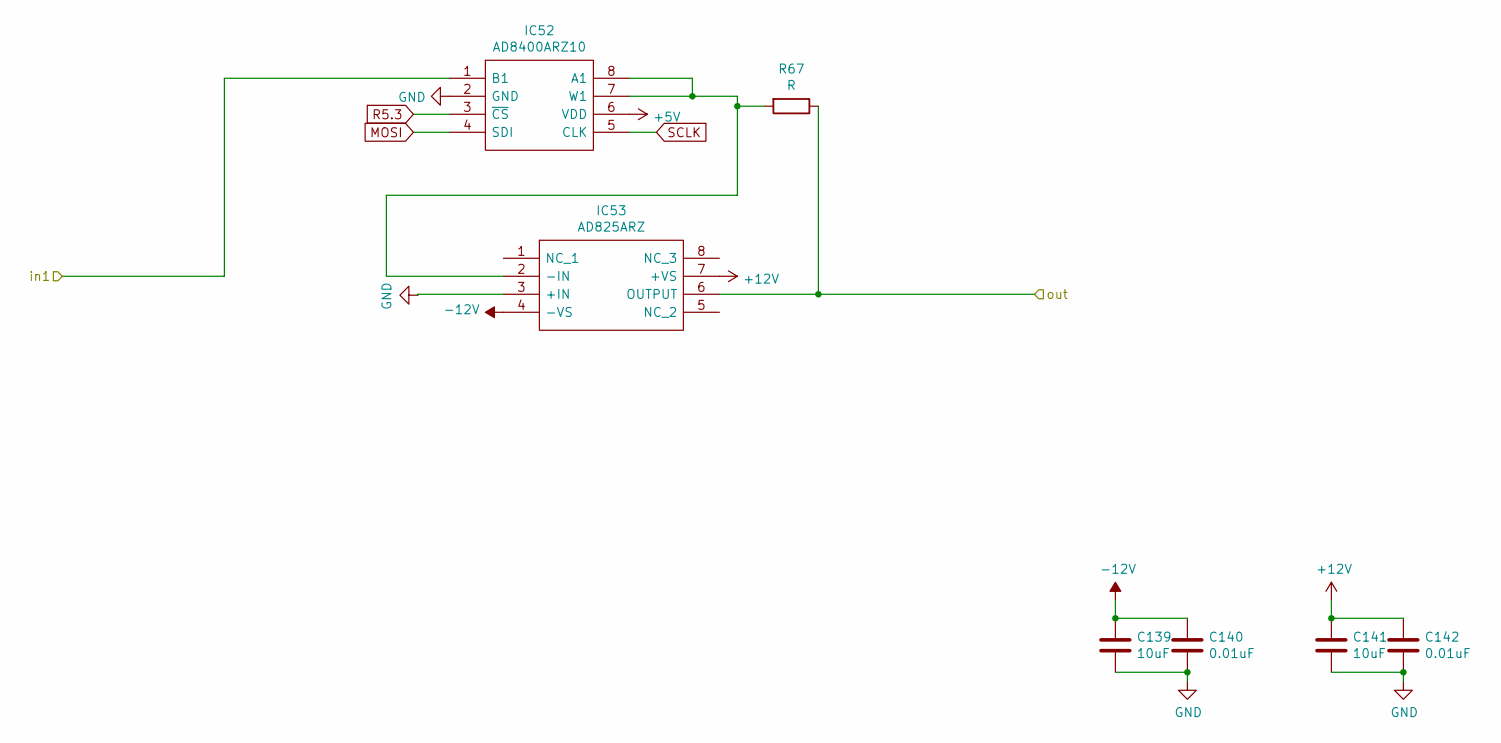
[picture p39: schematic AM5.2.sch]

Parts:
C139, C141: 10uF; C_0603_1608Metric_Pad1.08x0.95mm_HandSolder
C140, C142: 0.01uF; C_0603_1608Metric_Pad1.08x0.95mm_HandSolder
IC52: AD8400ARZ10; SOIC127P600X175-8N; Manufacturer_Part_Number AD8400ARZ10; Mouser Part Number 584-AD8400ARZ10
IC53: AD825ARZ; SOIC127P600X175-8N; Manufacturer_Part_Number AD825ARZ; Mouser Part Number 584-AD825ARZ
R67: R; R_0603_1608Metric_Pad0.98x0.95mm_HandSolder

Connections:
+5V: IC52.6 (VDD); also elsewhere on the board
+12V: C141.1, C142.1, IC53.7 (+VS); also elsewhere on the board
-12V: C139.1, C140.1, IC53.4 (-VS); also elsewhere on the board
/Sheet60A37CB5/AM5.2/in1: IC52.1 (B1); also elsewhere on the board
/Sheet60A37CB5/AM5.2/out: IC53.6 (OUTPUT), R67.1; also elsewhere on the board
GND: C139.2, C140.2, C141.2, C142.2, IC52.2 (GND), IC53.3 (+IN); also elsewhere on the board
MOSI: IC52.4 (SDI); also elsewhere on the board
unnamed: IC52.7 (W1), IC52.8 (A1), IC53.2 (-IN), R67.2
R5.3: IC52.3 (~CS); also elsewhere on the board
SCLK: IC52.5 (CLK); also elsewhere on the board

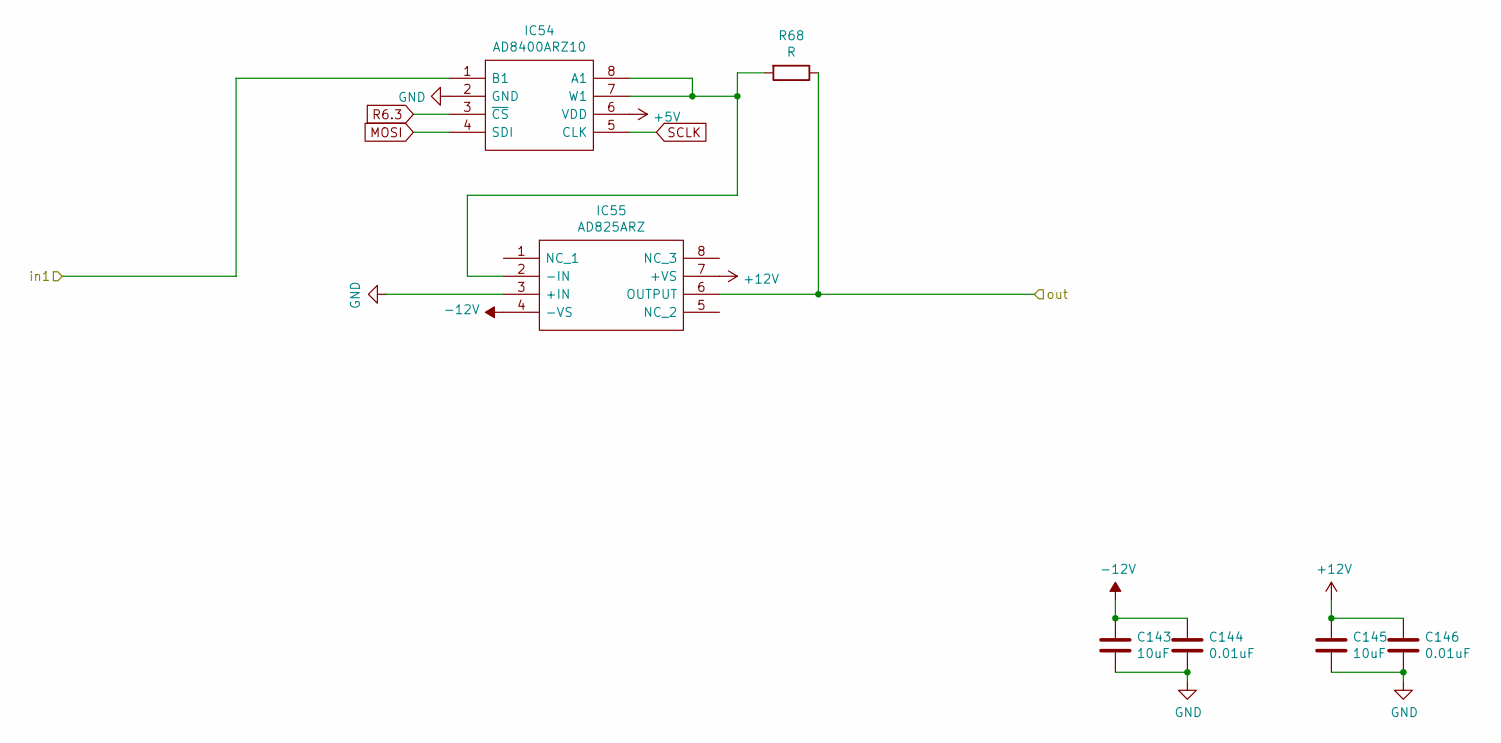
[picture p40: schematic AM6.2.sch]

Parts:
C143, C145: 10uF; C_0603_1608Metric_Pad1.08x0.95mm_HandSolder
C144, C146: 0.01uF; C_0603_1608Metric_Pad1.08x0.95mm_HandSolder
IC54: AD8400ARZ10; SOIC127P600X175-8N; Manufacturer_Part_Number AD8400ARZ10; Mouser Part Number 584-AD8400ARZ10
IC55: AD825ARZ; SOIC127P600X175-8N; Manufacturer_Part_Number AD825ARZ; Mouser Part Number 584-AD825ARZ
R68: R; R_0603_1608Metric_Pad0.98x0.95mm_HandSolder

Connections:
+5V: IC54.6 (VDD); also elsewhere on the board
+12V: C145.1, C146.1, IC55.7 (+VS); also elsewhere on the board
-12V: C143.1, C144.1, IC55.4 (-VS); also elsewhere on the board
/Sheet60A37CB5/AM6.2/in1: IC54.1 (B1); also elsewhere on the board
/Sheet60A37CB5/AM6.2/out: IC55.6 (OUTPUT), R68.1; also elsewhere on the board
GND: C143.2, C144.2, C145.2, C146.2, IC54.2 (GND), IC55.3 (+IN); also elsewhere on the board
MOSI: IC54.4 (SDI); also elsewhere on the board
unnamed: IC54.7 (W1), IC54.8 (A1), IC55.2 (-IN), R68.2
R6.3: IC54.3 (~CS); also elsewhere on the board
SCLK: IC54.5 (CLK); also elsewhere on the board

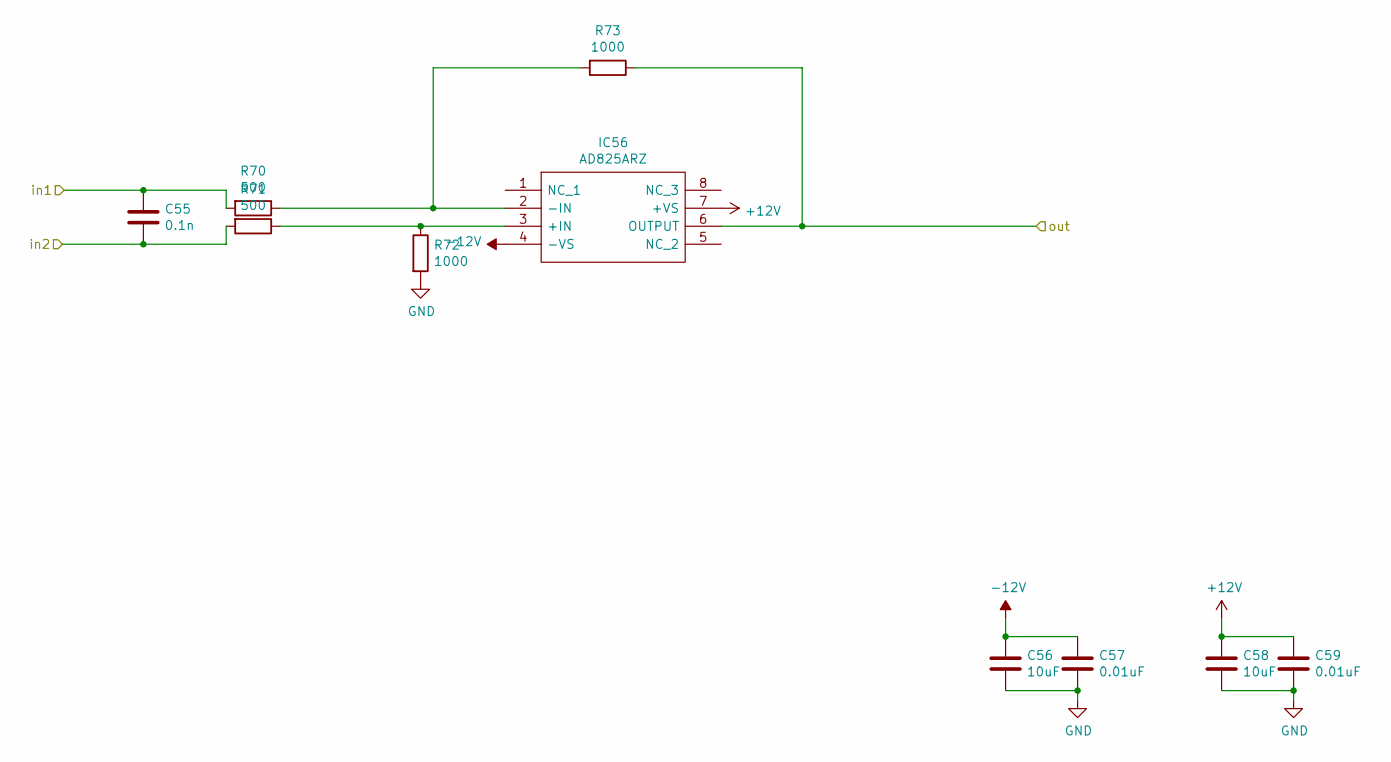
[picture p41: schematic preamp1.sch]

Parts:
C55: 0.1n; C_0603_1608Metric_Pad1.08x0.95mm_HandSolder
C56, C58: 10uF; C_0603_1608Metric_Pad1.08x0.95mm_HandSolder
C57, C59: 0.01uF; C_0603_1608Metric_Pad1.08x0.95mm_HandSolder
IC56: AD825ARZ; SOIC127P600X175-8N; Manufacturer_Part_Number AD825ARZ; Mouser Part Number 584-AD825ARZ
R70, R71: 500; R_0603_1608Metric_Pad0.98x0.95mm_HandSolder
R72, R73: 1000; R_0603_1608Metric_Pad0.98x0.95mm_HandSolder

Connections:
+12V: C58.1, C59.1, IC56.7 (+VS); also elsewhere on the board
-12V: C56.1, C57.1, IC56.4 (-VS); also elsewhere on the board
/Sheet60A37CB5/AM1.1/in1: IC56.6 (OUTPUT), R73.1; also elsewhere on the board
/Sheet60A37CB5/SG1.1/Iout: C55.1, R70.2; also elsewhere on the board
/Sheet60A37CB5/preamp1/in2: C55.2, R71.2; also elsewhere on the board
GND: C56.2, C57.2, C58.2, C59.2, R72.2; also elsewhere on the board
unnamed: IC56.2 (-IN), R70.1, R73.2
unnamed: IC56.3 (+IN), R71.1, R72.1

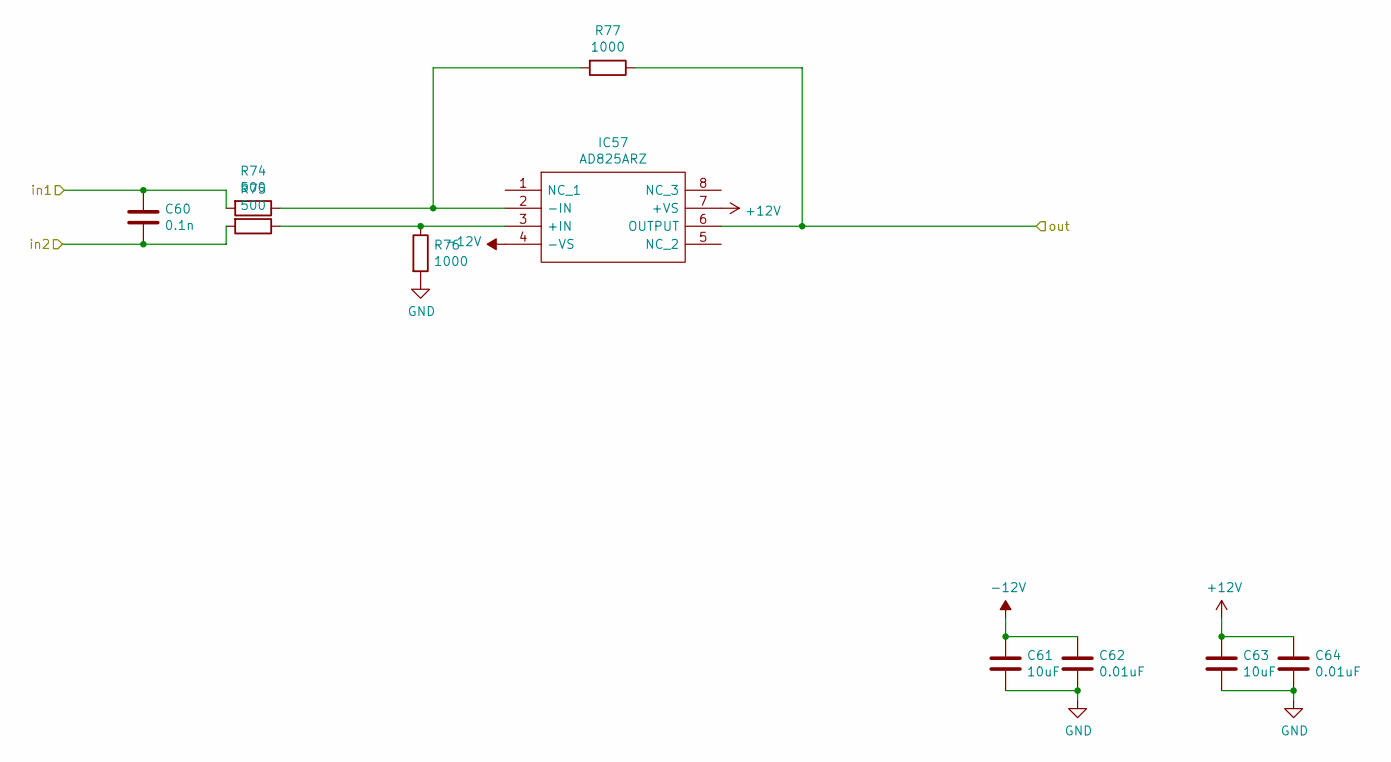
[picture p42: schematic preamp2.sch]

Parts:
C60: 0.1n; C_0603_1608Metric_Pad1.08x0.95mm_HandSolder
C61, C63: 10uF; C_0603_1608Metric_Pad1.08x0.95mm_HandSolder
C62, C64: 0.01uF; C_0603_1608Metric_Pad1.08x0.95mm_HandSolder
IC57: AD825ARZ; SOIC127P600X175-8N; Manufacturer_Part_Number AD825ARZ; Mouser Part Number 584-AD825ARZ
R74, R75: 500; R_0603_1608Metric_Pad0.98x0.95mm_HandSolder
R76, R77: 1000; R_0603_1608Metric_Pad0.98x0.95mm_HandSolder

Connections:
+12V: C63.1, C64.1, IC57.7 (+VS); also elsewhere on the board
-12V: C61.1, C62.1, IC57.4 (-VS); also elsewhere on the board
/Sheet60A37CB5/AM1.2/in1: IC57.6 (OUTPUT), R77.1; also elsewhere on the board
/Sheet60A37CB5/SG1.2/Iout: C60.1, R74.2; also elsewhere on the board
/Sheet60A37CB5/preamp2/in2: C60.2, R75.2; also elsewhere on the board
GND: C61.2, C62.2, C63.2, C64.2, R76.2; also elsewhere on the board
unnamed: IC57.2 (-IN), R74.1, R77.2
unnamed: IC57.3 (+IN), R75.1, R76.1

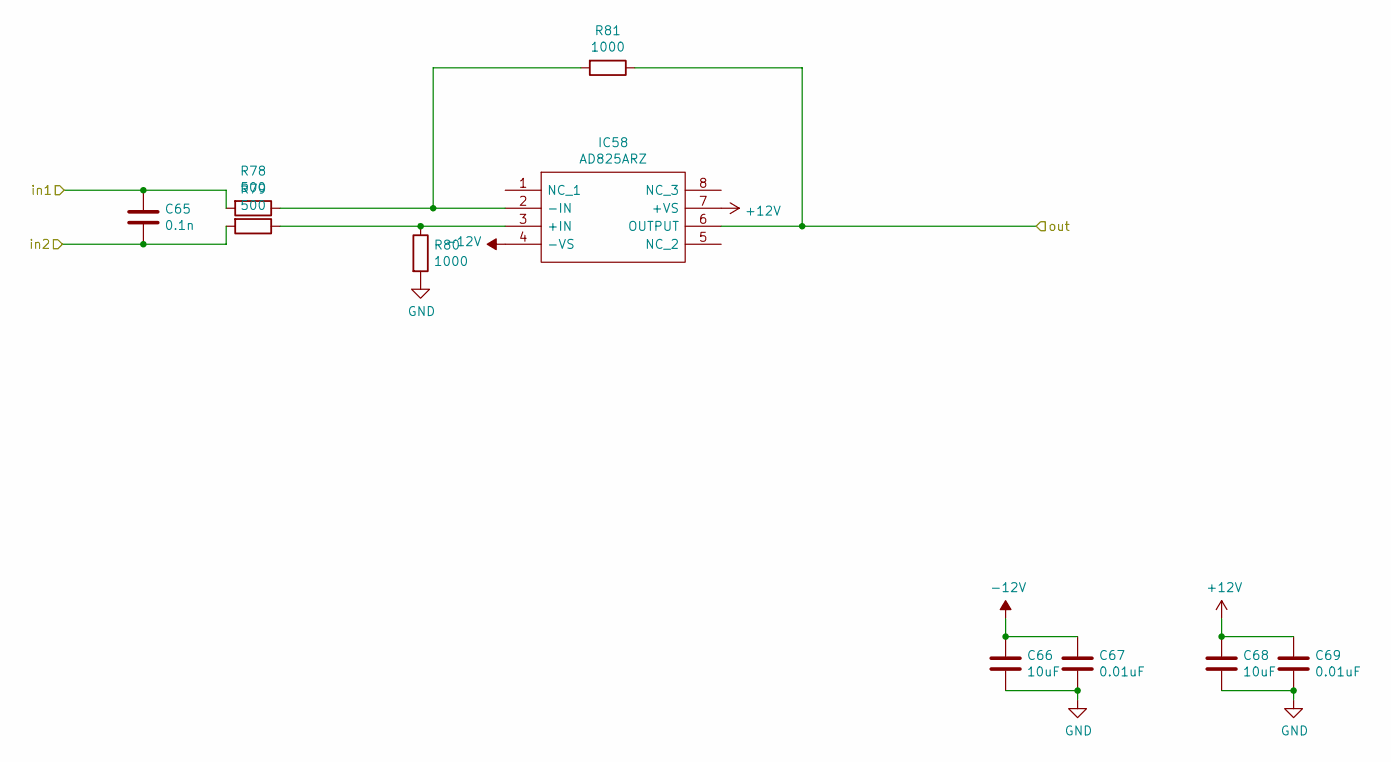
[picture p43: schematic preamp3.sch]

Parts:
C65: 0.1n; C_0603_1608Metric_Pad1.08x0.95mm_HandSolder
C66, C68: 10uF; C_0603_1608Metric_Pad1.08x0.95mm_HandSolder
C67, C69: 0.01uF; C_0603_1608Metric_Pad1.08x0.95mm_HandSolder
IC58: AD825ARZ; SOIC127P600X175-8N; Manufacturer_Part_Number AD825ARZ; Mouser Part Number 584-AD825ARZ
R78, R79: 500; R_0603_1608Metric_Pad0.98x0.95mm_HandSolder
R80, R81: 1000; R_0603_1608Metric_Pad0.98x0.95mm_HandSolder

Connections:
+12V: C68.1, C69.1, IC58.7 (+VS); also elsewhere on the board
-12V: C66.1, C67.1, IC58.4 (-VS); also elsewhere on the board
/Sheet60A37CB5/AM2.1/in1: IC58.6 (OUTPUT), R81.1; also elsewhere on the board
/Sheet60A37CB5/SG2.1/Iout: C65.1, R78.2; also elsewhere on the board
/Sheet60A37CB5/preamp3/in2: C65.2, R79.2; also elsewhere on the board
GND: C66.2, C67.2, C68.2, C69.2, R80.2; also elsewhere on the board
unnamed: IC58.2 (-IN), R78.1, R81.2
unnamed: IC58.3 (+IN), R79.1, R80.1

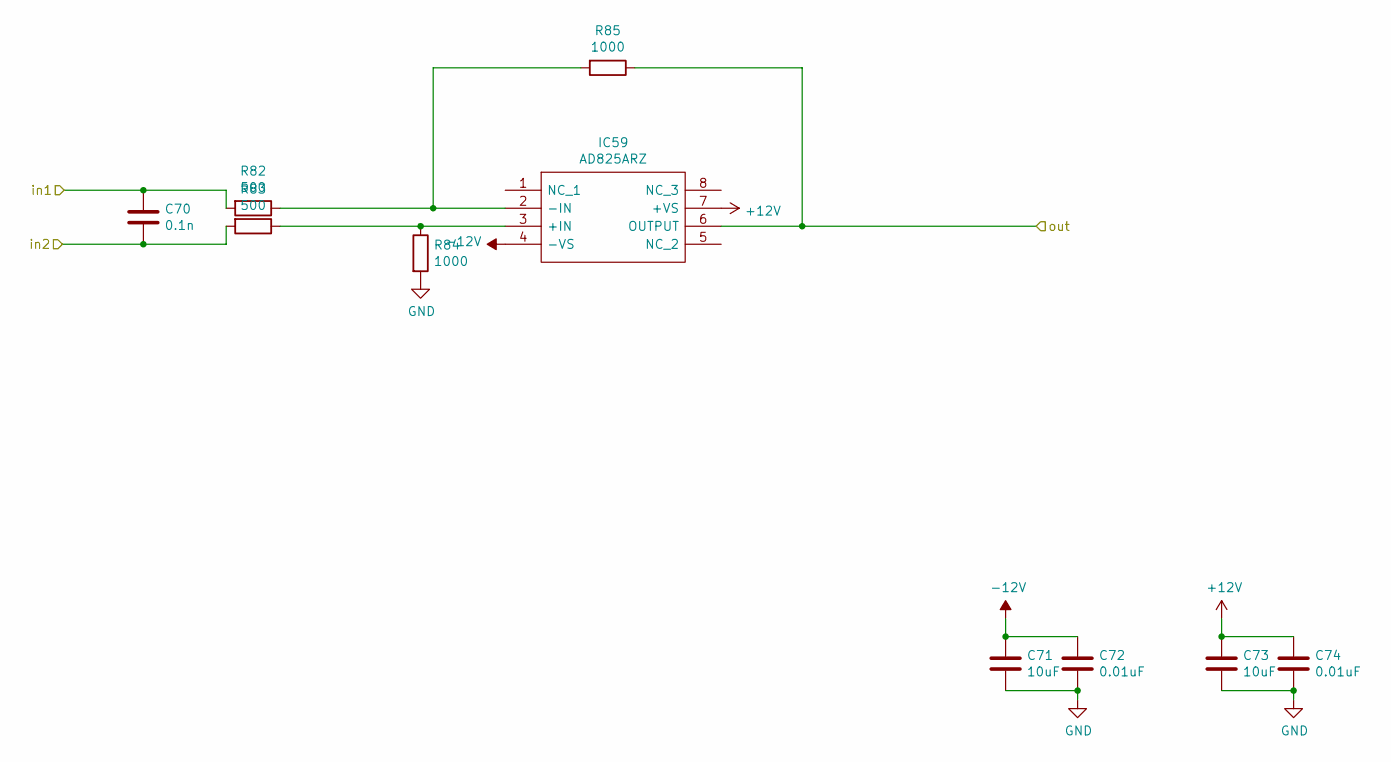
[picture p44: schematic preamp4.sch]

Parts:
C70: 0.1n; C_0603_1608Metric_Pad1.08x0.95mm_HandSolder
C71, C73: 10uF; C_0603_1608Metric_Pad1.08x0.95mm_HandSolder
C72, C74: 0.01uF; C_0603_1608Metric_Pad1.08x0.95mm_HandSolder
IC59: AD825ARZ; SOIC127P600X175-8N; Manufacturer_Part_Number AD825ARZ; Mouser Part Number 584-AD825ARZ
R82, R83: 500; R_0603_1608Metric_Pad0.98x0.95mm_HandSolder
R84, R85: 1000; R_0603_1608Metric_Pad0.98x0.95mm_HandSolder

Connections:
+12V: C73.1, C74.1, IC59.7 (+VS); also elsewhere on the board
-12V: C71.1, C72.1, IC59.4 (-VS); also elsewhere on the board
/Sheet60A37CB5/AM2.2/in1: IC59.6 (OUTPUT), R85.1; also elsewhere on the board
/Sheet60A37CB5/SG2.2/Iout: C70.1, R82.2; also elsewhere on the board
/Sheet60A37CB5/preamp4/in2: C70.2, R83.2; also elsewhere on the board
GND: C71.2, C72.2, C73.2, C74.2, R84.2; also elsewhere on the board
unnamed: IC59.2 (-IN), R82.1, R85.2
unnamed: IC59.3 (+IN), R83.1, R84.1

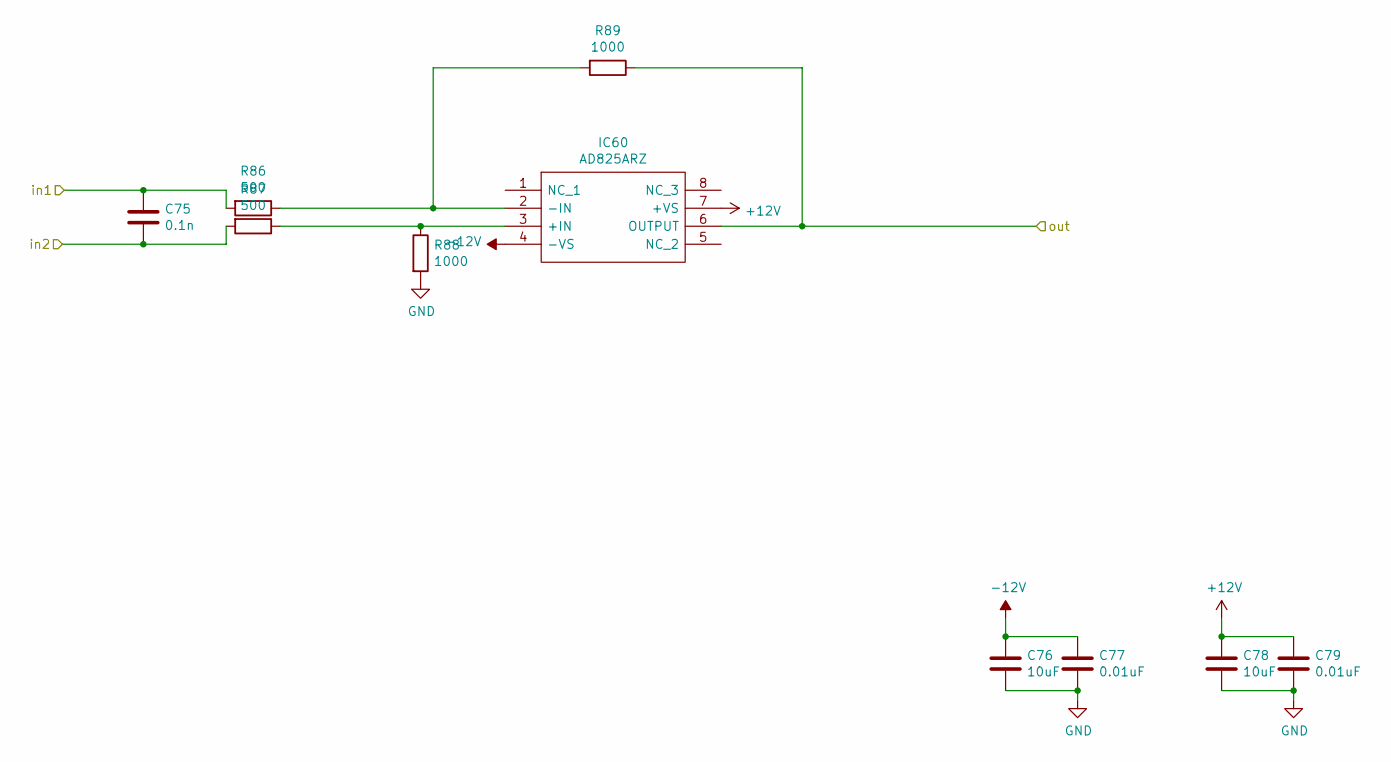
[picture p45: schematic preamp5.sch]

Parts:
C75: 0.1n; C_0603_1608Metric_Pad1.08x0.95mm_HandSolder
C76, C78: 10uF; C_0603_1608Metric_Pad1.08x0.95mm_HandSolder
C77, C79: 0.01uF; C_0603_1608Metric_Pad1.08x0.95mm_HandSolder
IC60: AD825ARZ; SOIC127P600X175-8N; Manufacturer_Part_Number AD825ARZ; Mouser Part Number 584-AD825ARZ
R86, R87: 500; R_0603_1608Metric_Pad0.98x0.95mm_HandSolder
R88, R89: 1000; R_0603_1608Metric_Pad0.98x0.95mm_HandSolder

Connections:
+12V: C78.1, C79.1, IC60.7 (+VS); also elsewhere on the board
-12V: C76.1, C77.1, IC60.4 (-VS); also elsewhere on the board
/Sheet60A37CB5/AM3.1/in1: IC60.6 (OUTPUT), R89.1; also elsewhere on the board
/Sheet60A37CB5/SG3.1/Iout: C75.1, R86.2; also elsewhere on the board
/Sheet60A37CB5/preamp5/in2: C75.2, R87.2; also elsewhere on the board
GND: C76.2, C77.2, C78.2, C79.2, R88.2; also elsewhere on the board
unnamed: IC60.2 (-IN), R86.1, R89.2
unnamed: IC60.3 (+IN), R87.1, R88.1

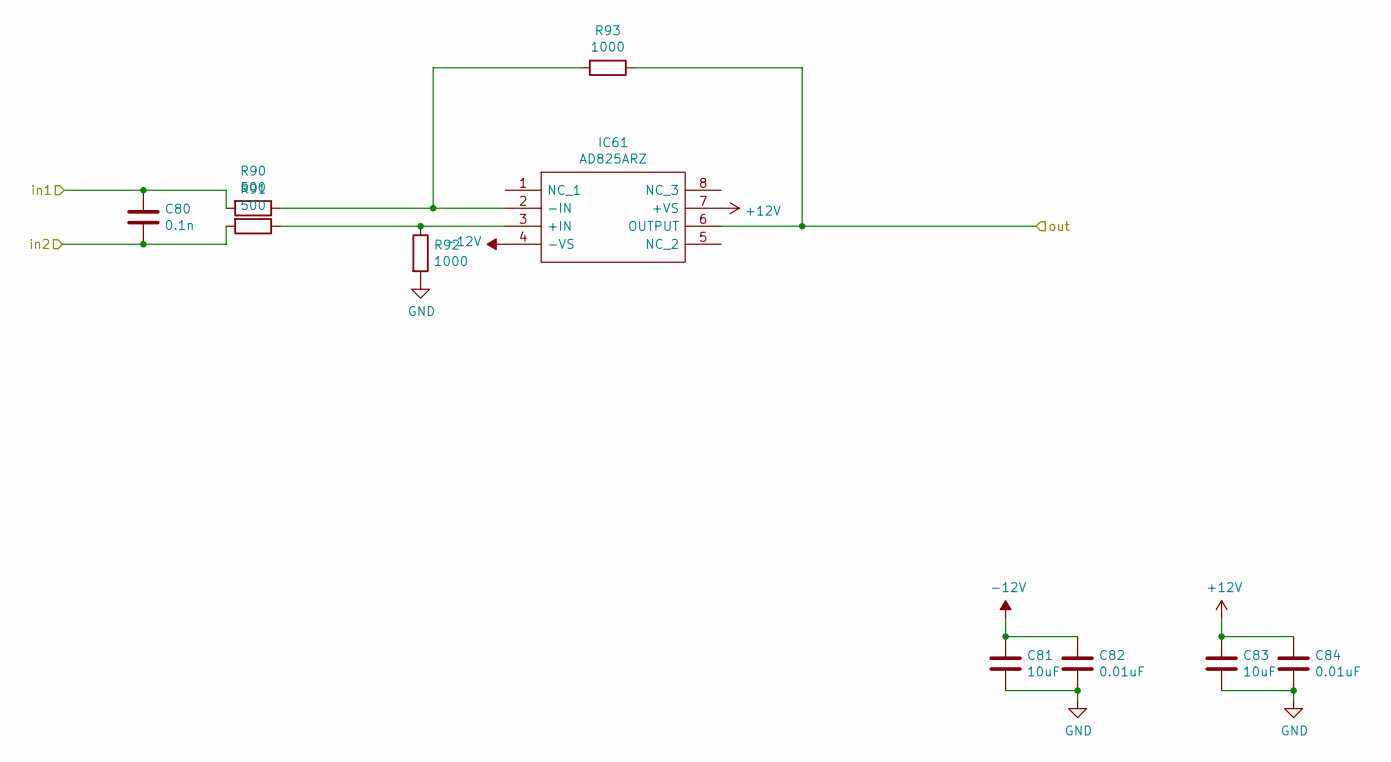
[picture p46: schematic preamp6.sch]

Parts:
C80: 0.1n; C_0603_1608Metric_Pad1.08x0.95mm_HandSolder
C81, C83: 10uF; C_0603_1608Metric_Pad1.08x0.95mm_HandSolder
C82, C84: 0.01uF; C_0603_1608Metric_Pad1.08x0.95mm_HandSolder
IC61: AD825ARZ; SOIC127P600X175-8N; Manufacturer_Part_Number AD825ARZ; Mouser Part Number 584-AD825ARZ
R90, R91: 500; R_0603_1608Metric_Pad0.98x0.95mm_HandSolder
R92, R93: 1000; R_0603_1608Metric_Pad0.98x0.95mm_HandSolder

Connections:
+12V: C83.1, C84.1, IC61.7 (+VS); also elsewhere on the board
-12V: C81.1, C82.1, IC61.4 (-VS); also elsewhere on the board
/Sheet60A37CB5/AM3.2/in1: IC61.6 (OUTPUT), R93.1; also elsewhere on the board
/Sheet60A37CB5/SG3.2/Iout: C80.1, R90.2; also elsewhere on the board
/Sheet60A37CB5/preamp6/in2: C80.2, R91.2; also elsewhere on the board
GND: C81.2, C82.2, C83.2, C84.2, R92.2; also elsewhere on the board
unnamed: IC61.2 (-IN), R90.1, R93.2
unnamed: IC61.3 (+IN), R91.1, R92.1

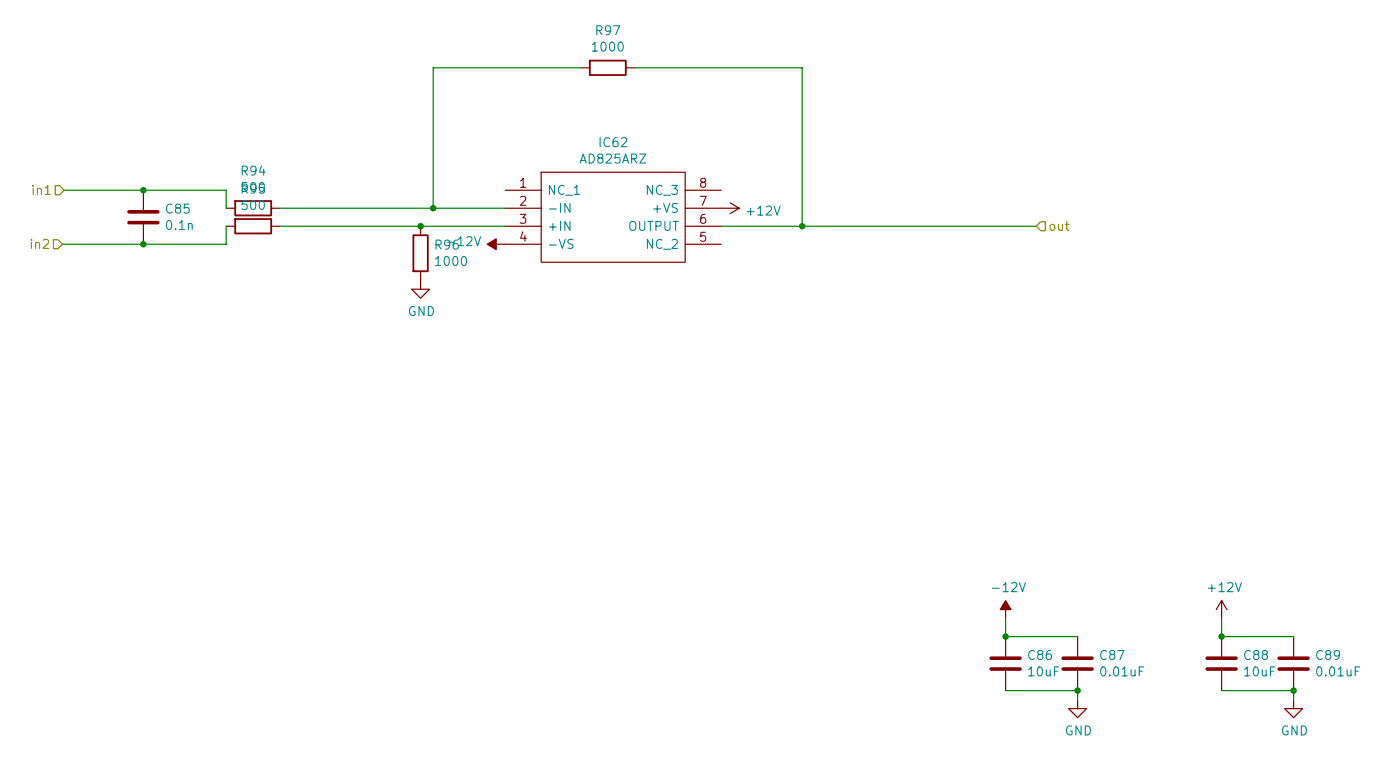
[picture p47: schematic preamp7.sch]

Parts:
C85: 0.1n; C_0603_1608Metric_Pad1.08x0.95mm_HandSolder
C86, C88: 10uF; C_0603_1608Metric_Pad1.08x0.95mm_HandSolder
C87, C89: 0.01uF; C_0603_1608Metric_Pad1.08x0.95mm_HandSolder
IC62: AD825ARZ; SOIC127P600X175-8N; Manufacturer_Part_Number AD825ARZ; Mouser Part Number 584-AD825ARZ
R94, R95: 500; R_0603_1608Metric_Pad0.98x0.95mm_HandSolder
R96, R97: 1000; R_0603_1608Metric_Pad0.98x0.95mm_HandSolder

Connections:
+12V: C88.1, C89.1, IC62.7 (+VS); also elsewhere on the board
-12V: C86.1, C87.1, IC62.4 (-VS); also elsewhere on the board
/Sheet60A37CB5/AM4.1/in1: IC62.6 (OUTPUT), R97.1; also elsewhere on the board
/Sheet60A37CB5/SG4.1/Iout: C85.1, R94.2; also elsewhere on the board
/Sheet60A37CB5/preamp7/in2: C85.2, R95.2; also elsewhere on the board
GND: C86.2, C87.2, C88.2, C89.2, R96.2; also elsewhere on the board
unnamed: IC62.2 (-IN), R94.1, R97.2
unnamed: IC62.3 (+IN), R95.1, R96.1
