on6315/ADEPT_DEP_Module/ADEPT_PCB_Hardware_Files/circuit_DEP.kicad_pcb

## KiCad design ADEPT_PCB_Hardware_Files/circuit_DEP.kicad_pcb (continued)

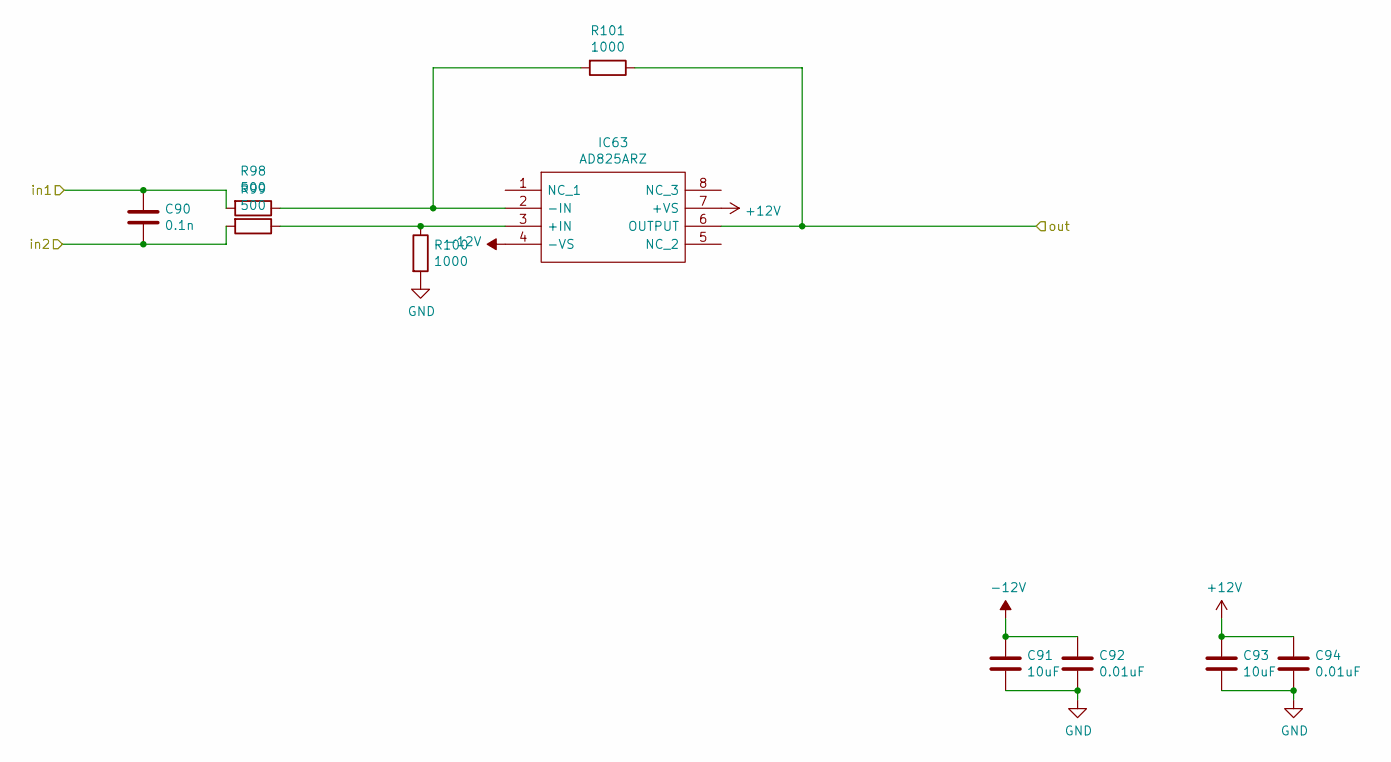
[picture p48: schematic preamp8.sch]

Parts:
C90: 0.1n; C_0603_1608Metric_Pad1.08x0.95mm_HandSolder
C91, C93: 10uF; C_0603_1608Metric_Pad1.08x0.95mm_HandSolder
C92, C94: 0.01uF; C_0603_1608Metric_Pad1.08x0.95mm_HandSolder
IC63: AD825ARZ; SOIC127P600X175-8N; Manufacturer_Part_Number AD825ARZ; Mouser Part Number 584-AD825ARZ
R98, R99: 500; R_0603_1608Metric_Pad0.98x0.95mm_HandSolder
R100, R101: 1000; R_0603_1608Metric_Pad0.98x0.95mm_HandSolder

Connections:
+12V: C93.1, C94.1, IC63.7 (+VS); also elsewhere on the board
-12V: C91.1, C92.1, IC63.4 (-VS); also elsewhere on the board
/Sheet60A37CB5/AM4.2/in1: IC63.6 (OUTPUT), R101.1; also elsewhere on the board
/Sheet60A37CB5/SG4.2/Iout: C90.1, R98.2; also elsewhere on the board
/Sheet60A37CB5/preamp8/in2: C90.2, R99.2; also elsewhere on the board
GND: C91.2, C92.2, C93.2, C94.2, R100.2; also elsewhere on the board
unnamed: IC63.2 (-IN), R98.1, R101.2
unnamed: IC63.3 (+IN), R99.1, R100.1

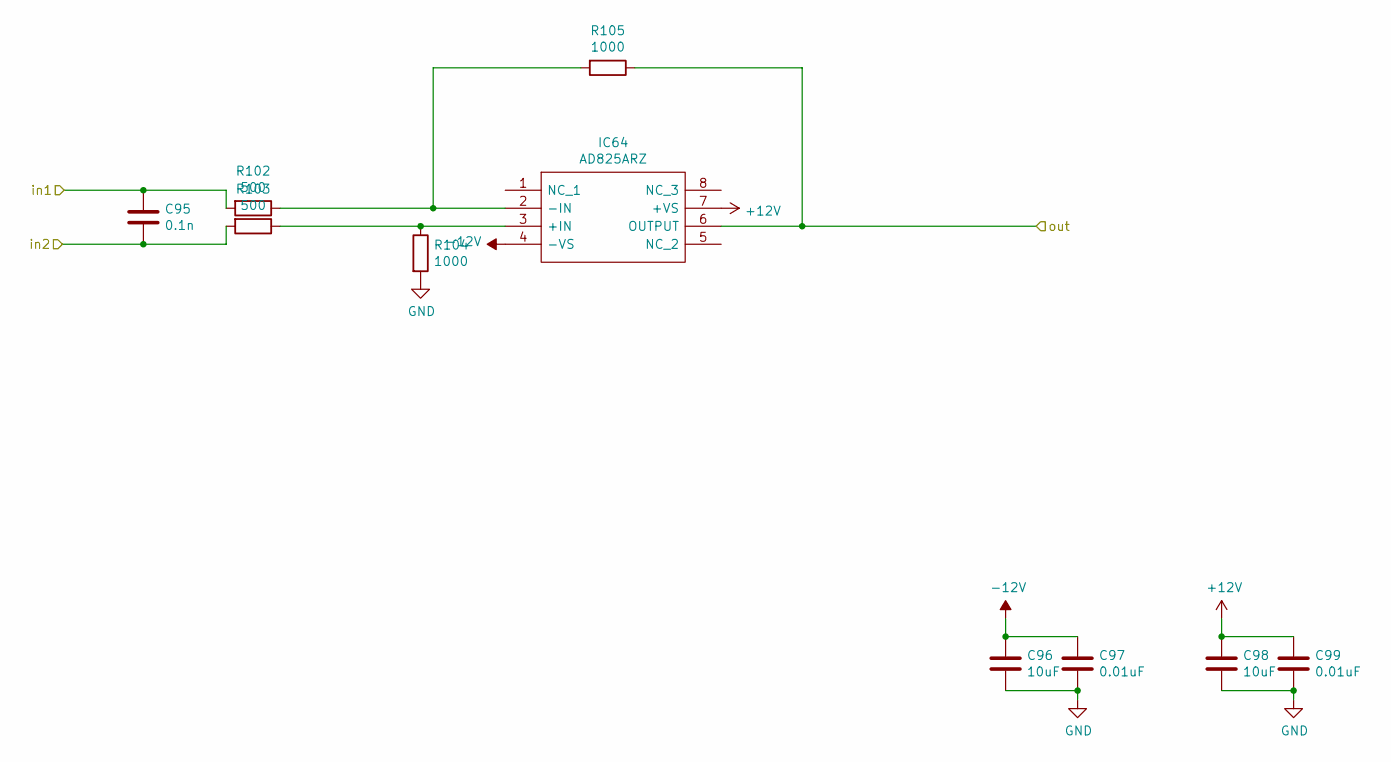
[picture p49: schematic preamp9.sch]

Parts:
C95: 0.1n; C_0603_1608Metric_Pad1.08x0.95mm_HandSolder
C96, C98: 10uF; C_0603_1608Metric_Pad1.08x0.95mm_HandSolder
C97, C99: 0.01uF; C_0603_1608Metric_Pad1.08x0.95mm_HandSolder
IC64: AD825ARZ; SOIC127P600X175-8N; Manufacturer_Part_Number AD825ARZ; Mouser Part Number 584-AD825ARZ
R102, R103: 500; R_0603_1608Metric_Pad0.98x0.95mm_HandSolder
R104, R105: 1000; R_0603_1608Metric_Pad0.98x0.95mm_HandSolder

Connections:
+12V: C98.1, C99.1, IC64.7 (+VS); also elsewhere on the board
-12V: C96.1, C97.1, IC64.4 (-VS); also elsewhere on the board
/Sheet60A37CB5/AM5.1/in1: IC64.6 (OUTPUT), R105.1; also elsewhere on the board
/Sheet60A37CB5/SG5.1/Iout: C95.1, R102.2; also elsewhere on the board
/Sheet60A37CB5/preamp9/in2: C95.2, R103.2; also elsewhere on the board
GND: C96.2, C97.2, C98.2, C99.2, R104.2; also elsewhere on the board
unnamed: IC64.2 (-IN), R102.1, R105.2
unnamed: IC64.3 (+IN), R103.1, R104.1

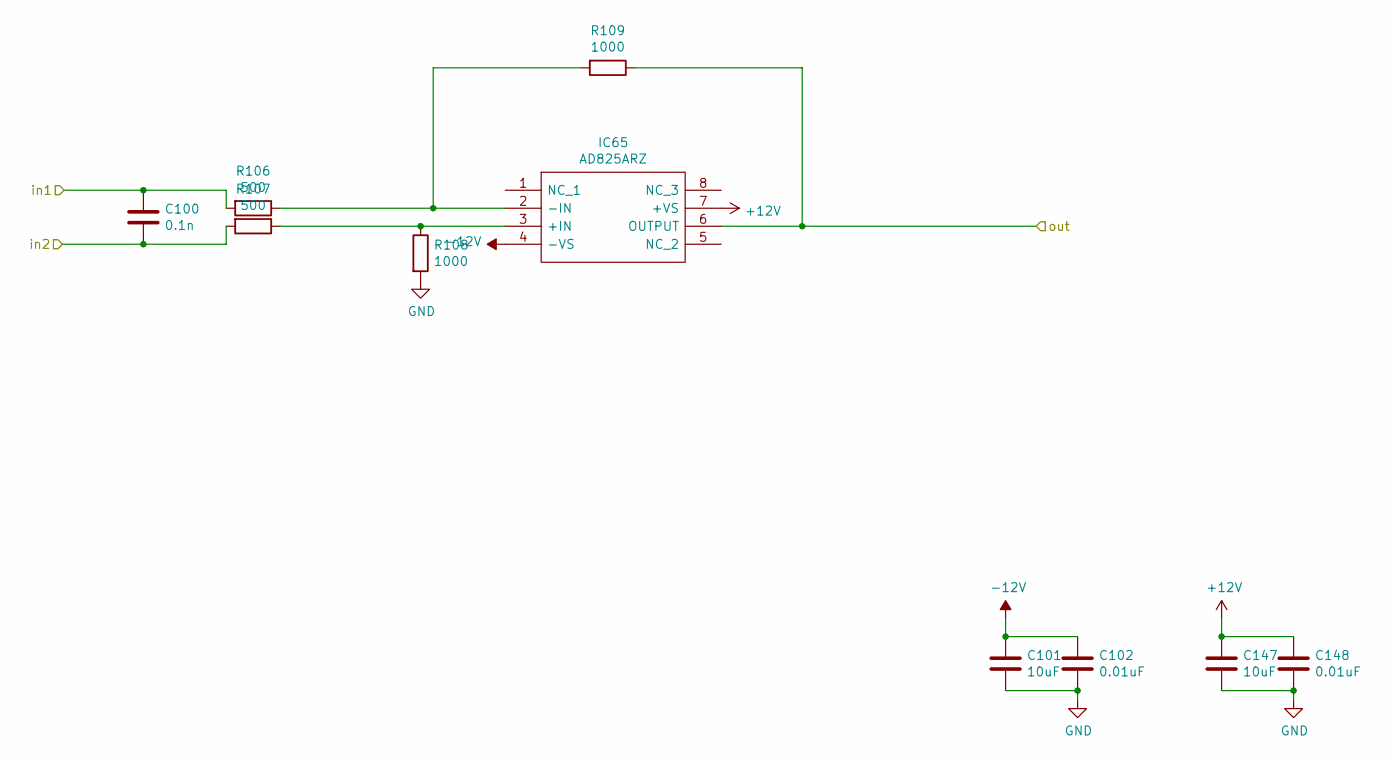
[picture p50: schematic preamp10.sch]

Parts:
C100: 0.1n; C_0603_1608Metric_Pad1.08x0.95mm_HandSolder
C101, C147: 10uF; C_0603_1608Metric_Pad1.08x0.95mm_HandSolder
C102, C148: 0.01uF; C_0603_1608Metric_Pad1.08x0.95mm_HandSolder
IC65: AD825ARZ; SOIC127P600X175-8N; Manufacturer_Part_Number AD825ARZ; Mouser Part Number 584-AD825ARZ
R106, R107: 500; R_0603_1608Metric_Pad0.98x0.95mm_HandSolder
R108, R109: 1000; R_0603_1608Metric_Pad0.98x0.95mm_HandSolder

Connections:
+12V: C147.1, C148.1, IC65.7 (+VS); also elsewhere on the board
-12V: C101.1, C102.1, IC65.4 (-VS); also elsewhere on the board
/Sheet60A37CB5/AM5.2/in1: IC65.6 (OUTPUT), R109.1; also elsewhere on the board
/Sheet60A37CB5/SG5.2/Iout: C100.1, R106.2; also elsewhere on the board
/Sheet60A37CB5/preamp10/in2: C100.2, R107.2; also elsewhere on the board
GND: C101.2, C102.2, C147.2, C148.2, R108.2; also elsewhere on the board
unnamed: IC65.2 (-IN), R106.1, R109.2
unnamed: IC65.3 (+IN), R107.1, R108.1

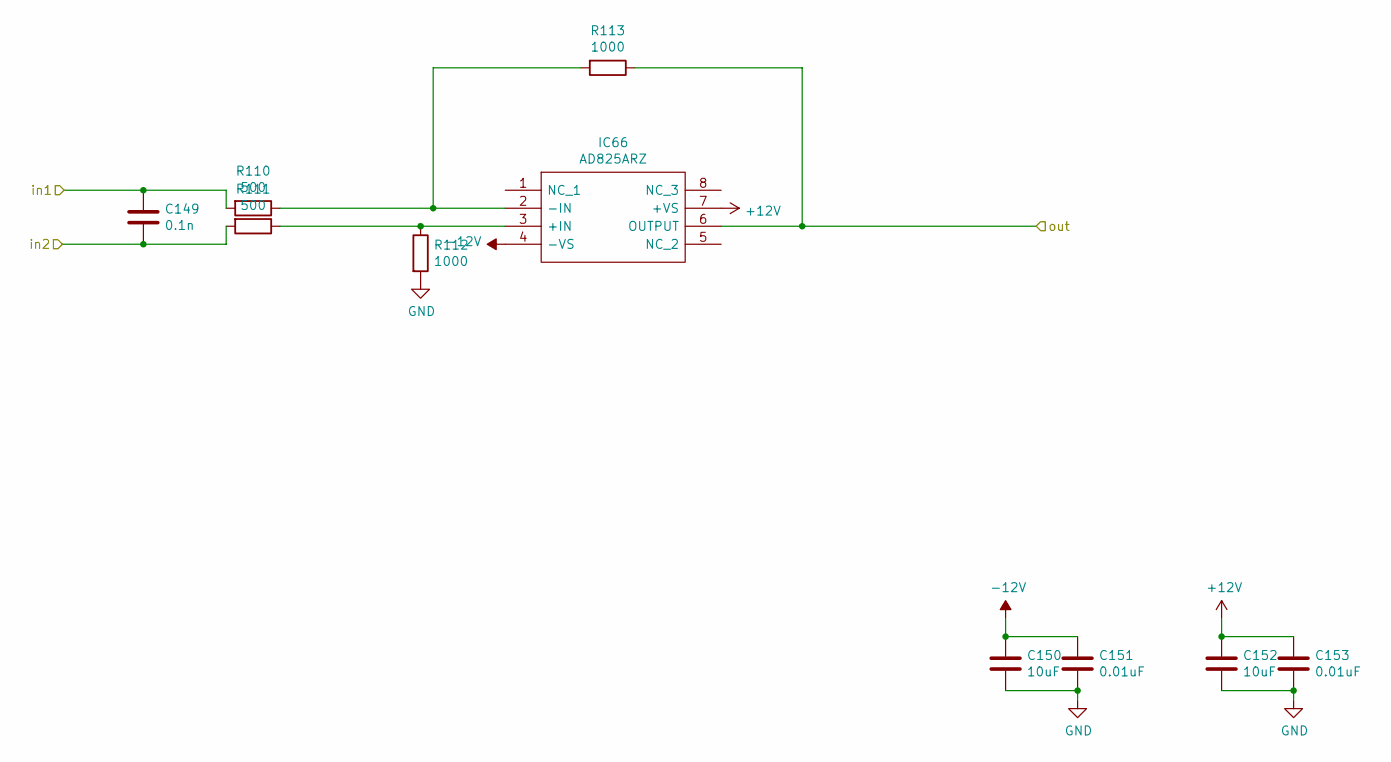
[picture p51: schematic preamp11.sch]

Parts:
C149: 0.1n; C_0603_1608Metric_Pad1.08x0.95mm_HandSolder
C150, C152: 10uF; C_0603_1608Metric_Pad1.08x0.95mm_HandSolder
C151, C153: 0.01uF; C_0603_1608Metric_Pad1.08x0.95mm_HandSolder
IC66: AD825ARZ; SOIC127P600X175-8N; Manufacturer_Part_Number AD825ARZ; Mouser Part Number 584-AD825ARZ
R110, R111: 500; R_0603_1608Metric_Pad0.98x0.95mm_HandSolder
R112, R113: 1000; R_0603_1608Metric_Pad0.98x0.95mm_HandSolder

Connections:
+12V: C152.1, C153.1, IC66.7 (+VS); also elsewhere on the board
-12V: C150.1, C151.1, IC66.4 (-VS); also elsewhere on the board
/Sheet60A37CB5/AM6.1/in1: IC66.6 (OUTPUT), R113.1; also elsewhere on the board
/Sheet60A37CB5/SG6.1/Iout: C149.1, R110.2; also elsewhere on the board
/Sheet60A37CB5/preamp11/in2: C149.2, R111.2; also elsewhere on the board
GND: C150.2, C151.2, C152.2, C153.2, R112.2; also elsewhere on the board
unnamed: IC66.2 (-IN), R110.1, R113.2
unnamed: IC66.3 (+IN), R111.1, R112.1

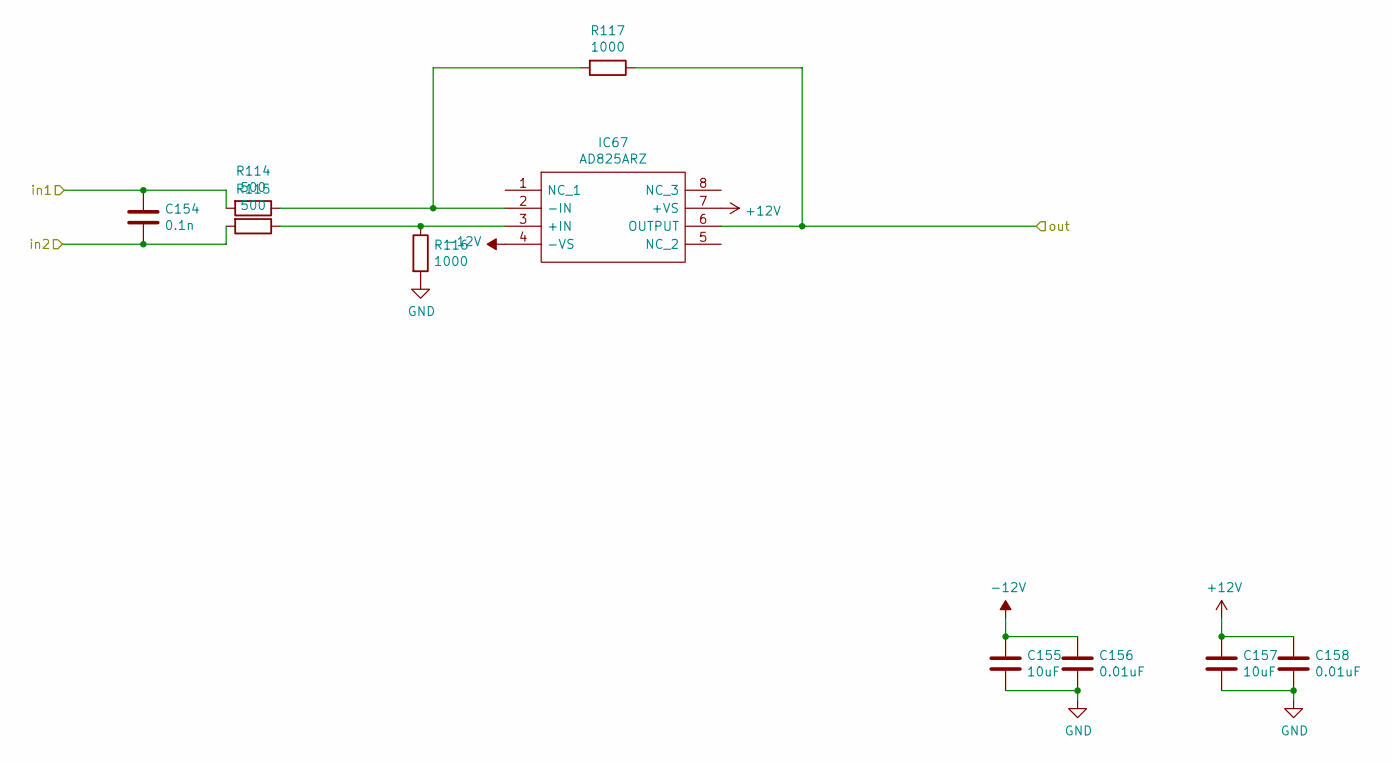
[picture p52: schematic preamp12.sch]

Parts:
C154: 0.1n; C_0603_1608Metric_Pad1.08x0.95mm_HandSolder
C155, C157: 10uF; C_0603_1608Metric_Pad1.08x0.95mm_HandSolder
C156, C158: 0.01uF; C_0603_1608Metric_Pad1.08x0.95mm_HandSolder
IC67: AD825ARZ; SOIC127P600X175-8N; Manufacturer_Part_Number AD825ARZ; Mouser Part Number 584-AD825ARZ
R114, R115: 500; R_0603_1608Metric_Pad0.98x0.95mm_HandSolder
R116, R117: 1000; R_0603_1608Metric_Pad0.98x0.95mm_HandSolder

Connections:
+12V: C157.1, C158.1, IC67.7 (+VS); also elsewhere on the board
-12V: C155.1, C156.1, IC67.4 (-VS); also elsewhere on the board
/Sheet60A37CB5/AM6.2/in1: IC67.6 (OUTPUT), R117.1; also elsewhere on the board
/Sheet60A37CB5/SG6.2/Iout: C154.1, R114.2; also elsewhere on the board
/Sheet60A37CB5/preamp12/in2: C154.2, R115.2; also elsewhere on the board
GND: C155.2, C156.2, C157.2, C158.2, R116.2; also elsewhere on the board
unnamed: IC67.2 (-IN), R114.1, R117.2
unnamed: IC67.3 (+IN), R115.1, R116.1

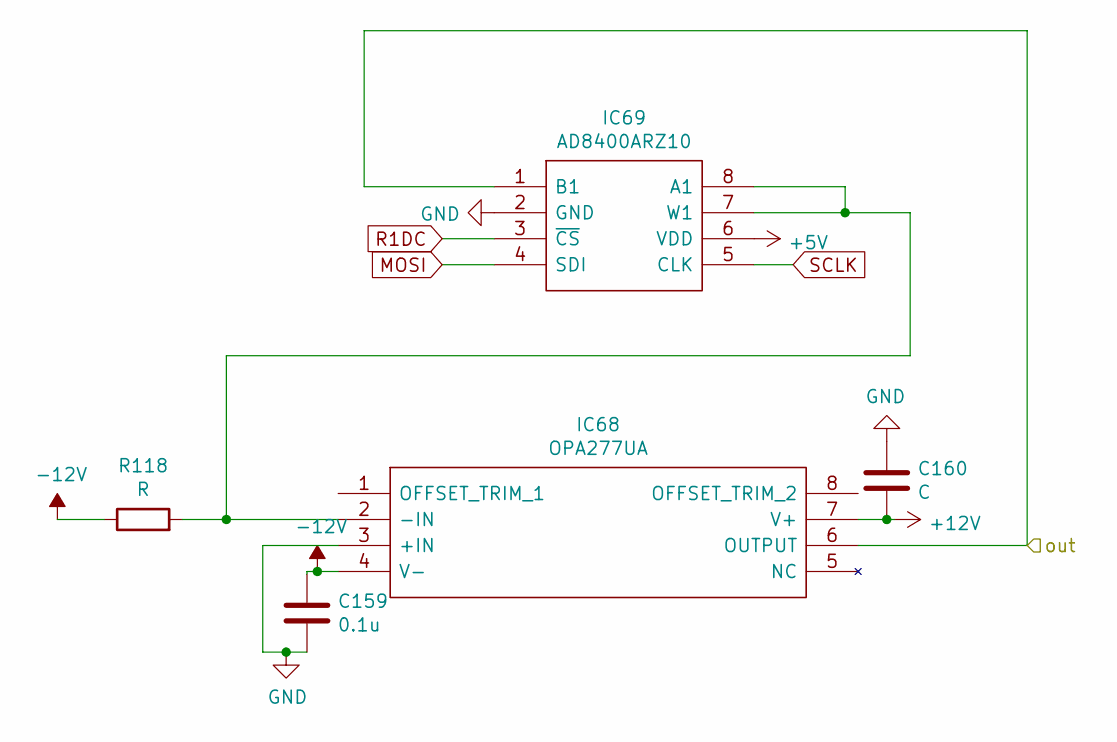
[picture p53: schematic DC1.sch]

Parts:
C159: 0.1u; C_0603_1608Metric_Pad1.08x0.95mm_HandSolder
C160: C; C_0603_1608Metric_Pad1.08x0.95mm_HandSolder
IC68: OPA277UA; SOIC127P600X175-8N; Manufacturer_Part_Number OPA277UA; Mouser Part Number 595-OPA277UA
IC69: AD8400ARZ10; SOIC127P600X175-8N; Manufacturer_Part_Number AD8400ARZ10; Mouser Part Number 584-AD8400ARZ10
R118: R; R_0603_1608Metric_Pad0.98x0.95mm_HandSolder

Connections:
+5V: IC69.6 (VDD); also elsewhere on the board
+12V: C160.2, IC68.7 (V+); also elsewhere on the board
-12V: C159.1, IC68.4 (V-), R118.1; also elsewhere on the board
/Sheet60A37CB5/MUX1/S2: IC68.6 (OUTPUT), IC69.1 (B1); also elsewhere on the board
GND: C159.2, C160.1, IC68.3 (+IN), IC69.2 (GND); also elsewhere on the board
MOSI: IC69.4 (SDI); also elsewhere on the board
unnamed: IC68.2 (-IN), IC69.7 (W1), IC69.8 (A1), R118.2
R1DC: IC69.3 (~CS); also elsewhere on the board
SCLK: IC69.5 (CLK); also elsewhere on the board

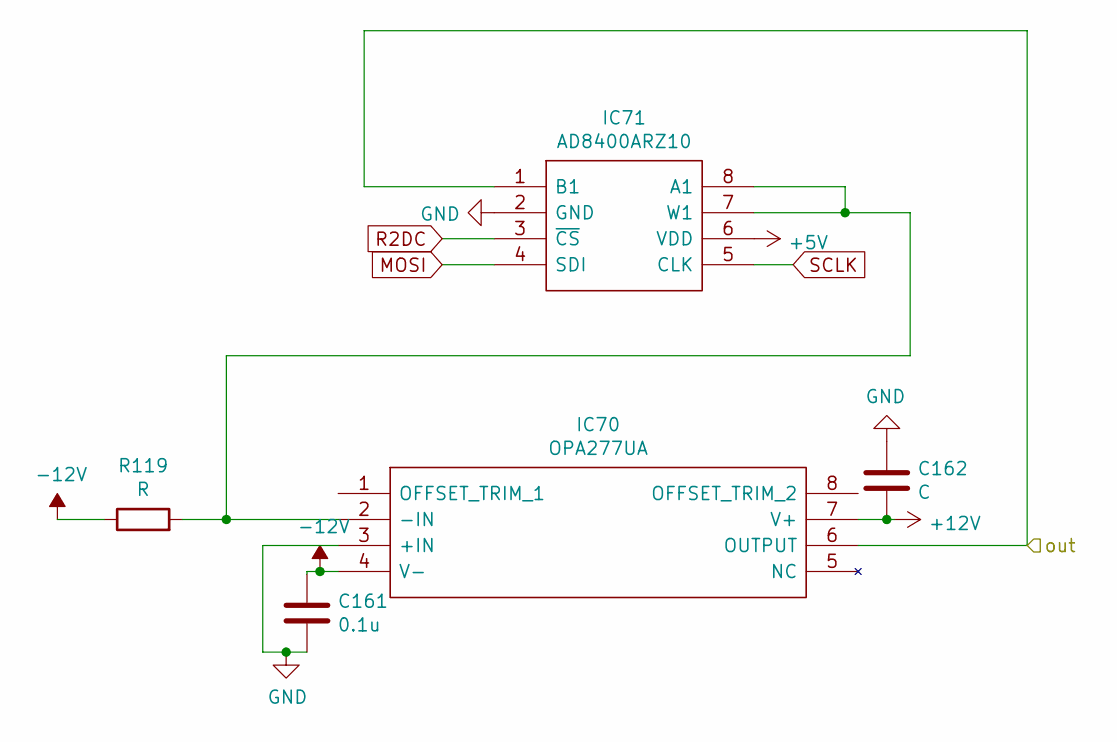
[picture p54: schematic DC2.sch]

Parts:
C161: 0.1u; C_0603_1608Metric_Pad1.08x0.95mm_HandSolder
C162: C; C_0603_1608Metric_Pad1.08x0.95mm_HandSolder
IC70: OPA277UA; SOIC127P600X175-8N; Manufacturer_Part_Number OPA277UA; Mouser Part Number 595-OPA277UA
IC71: AD8400ARZ10; SOIC127P600X175-8N; Manufacturer_Part_Number AD8400ARZ10; Mouser Part Number 584-AD8400ARZ10
R119: R; R_0603_1608Metric_Pad0.98x0.95mm_HandSolder

Connections:
+5V: IC71.6 (VDD); also elsewhere on the board
+12V: C162.2, IC70.7 (V+); also elsewhere on the board
-12V: C161.1, IC70.4 (V-), R119.1; also elsewhere on the board
/Sheet60A37CB5/MUX2/S2: IC70.6 (OUTPUT), IC71.1 (B1); also elsewhere on the board
GND: C161.2, C162.1, IC70.3 (+IN), IC71.2 (GND); also elsewhere on the board
MOSI: IC71.4 (SDI); also elsewhere on the board
unnamed: IC70.2 (-IN), IC71.7 (W1), IC71.8 (A1), R119.2
R2DC: IC71.3 (~CS); also elsewhere on the board
SCLK: IC71.5 (CLK); also elsewhere on the board

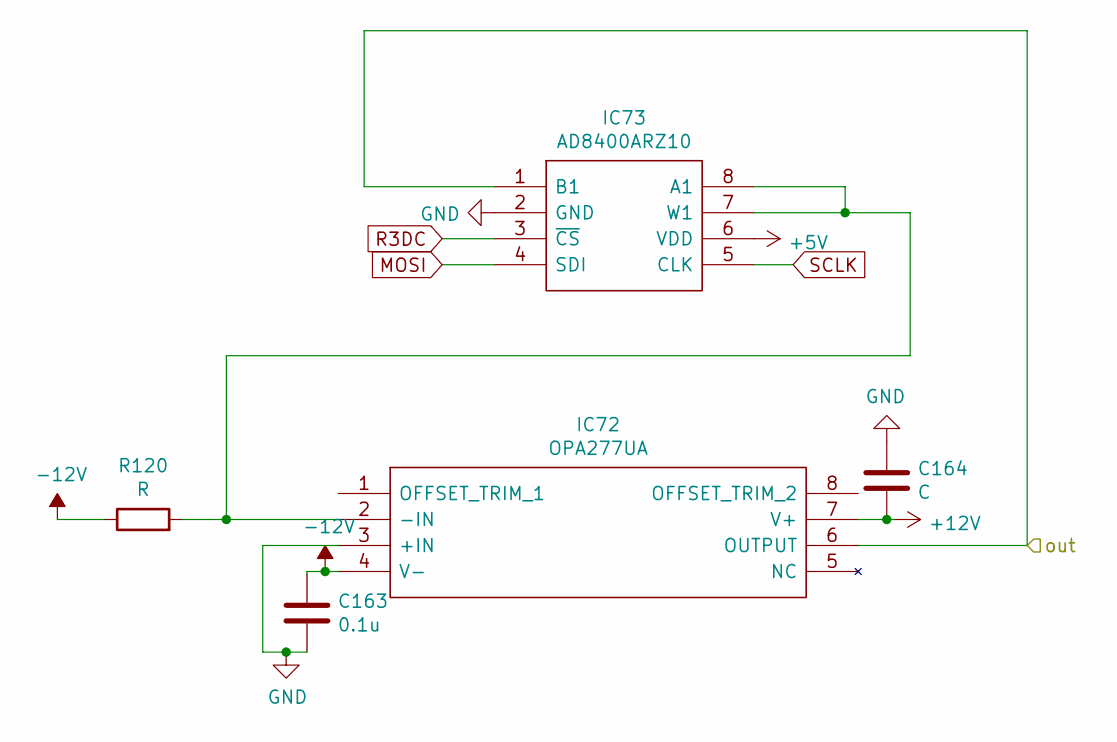
[picture p55: schematic DC3.sch]

Parts:
C163: 0.1u; C_0603_1608Metric_Pad1.08x0.95mm_HandSolder
C164: C; C_0603_1608Metric_Pad1.08x0.95mm_HandSolder
IC72: OPA277UA; SOIC127P600X175-8N; Manufacturer_Part_Number OPA277UA; Mouser Part Number 595-OPA277UA
IC73: AD8400ARZ10; SOIC127P600X175-8N; Manufacturer_Part_Number AD8400ARZ10; Mouser Part Number 584-AD8400ARZ10
R120: R; R_0603_1608Metric_Pad0.98x0.95mm_HandSolder

Connections:
+5V: IC73.6 (VDD); also elsewhere on the board
+12V: C164.2, IC72.7 (V+); also elsewhere on the board
-12V: C163.1, IC72.4 (V-), R120.1; also elsewhere on the board
/Sheet60A37CB5/MUX3/S2: IC72.6 (OUTPUT), IC73.1 (B1); also elsewhere on the board
GND: C163.2, C164.1, IC72.3 (+IN), IC73.2 (GND); also elsewhere on the board
MOSI: IC73.4 (SDI); also elsewhere on the board
unnamed: IC72.2 (-IN), IC73.7 (W1), IC73.8 (A1), R120.2
R3DC: IC73.3 (~CS); also elsewhere on the board
SCLK: IC73.5 (CLK); also elsewhere on the board

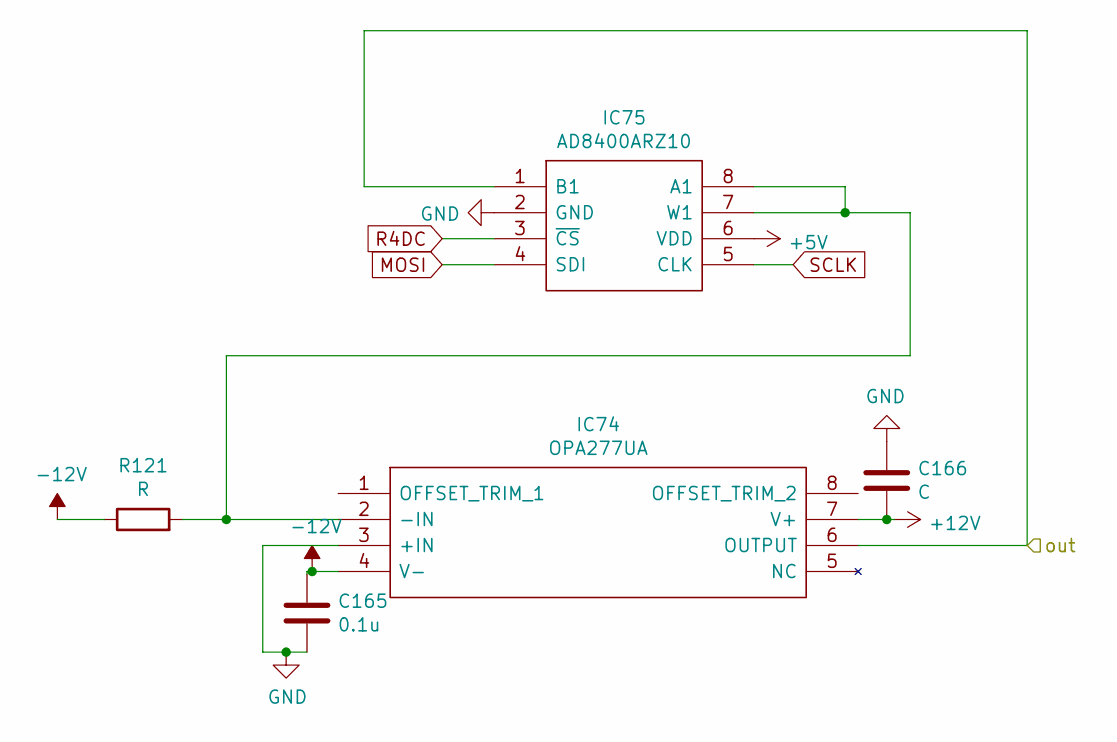
[picture p56: schematic DC4.sch]

Parts:
C165: 0.1u; C_0603_1608Metric_Pad1.08x0.95mm_HandSolder
C166: C; C_0603_1608Metric_Pad1.08x0.95mm_HandSolder
IC74: OPA277UA; SOIC127P600X175-8N; Manufacturer_Part_Number OPA277UA; Mouser Part Number 595-OPA277UA
IC75: AD8400ARZ10; SOIC127P600X175-8N; Manufacturer_Part_Number AD8400ARZ10; Mouser Part Number 584-AD8400ARZ10
R121: R; R_0603_1608Metric_Pad0.98x0.95mm_HandSolder

Connections:
+5V: IC75.6 (VDD); also elsewhere on the board
+12V: C166.2, IC74.7 (V+); also elsewhere on the board
-12V: C165.1, IC74.4 (V-), R121.1; also elsewhere on the board
/Sheet60A37CB5/MUX4/S2: IC74.6 (OUTPUT), IC75.1 (B1); also elsewhere on the board
GND: C165.2, C166.1, IC74.3 (+IN), IC75.2 (GND); also elsewhere on the board
MOSI: IC75.4 (SDI); also elsewhere on the board
unnamed: IC74.2 (-IN), IC75.7 (W1), IC75.8 (A1), R121.2
R4DC: IC75.3 (~CS); also elsewhere on the board
SCLK: IC75.5 (CLK); also elsewhere on the board

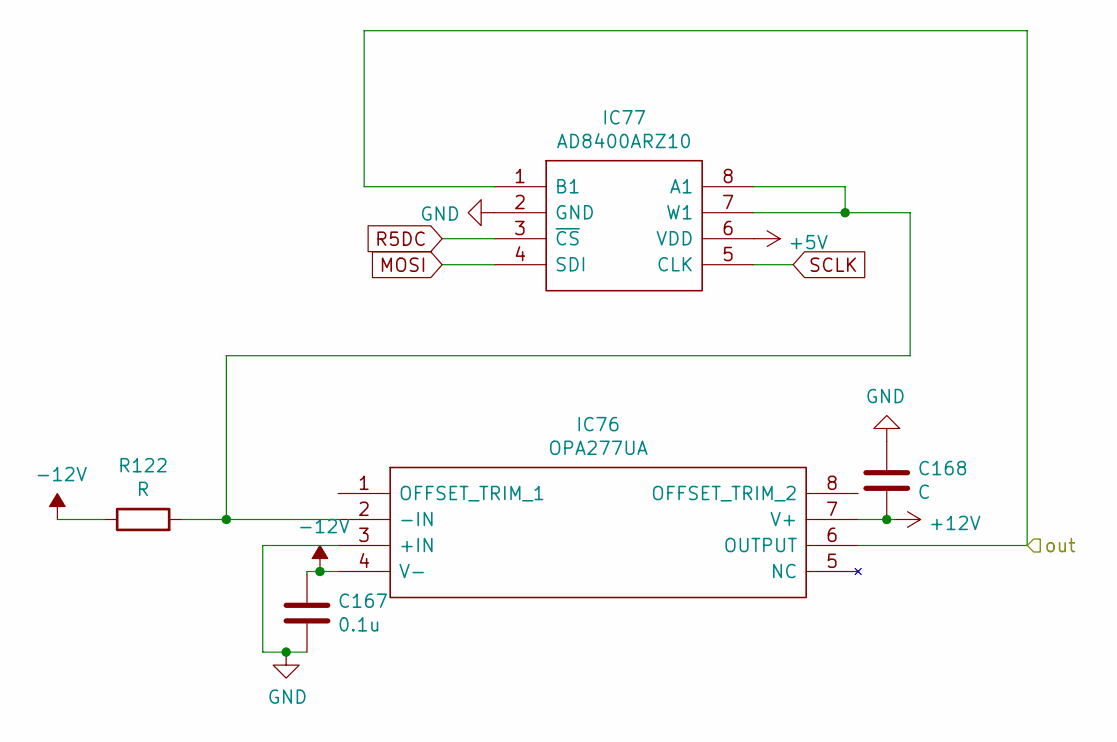
[picture p57: schematic DC5.sch]

Parts:
C167: 0.1u; C_0603_1608Metric_Pad1.08x0.95mm_HandSolder
C168: C; C_0603_1608Metric_Pad1.08x0.95mm_HandSolder
IC76: OPA277UA; SOIC127P600X175-8N; Manufacturer_Part_Number OPA277UA; Mouser Part Number 595-OPA277UA
IC77: AD8400ARZ10; SOIC127P600X175-8N; Manufacturer_Part_Number AD8400ARZ10; Mouser Part Number 584-AD8400ARZ10
R122: R; R_0603_1608Metric_Pad0.98x0.95mm_HandSolder

Connections:
+5V: IC77.6 (VDD); also elsewhere on the board
+12V: C168.2, IC76.7 (V+); also elsewhere on the board
-12V: C167.1, IC76.4 (V-), R122.1; also elsewhere on the board
/Sheet60A37CB5/MUX5/S2: IC76.6 (OUTPUT), IC77.1 (B1); also elsewhere on the board
GND: C167.2, C168.1, IC76.3 (+IN), IC77.2 (GND); also elsewhere on the board
MOSI: IC77.4 (SDI); also elsewhere on the board
unnamed: IC76.2 (-IN), IC77.7 (W1), IC77.8 (A1), R122.2
R5DC: IC77.3 (~CS); also elsewhere on the board
SCLK: IC77.5 (CLK); also elsewhere on the board

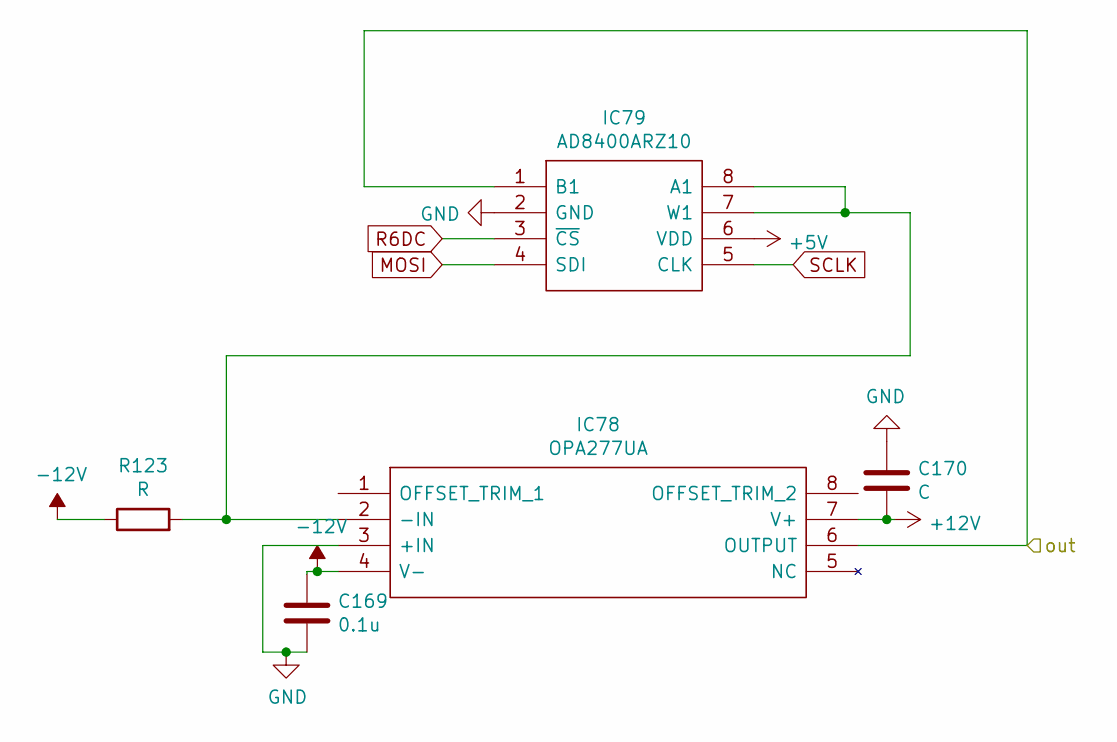
[picture p58: schematic DC6.sch]

Parts:
C169: 0.1u; C_0603_1608Metric_Pad1.08x0.95mm_HandSolder
C170: C; C_0603_1608Metric_Pad1.08x0.95mm_HandSolder
IC78: OPA277UA; SOIC127P600X175-8N; Manufacturer_Part_Number OPA277UA; Mouser Part Number 595-OPA277UA
IC79: AD8400ARZ10; SOIC127P600X175-8N; Manufacturer_Part_Number AD8400ARZ10; Mouser Part Number 584-AD8400ARZ10
R123: R; R_0603_1608Metric_Pad0.98x0.95mm_HandSolder

Connections:
+5V: IC79.6 (VDD); also elsewhere on the board
+12V: C170.2, IC78.7 (V+); also elsewhere on the board
-12V: C169.1, IC78.4 (V-), R123.1; also elsewhere on the board
/Sheet60A37CB5/MUX6/S2: IC78.6 (OUTPUT), IC79.1 (B1); also elsewhere on the board
GND: C169.2, C170.1, IC78.3 (+IN), IC79.2 (GND); also elsewhere on the board
MOSI: IC79.4 (SDI); also elsewhere on the board
unnamed: IC78.2 (-IN), IC79.7 (W1), IC79.8 (A1), R123.2
R6DC: IC79.3 (~CS); also elsewhere on the board
SCLK: IC79.5 (CLK); also elsewhere on the board

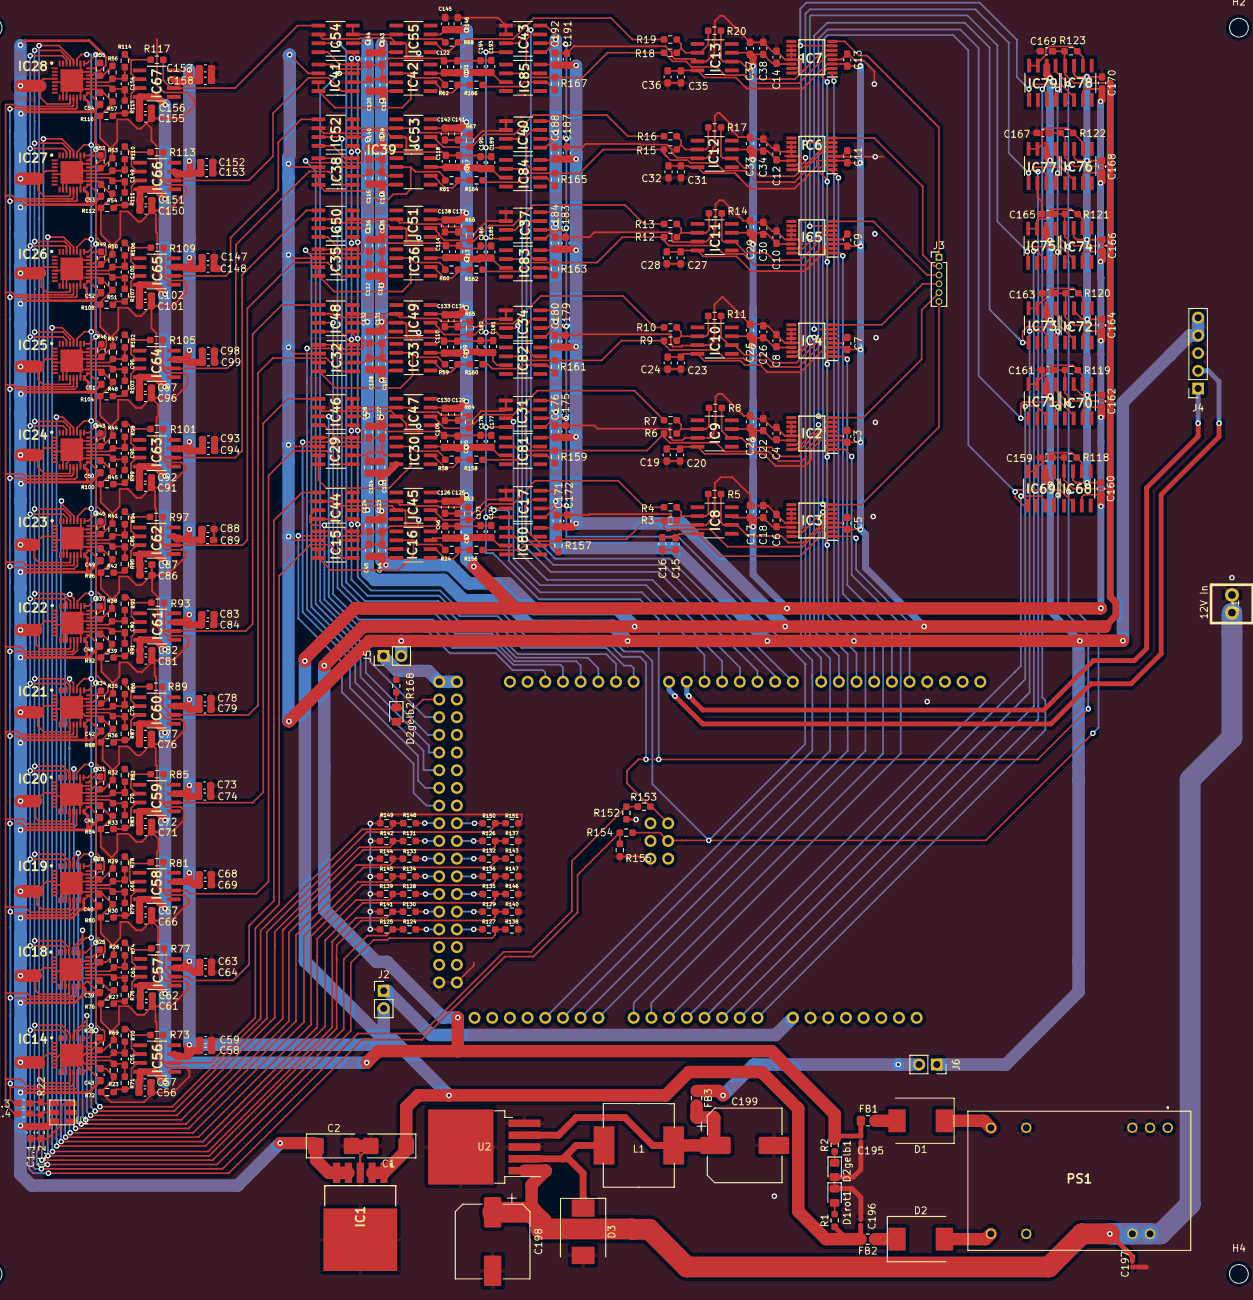
[picture p59: board circuit_DEP.kicad_pcb from above]

Board: 2 copper layers, 480 parts (1 on the bottom side), 237 nets.
